IMD555/BTKB/Photo/WP_20181024_00_50_31_Pro_LI (2).jpg

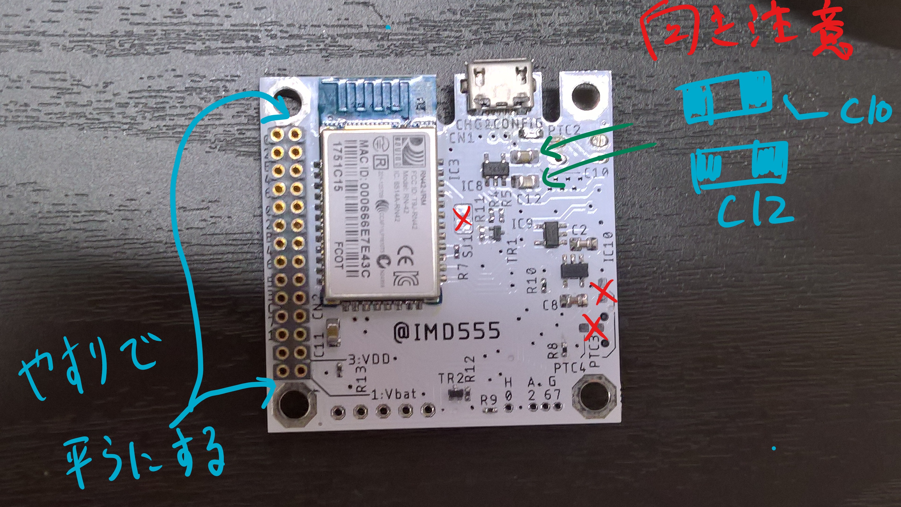
Photo/WP_20181024_00_50_31_Pro_LI (2).jpg
