IMD555/BTKB/Photo/WP_20181027_11_53_10_Pro.jpg

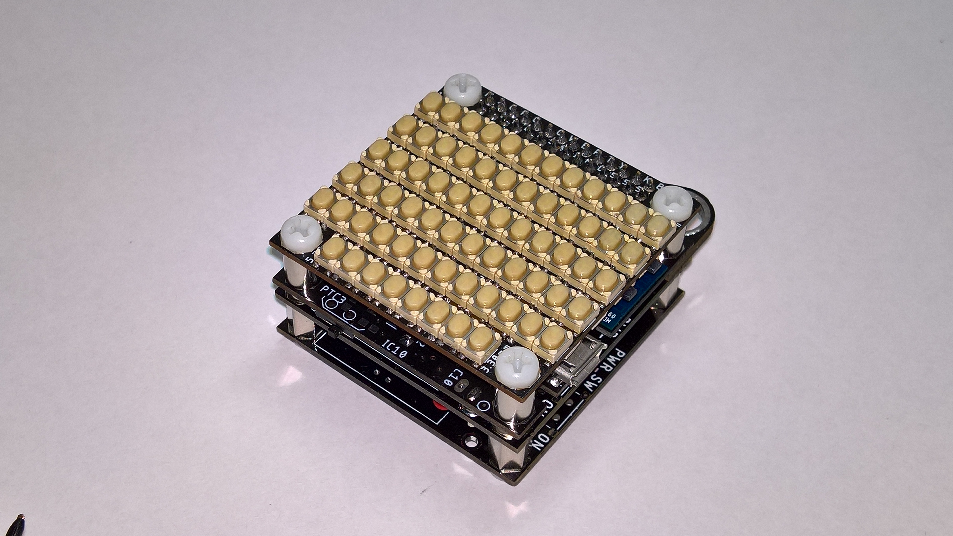
Photo/WP_20181027_11_53_10_Pro.jpg
