IMD555/BTKB/Datasheet/THAM05-N.jpg

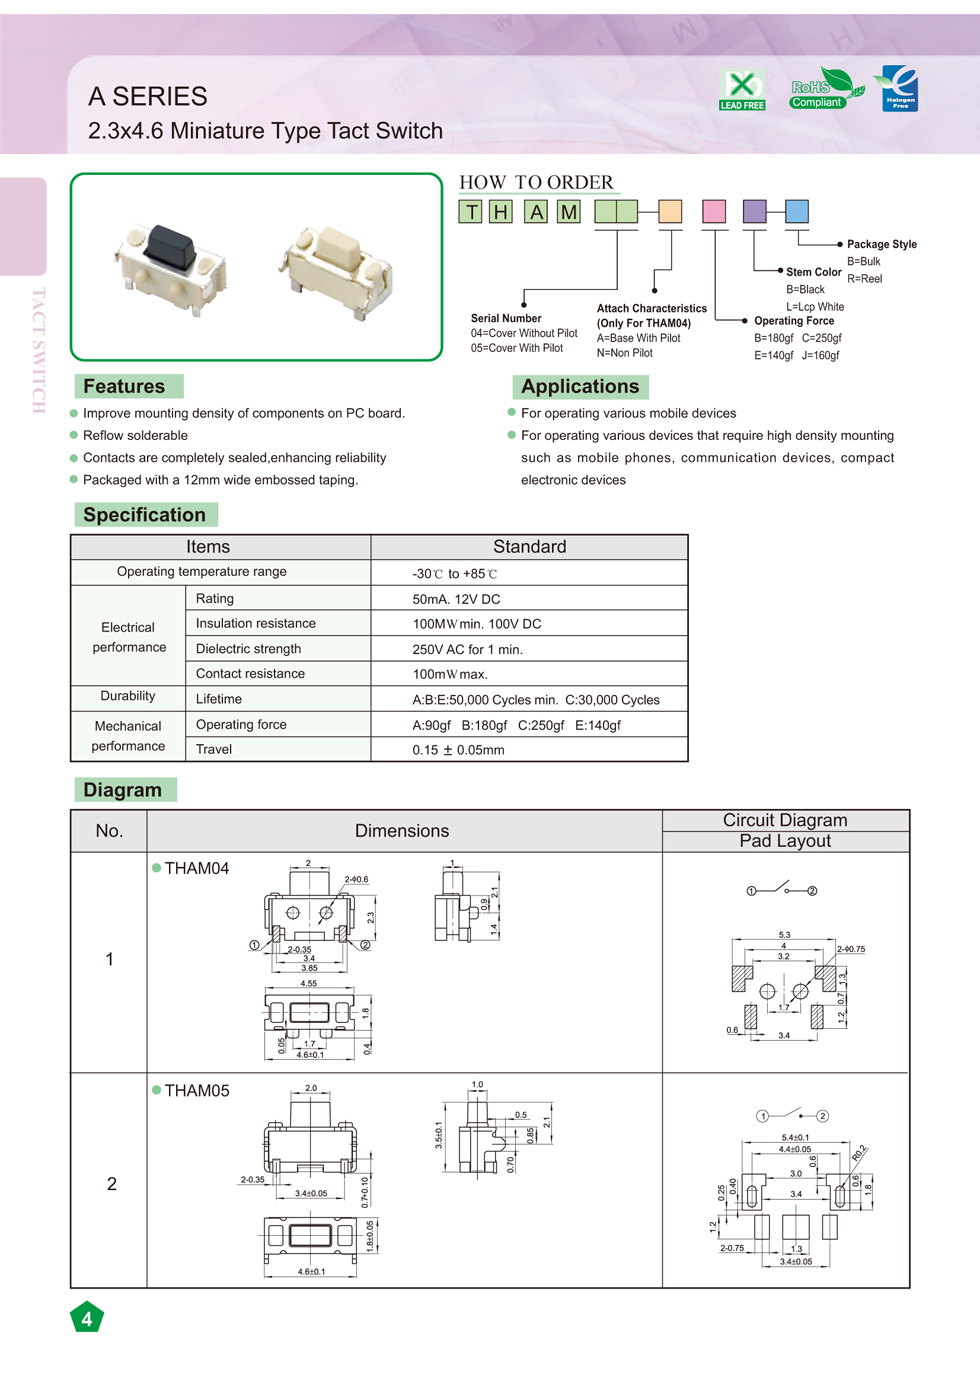
Datasheet/THAM05-N.jpg
