IMD555/BTKB/ORIGINAL_キーマップ.png

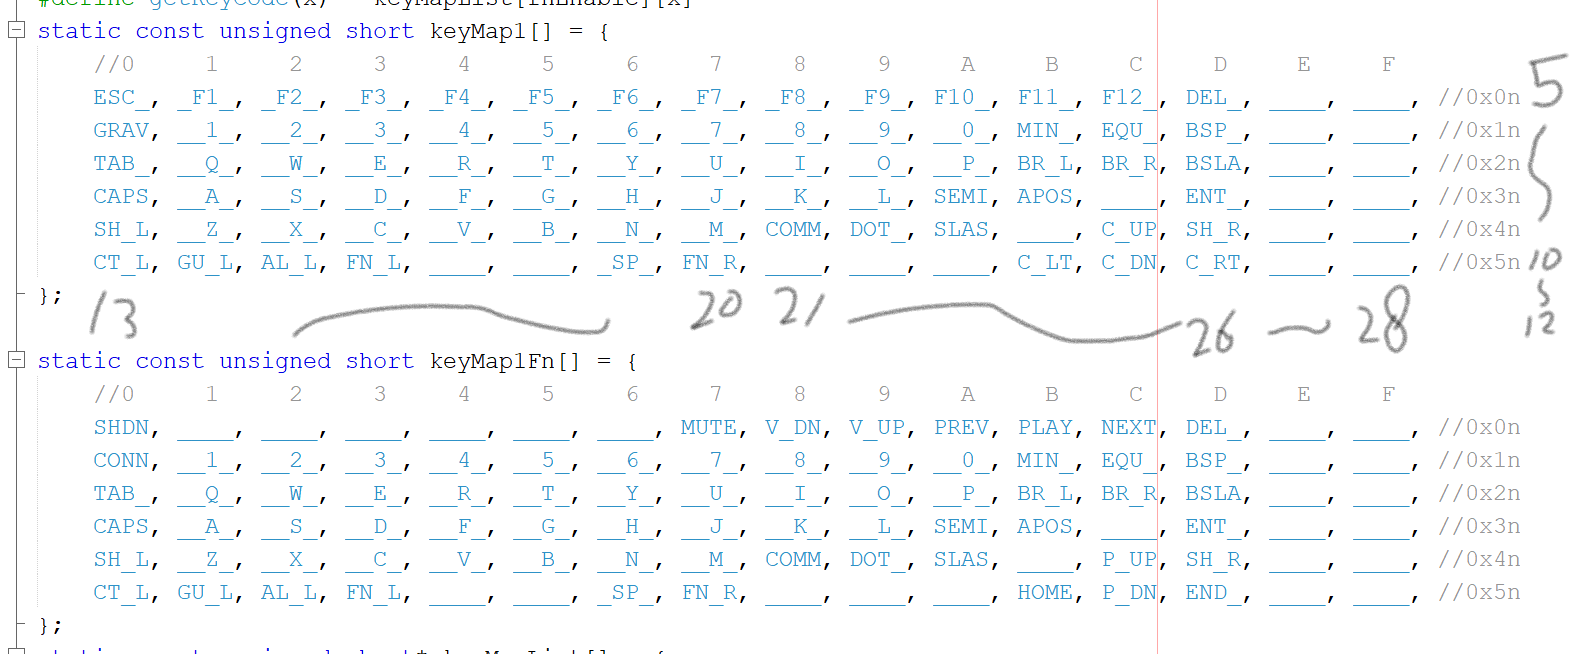
ORIGINAL_キーマップ.png
