IMD555/BTKB/Photo/backlight.png

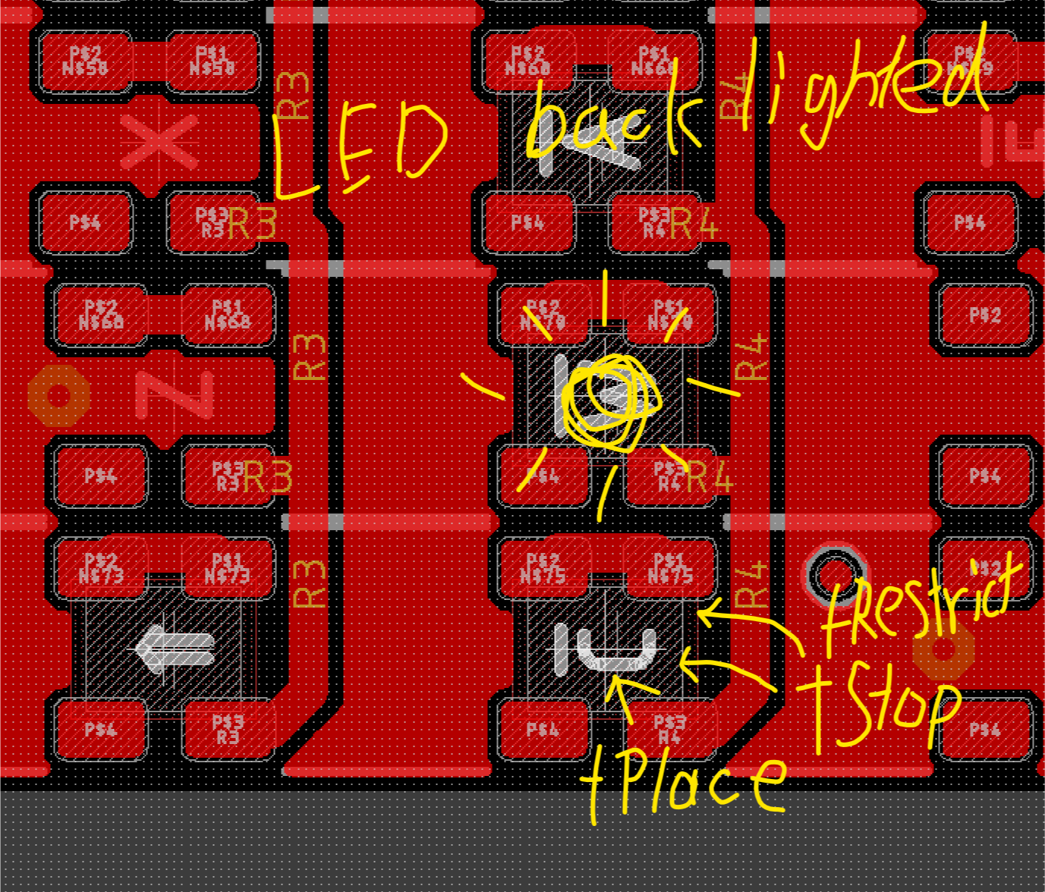
Photo/backlight.png
