IMD555/BTKB/Photo/booth.png

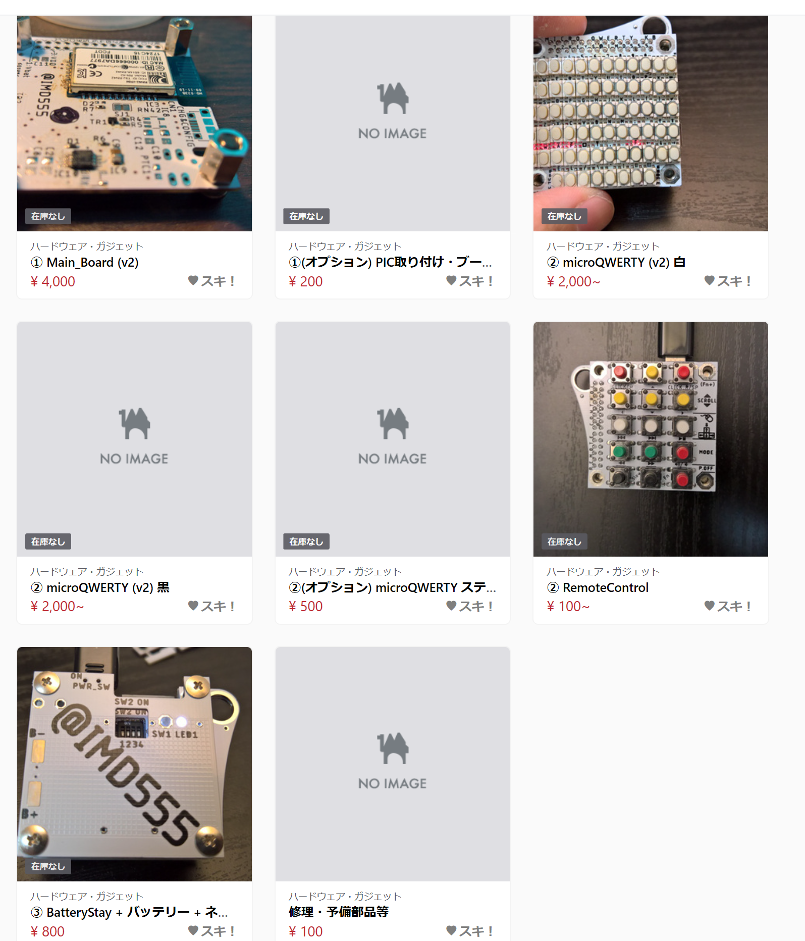
Photo/booth.png
