IMD555/BTKB/Photo/InkedJIS_LI.jpg

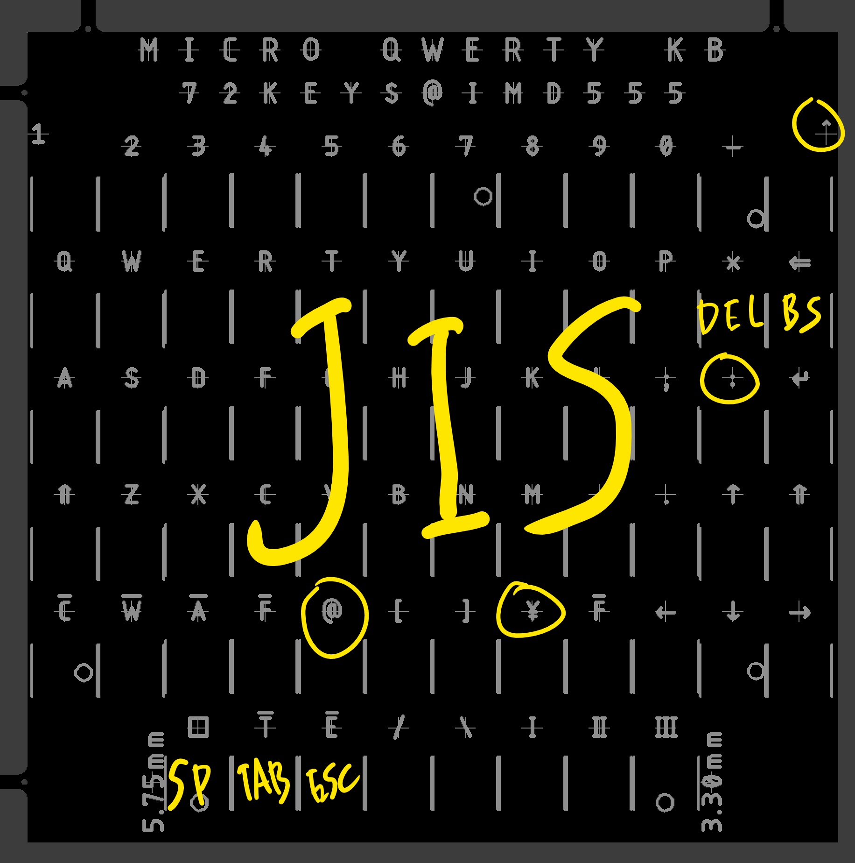
Photo/InkedJIS_LI.jpg
