IMD555/BTKB/Photo/Inkedset_LI.jpg

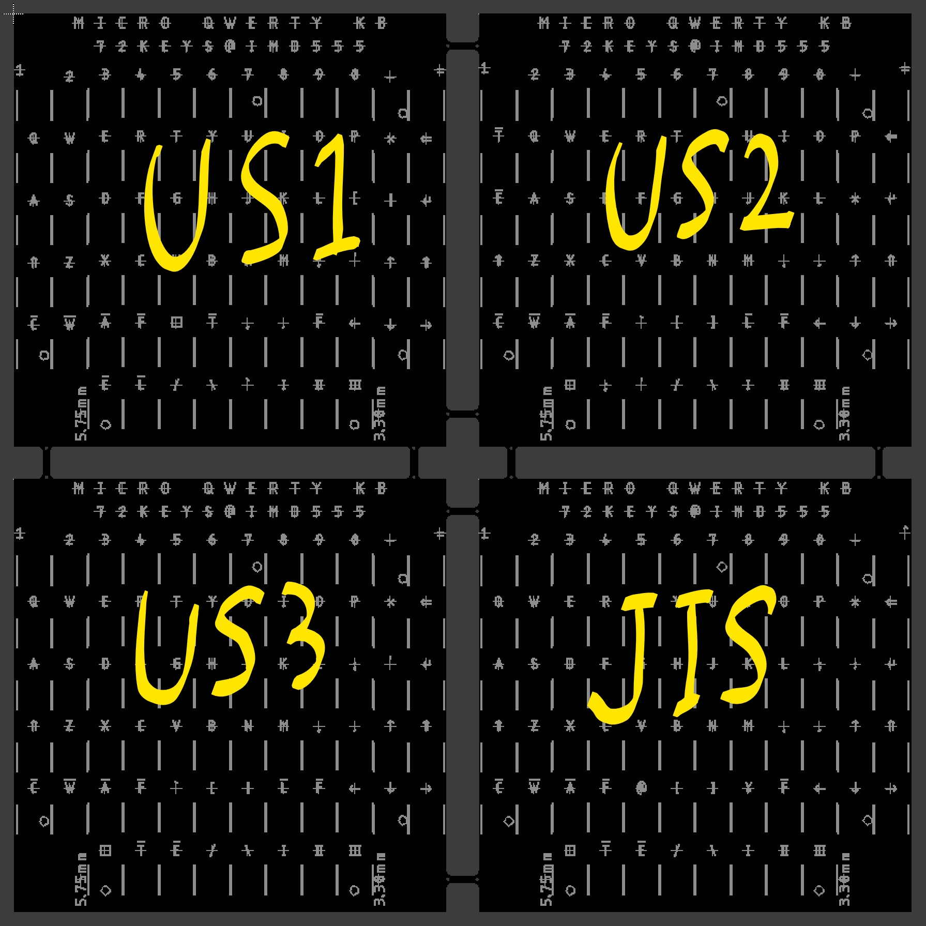
Photo/Inkedset_LI.jpg
