IMD555/BTKB/Photo/InkedUS1_LI.jpg

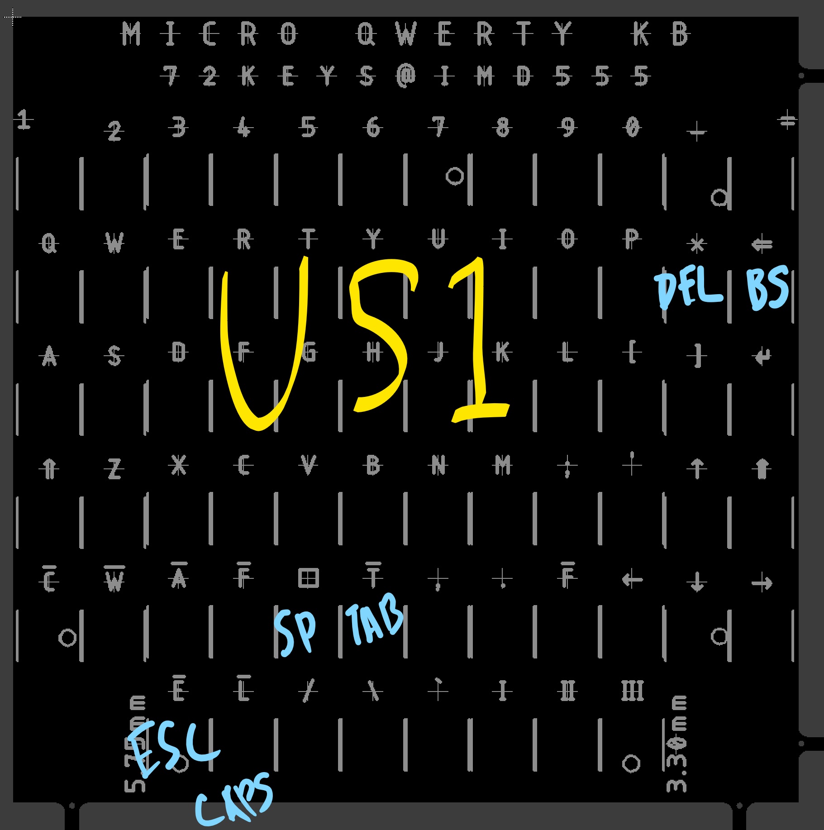
Photo/InkedUS1_LI.jpg
