IMD555/BTKB/Photo/InkedUS2_LI.jpg

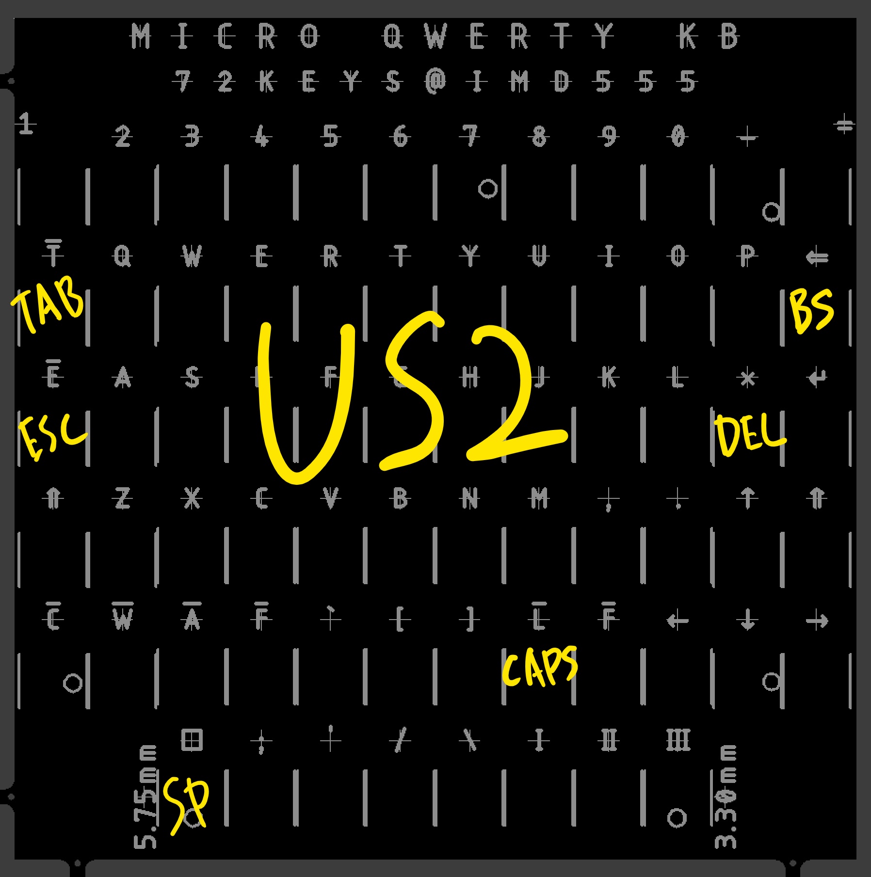
Photo/InkedUS2_LI.jpg
