IMD555/BTKB/Photo/InkedUS3_LI.jpg

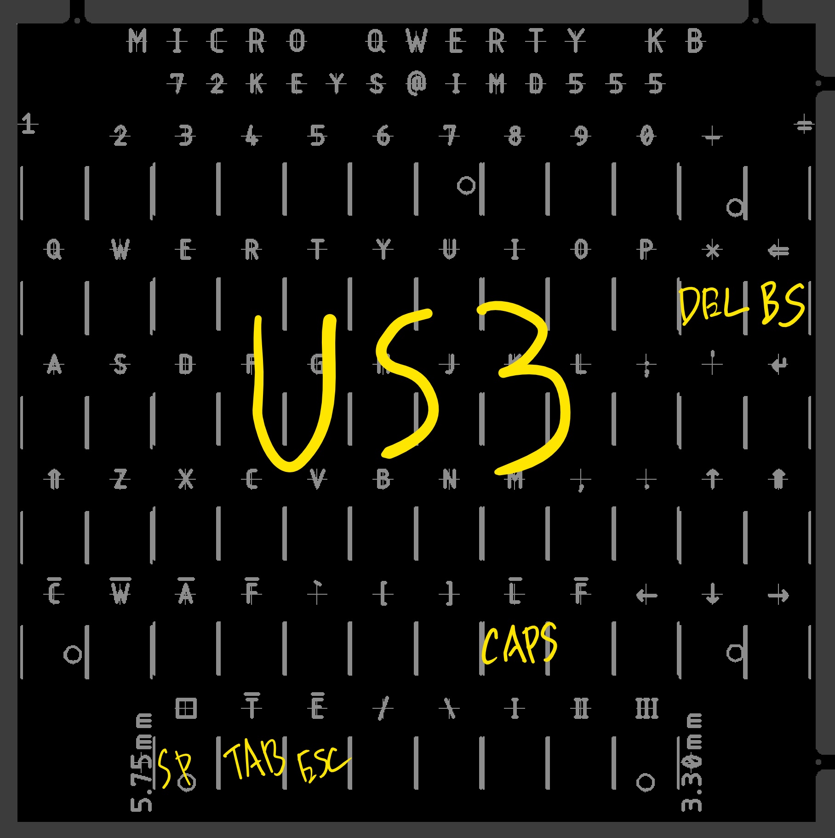
Photo/InkedUS3_LI.jpg
