IMD555/BTKB/Photo/JIS.png

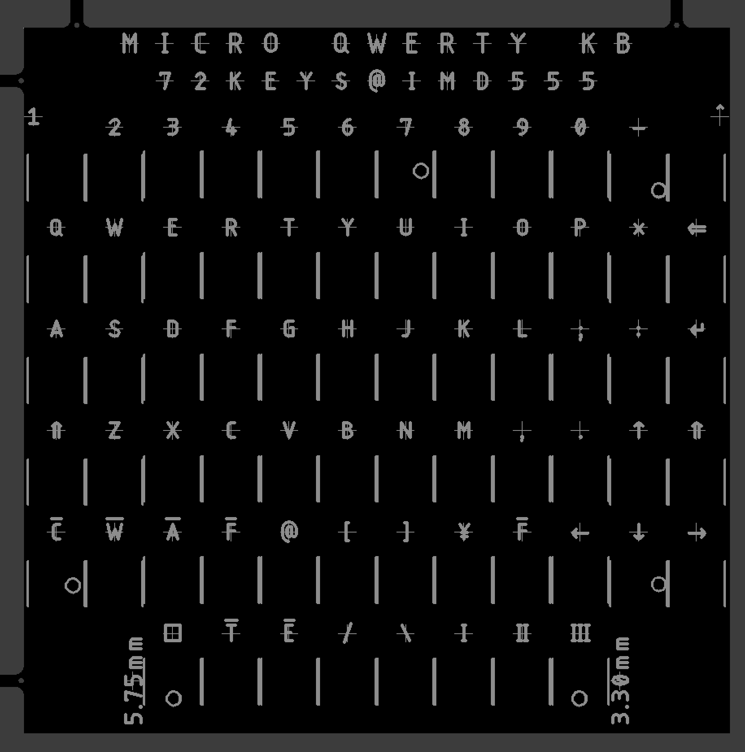
Photo/JIS.png
