IMD555/BTKB/Photo/set.png

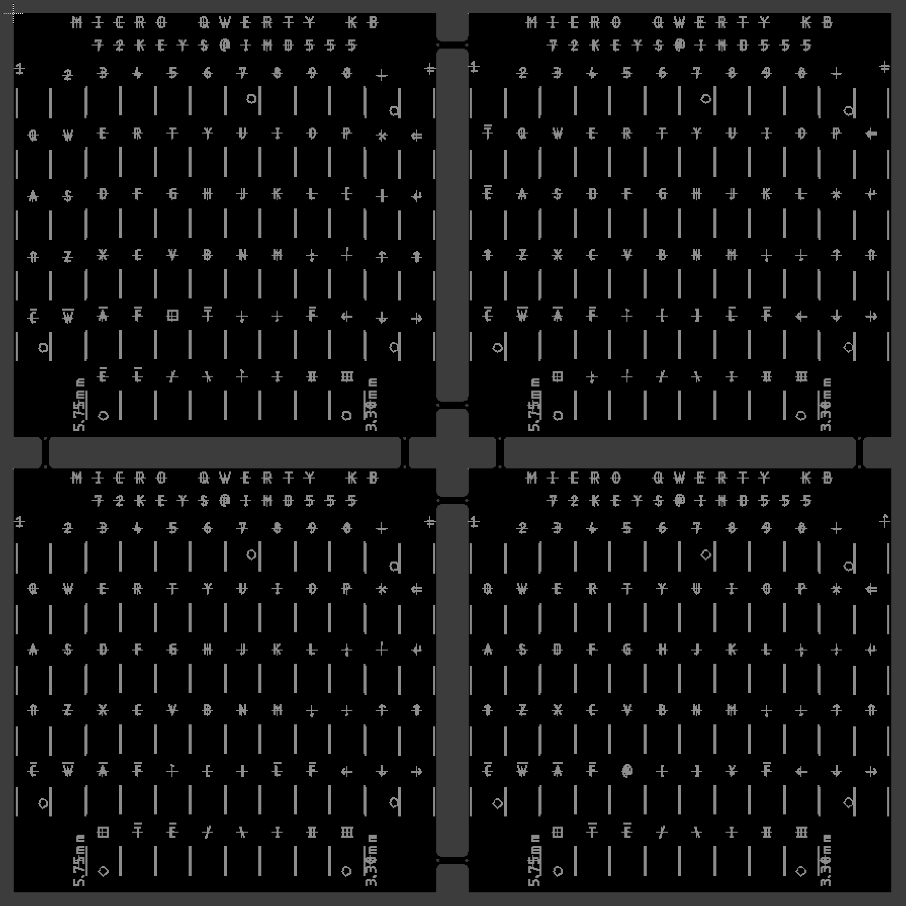
Photo/set.png
