IMD555/BTKB/Photo/US1.png

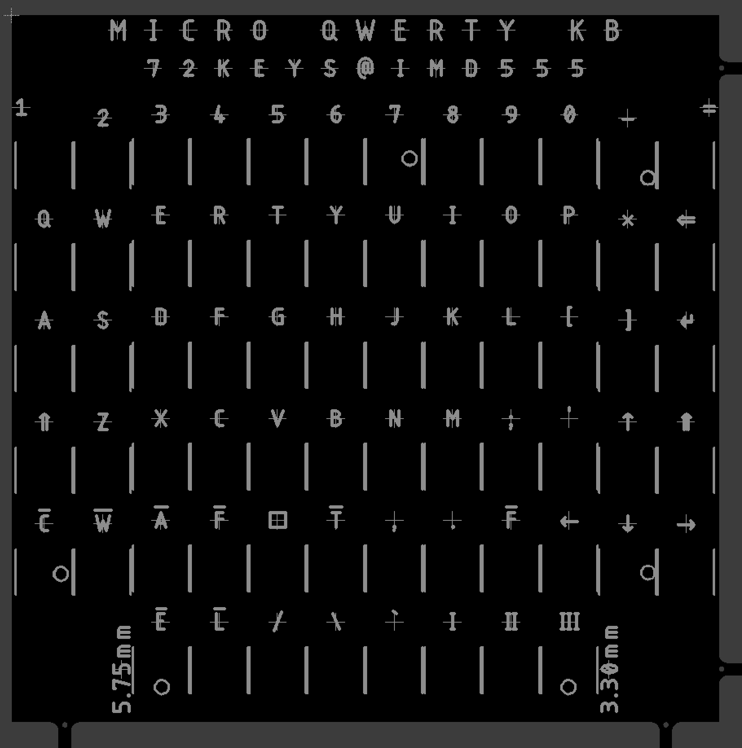
Photo/US1.png
