IMD555/BTKB/Photo/US2.png

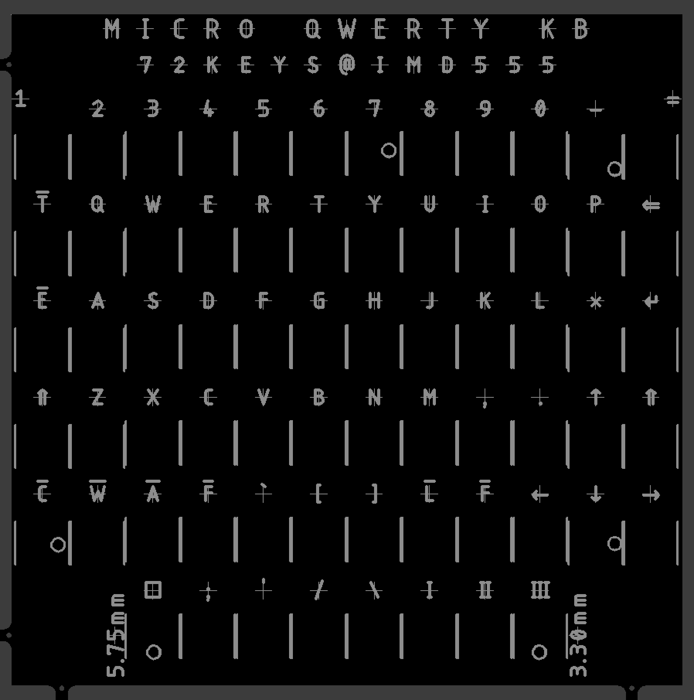
Photo/US2.png
