IMD555/BTKB/Photo/US3.png

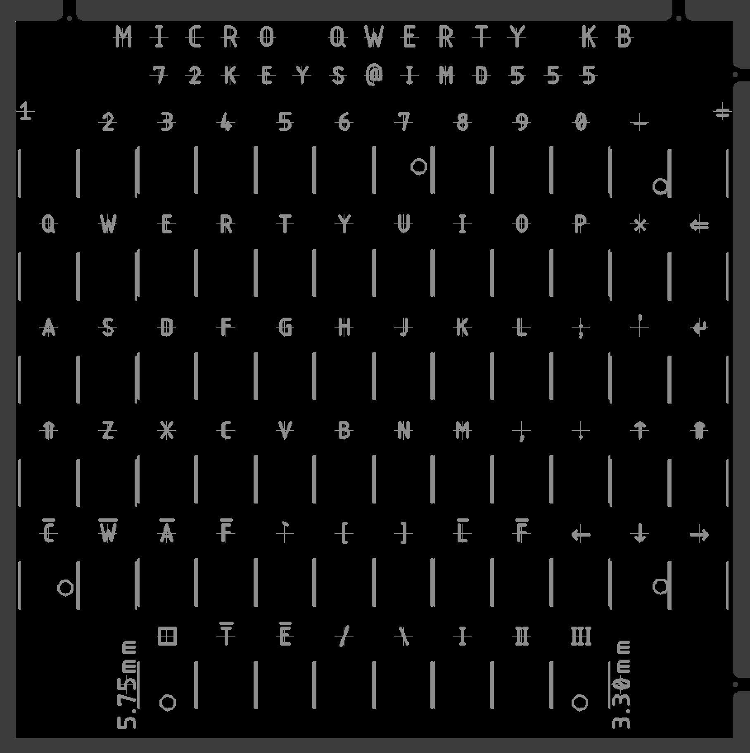
Photo/US3.png
