IMD555/BTKB/Photo/WP_20180513_21_15_03_Pro.jpg

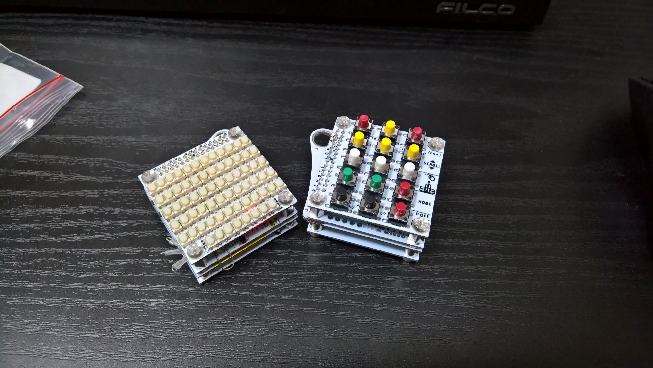
Photo/WP_20180513_21_15_03_Pro.jpg
