IMD555/BTKB/Photo/WP_20180825_12_07_29_Pro_LI.jpg

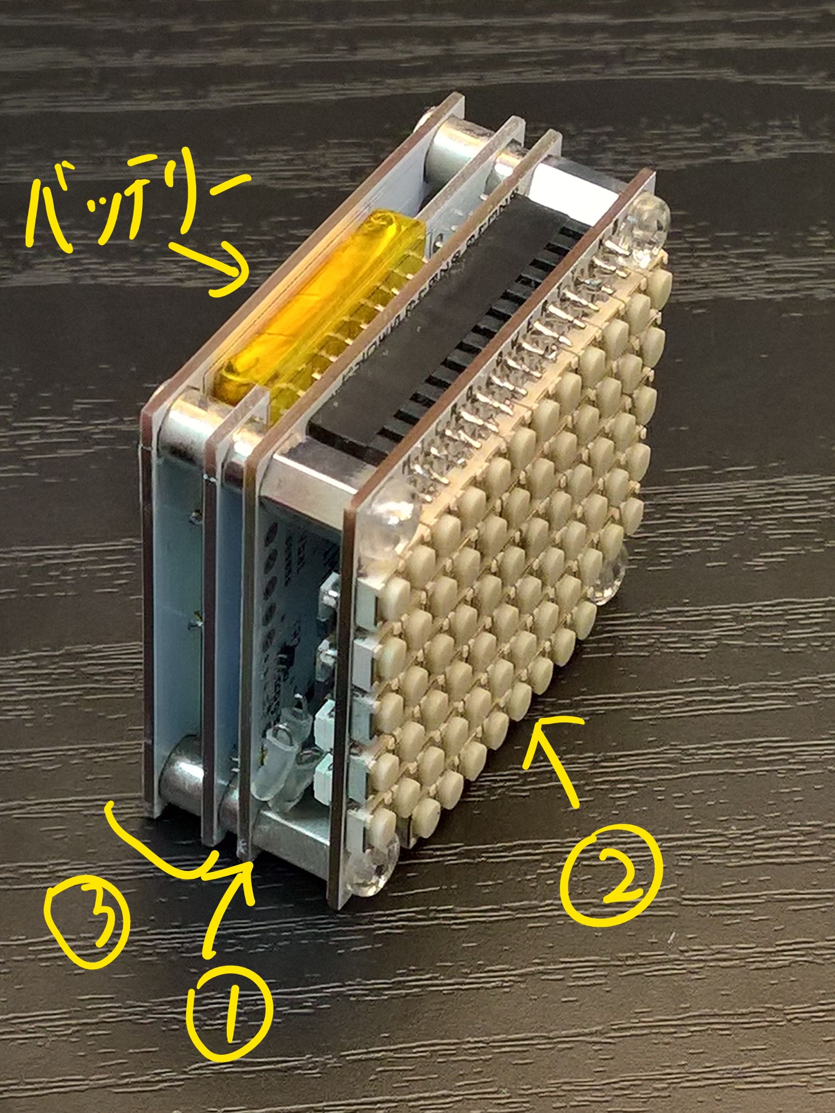
Photo/WP_20180825_12_07_29_Pro_LI.jpg
