IMD555/BTKB/Photo/WP_20181024_00_50_26_Pro_LI.jpg

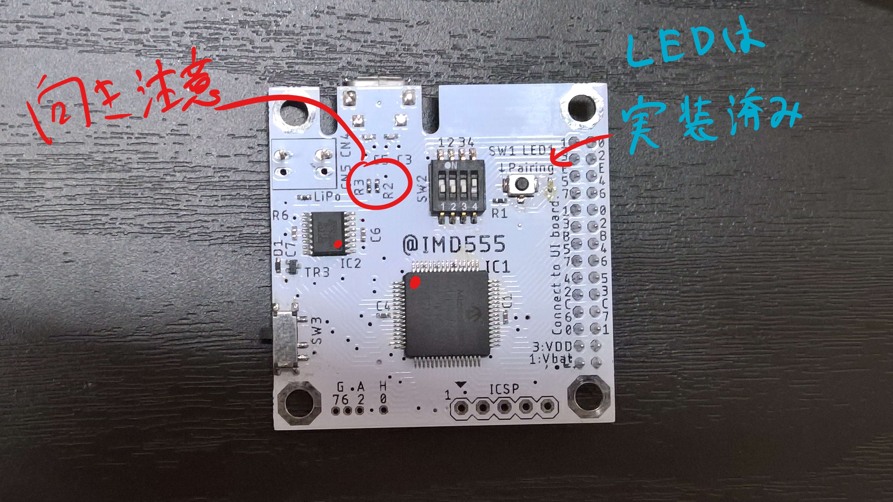
Photo/WP_20181024_00_50_26_Pro_LI.jpg
