IMD555/BTKB/Photo/WP_20181027_11_49_59_Pro.jpg

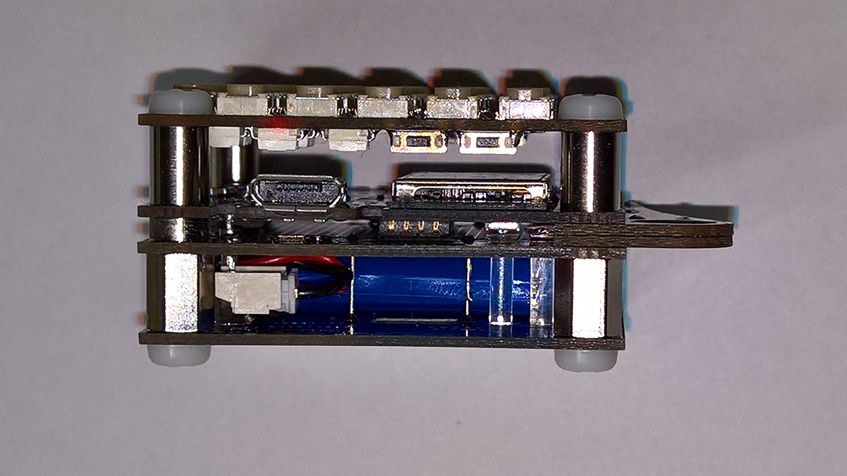
Photo/WP_20181027_11_49_59_Pro.jpg
