IMD555/BTKB/Photo/WP_20181027_11_50_17_Pro.jpg

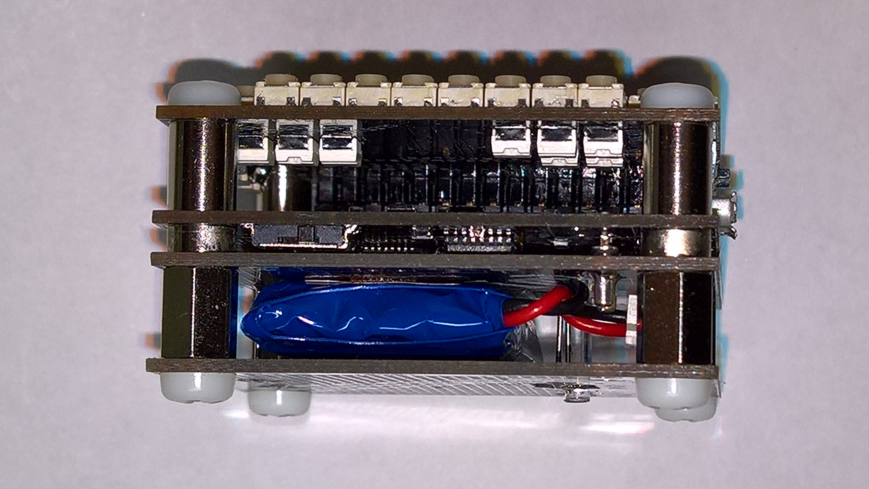
Photo/WP_20181027_11_50_17_Pro.jpg
