IMD555/BTKB/Photo/WP_20181027_11_50_39_Pro.jpg

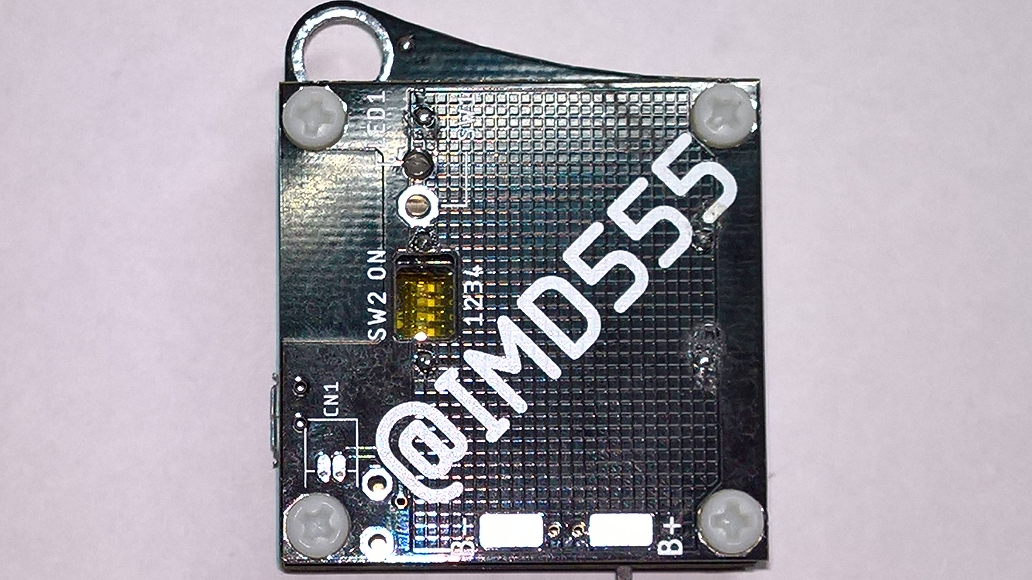
Photo/WP_20181027_11_50_39_Pro.jpg
