IMD555/BTKB/Photo/WP_20181027_11_52_42_Pro.jpg

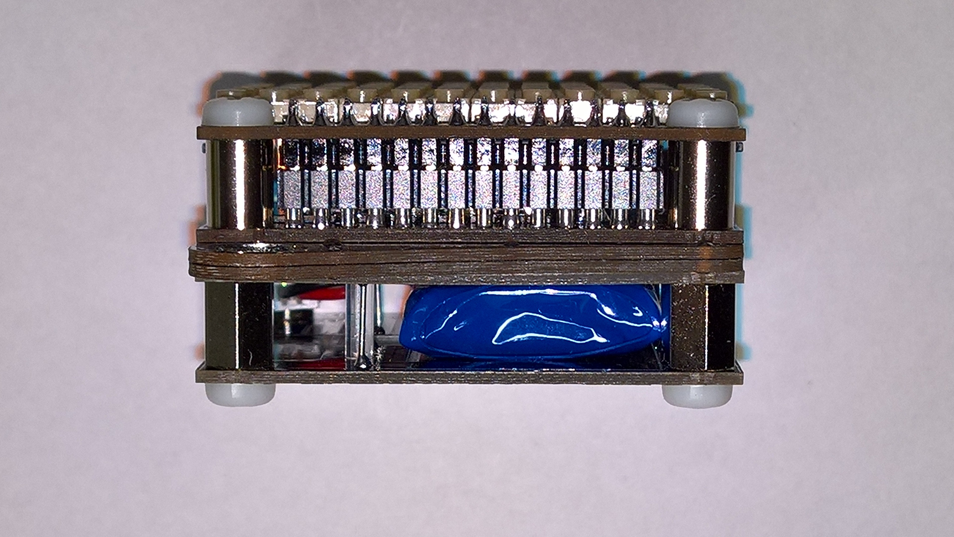
Photo/WP_20181027_11_52_42_Pro.jpg
