IMD555/BTKB/Photo/WP_20181027_11_58_30_Pro.jpg

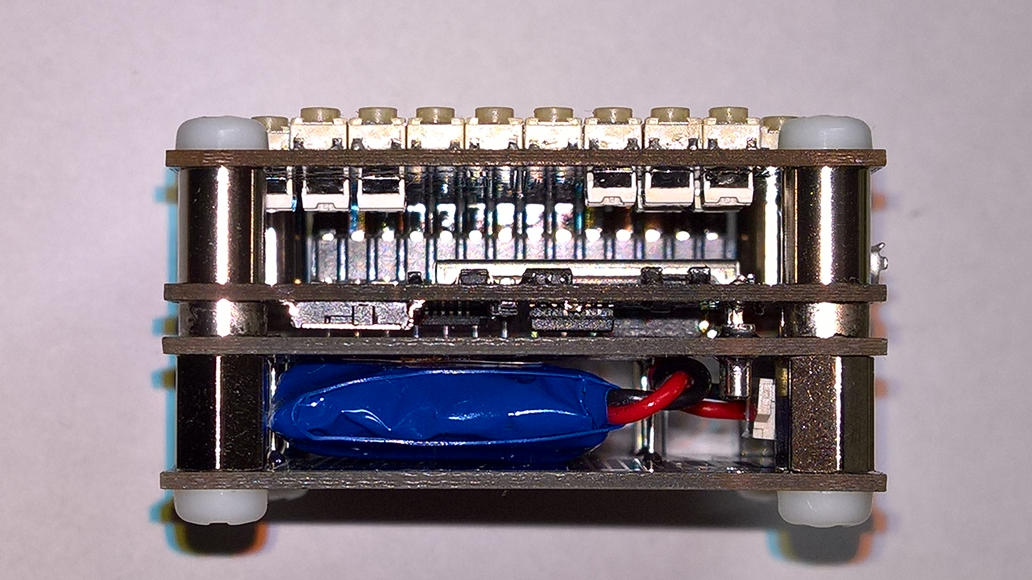
Photo/WP_20181027_11_58_30_Pro.jpg
