IMD555/BTKB/部品表.xlsx

Sheet: 部品表
 |  |  |  |  | 振込先:金融機関コード 0501 店番 485 普通預金 3086650 |  |  | yohewi | toby_net | Man_Nyomo | Mizincor | fafaway1234 | E_M_P_ | yohewi | toby_net | Man_Nyomo | Mizincor | fafaway1234 | E_M_P_
 |  |  |  |  | 名前 ｲﾏﾀﾞ ｶｽﾞﾎ |  |  |  |  |  |  |  |  | 合計金額
 |  |  |  |  | (北洋銀行 札幌市役所支店) |  |  |  |  |  |  |  |  | 5397 | 7379 | 5437 | 6294 | 4863 | 7379
実装順 | 部品番号 | 部品名 | 型番 | 形状 | 備考・注意事項 | 購入元 | 単価 | 数量 |  |  |  |  |  | 小計
 |  | 基板 | Main_Board | - | t1.0 パターン修正(別Sheet参照)・配線追加あり(別Sheet参照) |  | 0 | 1 | 1 | 1 | 1 | 1 | 1 | 0 | 0 | 0 | 0 | 0 | 0
0 | LED1 | LED(青) | SML-P13BC8TT86 | 1006 | 実装済み | Chip One Stop | 20 | 1 | 0 | 1 | 1 | 1 | 1 | 20 | 0 | 20 | 20 | 20 | 20
0 | *LED1 | LED(緑) | SML-P12MTT86R | 1006 | 実装済み | Chip One Stop | 20 | 0 | 1 | 0 | 0 | 0 | 0 | 0 | 20 | 0 | 0 | 0 | 0
1 | IC1 | マイコン | PIC18LF67K40 | TQFP64 | 一部ピンのみはんだ付け済み、ブートローダー書き込み済み 56-57ピン間は短絡していてOK はんだ付け参考 https://www.youtube.com/watch?v=-l5D2em4PBI | digikey | 301 | 1 | 1 | 1 | 1 | 1 | 1 | 301 | 301 | 301 | 301 | 301 | 301
1 | IC2 | USB-UART IC | FT230X | SSOP16 | ズレないように注意! 10-11ピン間は短絡していてOK | digikey | 238 | 1 | 1 | 1 | 1 | 1 | 1 | 238 | 238 | 238 | 238 | 238 | 238
2 | IC10 | 3.3V電源IC | MCP1253-33X50 | MSOP8 | ズレないように注意! | Chip One Stop | 175 | 1 | 1 | 1 | 1 | 1 | 1 | 175 | 175 | 175 | 175 | 175 | 175
2 | IC3 | Bluetoothモジュール | RN42 |  | 四隅の内側に入っているパッドははんだ付けしなくてよい フラックスクリーナー等でこするとインクが薄くなるので、技適マークを消さないように注意 | 秋月電子 | 1800 | 1 | 1 | 1 | 1 | 1 | 1 | 1800 | 1800 | 1800 | 1800 | 1800 | 1800
2 | IC8 | LiPo充電IC | MCP73832 | SOT23-5 | KK5I、IC9と間違えないように！ | digikey | 62 | 1 | 1 | 1 | 1 | 1 | 1 | 62 | 62 | 62 | 62 | 62 | 62
2 | IC9 | 低電圧検出IC | BD4931G | SOT23-5 | FM0Q19、IC8と間違えないように！ | Chip One Stop | 30 | 1 | 1 | 1 | 1 | 1 | 1 | 30 | 30 | 30 | 30 | 30 | 30
2 | CN1 | USBコネクタ | 10118194-0001LF |  | イモハンダにならないように注意(特にGNDの5ピン) 内側にハンダが入らないように、シールドは裏側からはんだ付け推奨 シールド中央のパッドははんだ付けしなくてよい | digikey | 54 | 1 | 1 | 1 | 1 | 1 | 1 | 54 | 54 | 54 | 54 | 54 | 54
3 | PTC1 | リセッタブルヒューズ | 250mA 100mA 0ZCM0010FF2G | 1608 |  | digikey | 19 | 1 | 1 | 1 | 1 | 1 | 1 | 19 | 19 | 19 | 19 | 19 | 19
3 | C9 | コンデンサ 1u |  | 2012 |  | RS? | 5 | 1 | 1 | 1 | 1 | 1 | 1 | 5 | 5 | 5 | 5 | 5 | 5
3 | C2, C8, C10, C11, C12 | コンデンサ 4.7u |  | 2012 | C11のみ縦向き(他は横) | digikey | 7 | 5 | 5 | 5 | 5 | 5 | 5 | 35 | 35 | 35 | 35 | 35 | 35
4 | C1, C4, C6, C7 | コンデンサ 0.1u |  | 1005 | 予備1 | digikey | 1 | 5 | 5 | 5 | 5 | 5 | 5 | 5 | 5 | 5 | 5 | 5 | 5
4 | C3, C5 | コンデンサ 47p |  | 1005 | 予備1 | digikey | 1 | 3 | 3 | 3 | 3 | 3 | 3 | 3 | 3 | 3 | 3 | 3 | 3
5 | R1 | 抵抗 330 |  | 1005 | 予備1、LEDが眩しいためR1は1kか3.3k推奨、抵抗は黒い面が表 | digikey | 1 | 2 | 2 | 2 | 2 | 2 | 2 | 2 | 2 | 2 | 2 | 2 | 2
5 | *R1 | 抵抗 1k |  | 1005 | 予備1 | digikey | 1 | 2 | 2 | 2 | 2 | 2 | 2 | 2 | 2 | 2 | 2 | 2 | 2
5 | R2, R3 | 抵抗 27 |  | 1005 | 予備1 | digikey | 1 | 3 | 3 | 3 | 3 | 3 | 3 | 3 | 3 | 3 | 3 | 3 | 3
6 | R4, R7, R9, R10 | 抵抗 10k |  | 1005 | 予備1、R10はD1に実装 | digikey | 1 | 5 | 5 | 5 | 5 | 5 | 5 | 5 | 5 | 5 | 5 | 5 | 5
6 | R5 | 抵抗 3.3k |  | 1005 | 予備1 | digikey | 1 | 2 | 2 | 2 | 2 | 2 | 2 | 2 | 2 | 2 | 2 | 2 | 2
6 | R8 | 抵抗 33k |  | 1005 | 予備1 | digikey | 1 | 2 | 2 | 2 | 2 | 2 | 2 | 2 | 2 | 2 | 2 | 2 | 2
6 | D2 | ダイオード | RB520CS | VMN2 | SJ1側がカソードインデックス | Chip One Stop | 20 | 1 | 1 | 1 | 1 | 1 | 1 | 20 | 20 | 20 | 20 | 20 | 20
6 | TR1, TR2 | MOSFET | DMG1012T-7 | SOT523 |  | Chip One Stop | 6 | 2 | 2 | 2 | 2 | 2 | 2 | 12 | 12 | 12 | 12 | 12 | 12
6 | 追加配線 | 単心ワイヤー(心線0.6mm以下) |  |  | 難易度が上がるため、配線追加はピンソケット実装前に行うこと(前述、別Sheet参照)
7 | CN2 | ピンソケット (ピンヘッダーから変更) | 半分のNPPN302AFCN-RC |  | スペーサーに干渉するため、両端をピンヘッダーと同じ長さまでやすりで整える ハンダが樹脂部分まで上がるとピンヘッダーが刺さらなくなるので、ハンダをかなり少なめにする 刺さらなくなってしまった場合、一度取り外し、同封の余り部分のピンを差し替える | digikey | 200 | 1 | 1 | 1 | 1 | 1 | 1 | 200 | 200 | 200 | 200 | 200 | 200
8 | CN4, CN5 | PHコネクタ | S2B-PH-K-S |  | Battery_Stay未使用の場合、どちらかに実装 少し削れば表にも実装可能 | 秋月電子 | 30 | 1 | 1 | 1 | 1 | 0 | 1 | 30 | 30 | 30 | 30 | 0 | 30
8 | *CN4, CN5 | ピンヘッダーのピン | PH2-2X40SBGの余りピン |  | Battery_Stay使用の場合、裏側に5mm程度出るように実装 | 秋月電子 | 0 | 2 | 2 | 2 | 2 | 2 | 2 | 0 | 0 | 0 | 0 | 0 | 0
9 | SW1 | タクトスイッチ | B3U-1100P-B |  | フラックスが入って動作しなくなるため洗浄不可、洗浄後に取り付け推奨 | digikey | 125 | 1 | 1 | 1 | 1 | 1 | 1 | 125 | 125 | 125 | 125 | 125 | 125
9 | SW2 | DIPスイッチ | EHS104LD | SOP8 | 同、洗浄後に取り付け推奨 | 秋月電子 | 100 | 1 | 1 | 1 | 1 | 1 | 1 | 100 | 100 | 100 | 100 | 100 | 100
- | ICSP | ICSP書き込みパッド |  |  | PICkit3等を使うとき接続 | - |  |  |  |  |  |  |  | 0 | 0 | 0 | 0 | 0 | 0
- | SJ1 | ショートパッド |  |  | ショートしない | - |  |  |  |  |  |  |  | 0 | 0 | 0 | 0 | 0 | 0
- | R6 | 抵抗 |  | 1005 | 実装しない | - |  |  |  |  |  |  |  | 0 | 0 | 0 | 0 | 0 | 0
 |  |  |  |  |  |  |  |  |  |  |  |  |  | 0 | 0 | 0 | 0 | 0 | 0
 |  | 基板 | Micro_QWERTY |  | t1.0 | Fusion PCB | 0 | 0 | 1 | 0 | 1 | 1 | 1 | 0 | 0 | 0 | 0 | 0 | 0
1 | SW101-160,SW163-170 | タクトスイッチ | SKRPACE010 |  | 予備2、先にリフローで実装するのが楽 | 秋月電子 | 20 | 0 | 70 | 0 | 70 | 0 | 70 | 0 | 1400 | 0 | 1400 | 0 | 1400
2 | CN101 | ピンヘッダー | 半分のPH2-2X40SBG |  |  | 秋月電子 | 25 | 0 | 1 | 0 | 1 | 1 | 1 | 0 | 25 | 0 | 25 | 25 | 25
2 | SW161,SW162,SW171,SW172 | タクトスイッチ(サイド) | THAM05-N |  |  | アイテンドー | 35 | 0 | 4 | 0 | 4 | 4 | 4 | 0 | 140 | 0 | 140 | 140 | 140
2 | LED101-112 | LED | LS T776-P2S1-1-Z |  | 向きバラバラなので注意 | digikey | 31 | 0 | 12 | 0 | 12 | 12 | 12 | 0 | 372 | 0 | 372 | 372 | 372
2 | R101-104 | 抵抗 | 100 | 1005 | 予備1 | digikey | 1 | 0 | 5 | 0 | 5 | 5 | 5 | 0 | 5 | 0 | 5 | 5 | 5
 |  |  |  |  |  |  |  |  |  |  |  |  |  | 0 | 0 | 0 | 0 | 0 | 0
 |  | 基板 | REMOTE_CONTROL |  | t1.0 | Fusion PCB | 0 | 1 | 1 | 1 | 0 | 1 | 1 | 0 | 0 | 0 | 0 | 0 | 0
 | SW101-112 | タクトスイッチ | ? |  | 浮かないように | 梅沢無線 | 5 | 0 | 12 | 12 | 0 | 0 | 12 | 0 | 60 | 60 | 0 | 0 | 60
 | CN101 | ピンヘッダー | 半分のPH2-2X40SBG |  |  | 秋月電子 | 25 | 0 | 1 | 1 | 0 | 1 | 1 | 0 | 25 | 25 | 0 | 25 | 25
 |  |  |  |  |  |  |  |  |  |  |  |  |  | 0 | 0 | 0 | 0 | 0 | 0
 |  | 基板 | Wiring_board |  | t1.0、配線引き出し用 | Fusion PCB | 0 | 4 | 0 | 0 | 0 | 0 | 0 | 0 | 0 | 0 | 0 | 0 | 0
 | *CN101 | ピンヘッダー | 半分のPH2-2X40SBG |  |  | 秋月電子 | 25 | 1 | 0 | 0 | 0 | 0 | 0 | 25 | 0 | 0 | 0 | 0 | 0
 | CN101 | ピンヘッダーR/A | NRPN142PARN-RC |  |  | digikey | 316 | 1 | 0 | 0 | 0 | 0 | 0 | 316 | 0 | 0 | 0 | 0 | 0
 |  |  |  |  |  |  |  |  |  |  |  |  |  | 0 | 0 | 0 | 0 | 0 | 0
 |  | 基板 | Battery_Stay |  | t1.0 | Fusion PCB | 0 | 0 | 2 | 2 | 2 | 2 | 2 | 0 | 0 | 0 | 0 | 0 | 0
 | PWR_SW | スライドスイッチ | MA12R |  | 電源スイッチ | digikey | 106 | 0 | 1 | 1 | 1 | 1 | 1 | 0 | 106 | 106 | 106 | 106 | 106
 |  | ICソケットのピン | ? |  | *CN4,CN5に実装する「ピンヘッダーのピン」と接続 | ？ | 0 | 2 | 2 | 2 | 2 | 2 | 2 | 0 | 0 | 0 | 0 | 0 | 0
 |  | タミヤ 透明ソフトプラ棒 | ITEM70158-400 |  | SW1の押し棒、LED1の導光 | 東急ハンズ | 20 | 1 | 1 | 1 | 1 | 1 | 1 | 20 | 20 | 20 | 20 | 20 | 20
 |  |  |  |  |  |  |  |  |  |  |  |  |  | 0 | 0 | 0 | 0 | 0 | 0
 |  | スペーサ M3x2 通し穴 | CB-302-5E |  | Main_BoardとBattery_Stay(上)間 | ヒロスギネット | 15 | 4 | 6 | 6 | 6 | 6 | 6 | 60 | 90 | 90 | 90 | 90 | 90
 |  | スペーサ M3x4 通し穴 | CB-304-5E |  | Battery_Stay(上)とBattery_Stay(下)間 | ヒロスギネット | 15 | 0 | 4 | 4 | 4 | 4 | 4 | 0 | 60 | 60 | 60 | 60 | 60
 |  | スペーサ M3x6.5 メス-メス | ASB-306.5-5E |  | Main_BoardとMicro_QWERTY/REMOTE_CONTROL間 | ヒロスギネット | 25 | 0 | 4 | 4 | 4 | 4 | 4 | 0 | 100 | 100 | 100 | 100 | 100
 |  | ネジ ポリカM3x5 | ？ |  | 裏からのネジとぶつかる場合、削ってM3x4にする | 梅沢無線 | 16 | 4 | 4 | 4 | 4 | 4 | 4 | 64 | 64 | 64 | 64 | 64 | 64
 |  | PHコネクタコンタクト | SPH-002T-P0.5L |  | 予備3 | 秋月電子 | 4 | 5 | 5 | 5 | 5 | 0 | 5 | 20 | 20 | 20 | 20 | 0 | 20
 |  | PHコネクタハウジング | PHR-2 |  | 逆電圧無保護なので極性に注意 | 秋月電子 | 6 | 1 | 1 | 1 | 1 | 0 | 1 | 6 | 6 | 6 | 6 | 0 | 6
 |  |  |  |  |  |  |  |  |  |  |  |  |  | 0 | 0 | 0 | 0 | 0 | 0
 |  | キーホルダー化基板 | - |  | t1.0、2枚重ねてMain_BoardとBattery_Stay(上)間に(スペーサーの代わりに)取り付ける | Fusion PCB | 0 | 2 | 2 | 2 | 2 | 2 | 2 | 0 | 0 | 0 | 0 | 0 | 0
 |  | 熱収縮チューブ |  |  | LiPo周辺の保護用 | ？ | 0 | 1 | 1 | 1 | 1 | 1 | 1 | 0 | 0 | 0 | 0 | 0 | 0
 |  | LiPoバッテリー(1セル) |  |  | ご用意ください。20×37×6mm以内はBattery_Stayに適合。 |  | 0 | 0 | 0 | 0 | 0 | 0 | 0 | 0 | 0 | 0 | 0 | 0 | 0
 |  | ネジ M3x12～15 |  |  | 電池の厚みに合わせてご用意ください。 |  | 0 | 0 | 0 | 0 | 0 | 0 | 0 | 0 | 0 | 0 | 0 | 0 | 0
 |  |  |  |  |  |  |  |  |  |  |  |  |  | 0 | 0 | 0 | 0 | 0 | 0
 |  | 送料・手数料 |  |  |  |  | 1000 | 1 | 1 | 1 | 0 | 0 | 1 | 1000 | 1000 | 1000 | 0 | 0 | 1000
 |  | 部品購入送料 秋月 |  |  |  |  | 500 | 0.125 | 0.125 | 0.125 | 0.125 | 0.125 | 0.125 | 63 | 63 | 63 | 63 | 63 | 63
 |  | 部品購入送料 C1S |  |  |  |  | 0 | 0.125 | 0.125 | 0.125 | 0.125 | 0.125 | 0.125 | 0 | 0 | 0 | 0 | 0 | 0
 |  | 部品購入送料 Digikey |  |  |  |  | 0 | 0.125 | 0.125 | 0.125 | 0.125 | 0.125 | 0.125 | 0 | 0 | 0 | 0 | 0 | 0
 |  | 部品購入送料 アイテンドー |  |  |  |  | 490 | 0.125 | 0.125 | 0.125 | 0.125 | 0.125 | 0.125 | 61 | 61 | 61 | 61 | 61 | 61
 |  | 部品購入送料 ヒロスギ |  |  |  |  | 300 | 0.125 | 0.125 | 0.125 | 0.125 | 0.125 | 0.125 | 38 | 38 | 38 | 38 | 38 | 38
 |  | 部品購入送料 Fusion PCB1 |  |  |  |  | 1669.2 | 0.125 | 0.125 | 0.125 | 0.125 | 0.125 | 0.125 | 209 | 209 | 209 | 209 | 209 | 209
 |  | 部品購入送料 Fusion PCB2 |  |  |  |  | 2118.6 | 0.125 | 0.125 | 0.125 | 0.125 | 0.125 | 0.125 | 265 | 265 | 265 | 265 | 265 | 265
 |  |  |  |  |  |  |  |  |  |  |  |  |  | 0 | 0 | 0 | 0 | 0 | 0

Sheet: パターン修正
21ピンに接続されているパターンを19ピンに繋ぎ変える

Sheet: 配線追加
RN42の3ピンとRA1を接続

Sheet: 動作確認等
電源周辺の確認
①電源を接続する前に、C2,C8,C10,C12の端子間が短絡していないこと
②USBを接続し、各コンデンサの電圧が下記電圧範囲内であること
・C2:4.0~4.2V(電池非接続時)
・C6:3.2~3.4V
・C8:3.2~3.4V
・C10:4.7~5.2V
・C12:4.1~4.2V(電池非接続時)
IC2(FT230X)の初期設定
①FTDIからFT_Progをダウンロード・インストールし、起動
②Scan and Parseでデバイスを認識させる(ポートをオープンしていない状態で)
③デバイスを右クリックし、Apply TemplateでBTKBフォルダのFT230X_Config_V1.01.xmlを指定
④Program DevicesでProgramを押してFinished Programが出れば成功
⑤FT_Progを終了する
PICが動作しているかの確認(ブートローダー書き込み済みの場合)
①ターミナルソフトで接続する(ボーレート:115200bps、フロー制御:ハードウェア(RTS/CTS)、データ:8ビット、ストップビット:1ビット、パリティ:なし)
②SW1をしばらく押すとLED1が点灯し、「Hello!(改行)send .hex file」が表示される
③文字を打つたびにLEDの状態が変わる
④qを打つとリセットが掛かり、SW1を押していると再びブートローダーが起動する
ブートローダー(ソフト書き換え)の仕様
・ターミナルソフト設定(ボーレート:115200bps、フロー制御:ハードウェア(RTS/CTS)、データ:8ビット、ストップビット:1ビット、パリティ:なし)
・起動時にSW1とSW2_4が同じ状態の場合(条件判定)、ブートローダーを起動する
・条件を満たさない場合、書き込まれたソフトを起動するが、書き込まれていない場合、条件判定を繰り返す
・ブートローダーが起動すると、LED1が点灯し、ターミナルソフトに「Hello!(改行)send .hex file」が表示される
・データを受信すると、1バイトごとにLED1の状態が切り替わる
・.hexファイルを送り、正常終了すると「SUCCESSFUL」が表示される
・.hexファイル受信時にエラーが起こるとエラーメッセージを表示する
・正常終了時、エラー時に「q」を送ると再起動し、条件判定する
裏のLEDの動作
遅い点滅 | 切断状態(ペアリング可能)
速い点滅 | コマンドモード
消灯 | 電源切れてる・接続状態
RN42の設定
・詳しい設定についてはBTKB\Datasheet\RN42\bluetooth_cr_UG-v1.0r.pdfを参照
・とりあえずコマンドモードで下の各行を送り、AOKが出るか確認する
PICにKBのソフトが書き込まれている状態で、$キーを押すとコマンドモードに入る(1秒かかる)
SN,microQWERTY | ←接続時に表示される名前
SM,4 | ←接続方法指定
S~,6 | ←HIDモード
SH,0037 | ←HIDの設定(マウスKB複合デバイス)
SO,- | ←接続・切断発生時の通知を有効化
SW,8050 | ←省電力設定(マウス機能も使う場合、設定しないほうがいい)
SY,FFF4 | ←無線出力を弱くする
SI SJ
ソフトデバッグのための文字(接続時の表示名に使用不可)
・「!」RN42をリセットする
・「@」RN42をリセット解除する
・「#」PICをリセットする(主にブートローダーに入るときに使用)
・「$」切断し、RN42の設定モードに入る コマンドモードに関してはRN42のデータシート参照
・「%」接続/切断

Sheet: ピン配置
Pin | 接続先 | microQWERTY | Remote Control | 機能1 |  | 機能2 |  |  | 使用可能機能
1 | Vbat | - | - | 電源
2 | GND | GND | GND | 電源
3 | VDD | - | - | 電源
4 | GND | GND | GND | 電源
5 | RC0 | キーY0 | キーY0 | キーY0 | 最上段(推奨) |  |  |  | I2C/SPI/UART/INT/PWM
6 | RC1 | キーY1 | キーY1 | キーY1 | コモン側 |  |  |  | I2C/SPI/UART/INT/PWM
7 | RC6 | キーY2 | キーY2 | キーY2 | 選択時L |  |  |  | I2C/SPI/UART/INT/PWM
8 | RC7 | キーY3 |  | キーY3 | D無しも可 |  |  |  | I2C/SPI/UART/INT/PWM
9 | RC2 | キーY4 |  | キーY4 |  |  |  |  | I2C/SPI/UART/INT/PWM
10 | RC3 | キーY5 |  | キーY5 |  |  |  |  | I2C/SPI/UART/INT/PWM
11 | RC4 |  |  | キーY6 |  |  |  |  | I2C/SPI/UART/INT/PWM
12 | RC5 |  |  | キーY7 |  |  |  |  | I2C/SPI/UART/INT/PWM
13 | RB7 | キーX0 | キーX1 | キーX0 | 最左列(推奨) |  |  |  | I2C/SPI/UART/INT/ADC
14 | RB6 | キーX1 | キーX0 | キーX1 |  |  |  |  | I2C/SPI/UART/INT/ADC
15 | RB5 | キーX2 | キーX2 | キーX2 |  |  |  |  | I2C/SPI/UART/INT/ADC
16 | RB4 | キーX3 | キーX4 | キーX3 |  |  |  |  | I2C/SPI/UART/INT/ADC
17 | RB3 | キーX4 | キーX3 | キーX4 |  |  |  |  | I2C/SPI/UART/INT/ADC
18 | RB2 | キーX5 |  | キーX5 |  |  |  |  | I2C/SPI/UART/INT/ADC
19 | RB1 | キーX6 |  | キーX6 |  |  |  |  | I2C/SPI/UART/INT/ADC
20 | RB0 | キーX7 |  | キーX7 |  |  |  |  | I2C/SPI/UART/INT/ADC
21 | RE7(RD1) | キーX8 |  | キーX8 |  | LED7 |  | https://en.wikipedia.org/wiki/Charlieplexing | I2C/SPI/UART/INT/ADC/PWM | GPIOエキスパンダ
22 | RE6(RD0) | キーX9 |  | キーX9 |  | LED6 |  |  | I2C/SPI/UART/INT/ADC/PWM | 可変抵抗
23 | RE5 | キーX10 |  | キーX10 |  | LED5 |  |  | UART/INT/ADC/PWM | 調光したいLED
24 | RE4 | キーX11 |  | キーX11 |  | LED4 |  |  | UART/INT/ADC/PWM | 加速度センサー
25 | RE3 | LED3 |  | キーX12 |  | LED3 |  |  | UART/INT/ADC/PWM | 照度センサー
26 | RE2 | LED2 |  | キーX13 |  | LED2 |  |  | UART/INT/ADC/PWM | などなど接続可
27 | RE1 | LED1 |  | キーX14 |  | LED1 |  |  | UART/INT/ADC/PWM
28 | RE0 | LED0 |  | キーX15 |  | LED0 | ↑0から使用 |  | UART/INT/ADC/PWM
