IMD555/BTKB/部品表v2.xlsx

Sheet: 部品表
1
2
3
4
5 | 実装順 | 部品番号 | 部品名 | 型番 | 形状 | 備考・注意事項 | 数量 | PJさんに渡した数
6 |  |  | 基板 | Main_Board | - | t1.0 | 1
7 | 0 | LED1 | LED(青) LED(赤) LED(白) LED(黄緑) LED(黄) LED(青緑) | SML-P13BC8TT86 SML-P12UTT86 SCMP13WBC8W SML-P12MTT86R SML-P12YTT86 SML-P13EC8TT86 | 1006 | 実装済み | 1
8 | 1 | IC1 | マイコン | PIC18LF67K40 | TQFP64 | ブートローダー書き込みオプションありの場合、実装済み はんだ付け参考 https://www.youtube.com/watch?v=-l5D2em4PBI | 1 | 2
9 | 1 | IC2 | USB-UART IC | FT230XS-R | SSOP16 | ズレないように注意! | 1 | 2
10 | 2 | IC10 | 3.1V電源IC | ‎NCP551SN31T1G‎ | SOT23-5 | LJM、他のICと間違えないように！ | 1 | 2
11 | 2 | IC3 | Bluetoothモジュール | RN42 |  | 四隅の内側に入っているパッドははんだ付けしなくてよい フラックスクリーナー等でこするとインクが薄くなるので、技適マークを消さないように注意 | 1 | 0
12 | 2 | IC8 | LiPo充電IC | MCP73832T-2ACI/OT | SOT23-5 | KK5I、他のICと間違えないように！ | 1 | 2
13 | 2 | IC9 | 低電圧検出IC | BD4931G | SOT23-5 | FM0Q19、他のICと間違えないように！ | 1 | 2
14 | 2 | CN1 | USBコネクタ | 10118194-0001LF |  | イモハンダにならないように注意(特にGNDの5ピン) 内側にハンダが入らないように、シールドは裏側からはんだ付け推奨 シールド中央のパッドははんだ付けしなくてよい | 1 | 2
15 | 3 | PTC2 | リセッタブルヒューズ | MF-FSMF050X-2 | 1608 | 1A 0.5A | 1 | 2
16 | 3 | PTC3,4 | リセッタブルヒューズ | MF-FSMF050X-2 | 1608 | スイッチ基板は電源不要なため省略 | 0
17 | 3 | C10, C11, C12 | コンデンサ 4.7u |  | 2012 | C11のみ縦向き(他は横) | 3
18 | 3 | C2, C8 | コンデンサ 1u | C1608X5R1C105K080AA | 1608 |  | 3
19 | 4 | C1, C4, C6, C7 | コンデンサ 0.1u |  | 1005 | 予備1 | 5
20 | 4 | C3, C5 | コンデンサ 47p |  | 1005 | 予備1 | 3
29 | 5 | TR1, TR2 | MOSFET | DMG1012T-7 | SOT523 | NMOS | 2 | 4
30 | 5 | TR3 | MOSFET | DMG1013T-7 | SOT523 | PMOS | 1 | 2
21 | 5 | R1 | 抵抗 330 | RC0402FR-07330RL | 1005 | 予備1、LEDが眩しいためR1は1kか3.3k推奨、抵抗は黒い面が表 | 2
22 | 5 | *R1 | 抵抗 1k | RC0402FR-071KL | 1005 | 予備1 | 2
23 | 5 | R2, R3 | 抵抗 27 |  | 1005 | 予備1 | 3 | 6
24 | 6 | R4, R7, R9, R10 | 抵抗 10k | RC0402FR-0710KL | 1005 | 予備2 | 6
25 | 6 | R5 | 抵抗 3.3k | RC0402FR-073K3L | 1005 | 予備1 | 2
26 | 6 | R6,R8 | 抵抗 33k | RC0402FR-0733KL | 1005 | 予備1 R6は裏 テープに3.3kと書いた上に横線で2つ、横線だけなのが1つ | 3
27 | 6 | R11,R12,R13 | 抵抗 100k |  | 1005 | 予備1 | 4
28 | 7 | D1 | ダイオード | RB520CS | VMN2 | スライドスイッチ側がカソードインデックス | 2 | 6
31 | 7 | CN2 | ピンソケット | 28ピンにした833-87-100-10-001101 |  | スペーサーに干渉するため、両端をピンヘッダーと同じ長さまでやすりで整える 浮かないように取り付ける 角はんだにならないように注意 必要ならはんだ面のピンを削って0.5mm程度短くする | 1 | 2
32 | 8 | CN4, CN5 | ピンヘッダーのピン | PH2-2X40SBGの余りピン |  | Battery_Stay使用の場合、裏側に5mm程度出るように実装 | 2 | 4
33 | 8 | *CN4, CN5 | PHコネクタ | S2B-PH-K-S |  | Battery_Stay未使用の場合、どちらかに実装 少し削れば表にも実装可能 | 0 | 0
34 | 9 | SW1 | タクトスイッチ | B3U-1100P-B |  | フラックスが入って動作しなくなるため洗浄不可、洗浄後に取り付け推奨 | 1 | 2
35 | 9 | SW2 | DIPスイッチ | EHS104LD | SOP8 | 同、洗浄後に取り付け推奨 | 1 | 0
36 | 9 | SW3 | スライドスイッチ | MSK12C01 |  | 電源スイッチ | 1 | 2
37 | - | ICSP | ICSP書き込みパッド |  |  | PICkit3等を使うとき接続
38 | - | SJ1 | ショートパッド |  |  | ショートしない
40
41 |  |  | 基板 | Micro_QWERTY |  | t1.0 | 0
42 | 1 | SW101-160,SW163-170 | タクトスイッチ | SKRPACE010 |  | 予備2、先にリフローで実装するのが楽 | 70 | 70
43 | 2 | CN101 | ピンヘッダー | 28ピンにしたPH2-2X40SBG |  |  | 1 | 1
44 | 2 | SW161,SW162,SW171,SW172 | タクトスイッチ(サイド) | THAM05 |  |  | 4 | 4
45 | 2 | LED101-112 | LED | LS T776-P2S1-1-Z |  | 向きバラバラなので注意 | 12 | 12
46 | 2 | R101-104 | 抵抗 100 |  | 1005 | 予備1 | 5 | 0
47
48 |  |  | 基板 | REMOTE_CONTROL |  | t1.0 | 1
49 |  | SW101-112 | タクトスイッチ | ? |  | 浮かないように | 15 | 0
50 |  | CN101 | ピンヘッダー | 28ピンにしたPH2-2X40SBG |  |  | 1 | 1
51 | 2 | LED101-104 | LED | LS T776-P2S1-1-Z |  | 向きバラバラなので注意 | 4 | 4
52 | 2 | R101-104 | 抵抗 100 | 100 | 1005 | 予備1 | 5 | 0
53
54 |  |  | 基板 | Battery_Stay |  | t1.0 | 2
55 |  | PWR_SW | スライドスイッチ | MSK12C01 |  | 実装せず、短絡する(電源スイッチはメイン基板に移設) | 0 | 2
56 |  |  | 丸ピンＩＣソケット １ピン ＳＭＤ | RI-01S-SG/4.2SMT |  | *CN4,CN5に実装する「ピンヘッダーのピン」と接続 | 2 | 0
57 |  |  | タミヤ 透明ソフトプラ棒 | ITEM70158-400 |  | SW1の押し棒、LED1の導光に使う | 1 | 1
58 |  | CN201(シルクはCN1) | コネクタ | ‎0530480210‎ |  | バッテリー接続用 | 1 | 2
59 |  |  | スペーサ M3x2 通し穴 | CB-302-5E |  | Main_BoardとBattery_Stay(上)間 | 4 | 8
60 |  |  | スペーサ M3x6.5 通し穴 | CB-306.5-5E |  | Main_BoardとMicro_QWERTY/REMOTE_CONTROL間 | 4 | 8
61 |  |  | スペーサ M3x6.5 メス-メス | ASB-306.5-5E |  | Battery_Stay(上)とBattery_Stay(下)間 | 4 | 8
62 |  |  | ネジ レニーM3x4 | RY-0304 |  |  | 4 | 8
63 |  |  | ネジ レニーM3x15 | RY-0315 |  | 裏からのネジとぶつかる場合、削ってM3x14.5にする microQWERTY固定に金属ねじを使用しないこと | 4 | 8
64 |  |  | PHコネクタコンタクト | SPH-002T-P0.5L |  | 予備3 | 0 | 0
65 |  |  | PHコネクタハウジング | PHR-2 |  | 逆電圧無保護なので極性に注意 | 0 | 0
66
67 |  |  | キーホルダー化基板 | - |  | t1.0、2枚重ねてMain_BoardとBattery_Stay(上)間に(スペーサーの代わりに)取り付ける | 2
68 |  |  | 両面テープ |  |  | LiPo固定用 | 1 | 2
69 |  |  | LiPoバッテリー(1セル) |  |  |  | 1 | 2
 |  |  | 送料・手数料 |  |  |  | 1
 |  |  | 部品購入送料 秋月 |  |  |  | 0.125
 |  |  | 部品購入送料 C1S |  |  |  | 0.125
 |  |  | 部品購入送料 Digikey |  |  |  | 0.125
 |  |  | 部品購入送料 アイテンドー |  |  |  | 0.125
 |  |  | 部品購入送料 ヒロスギ |  |  |  | 0.125
 |  |  | 部品購入送料 Fusion PCB1 |  |  |  | 0.125
 |  |  | 部品購入送料 Fusion PCB2 |  |  |  | 0.125

Sheet: キー配列
v1 | 0 | 1 | 2 | 3 | 4 | 5 | 6 | 7 | 8 | 9 | 0 | 1
0 | 1 | 2 | 3 | 4 | 5 | 6 | 7 | 8 | 9 | 0 | - | =
1 | Q | W | E | R | T | Y | U | I | O | P | × | ⇐
2 | A | S | D | F | G | H | J | K | L | [ | ] | ↲
3 | ⇑ | Z | X | C | V | B | N | M | ; | ' | ↑ | ⇑
4 | ￣C | ￣W | ￣A | ￣F | □ | ￣T | , | . | ￣F | ← | ↓ | →
5 |  |  | ￣E | ￣L | / | \ | ` | Ⅰ | Ⅱ | Ⅲ
v2 US1 | 0 | 1 | 2 | 3 | 4 | 5 | 6 | 7 | 8 | 9 | 0 | 1
0 | 1 | 2 | 3 | 4 | 5 | 6 | 7 | 8 | 9 | 0 | - | =
1 | Q | W | E | R | T | Y | U | I | O | P | × | ⇐
2 | A | S | D | F | G | H | J | K | L | ; | ' | ↲
3 | ⇑ | Z | X | C | V | B | N | M | , | . | ↑ | ⇑
4 | ￣C | ￣W | ￣A | ￣F | ` | [ | ] | ￣L | ￣F | ← | ↓ | →
5 |  |  | □ | ￣T | ￣E | / | \ | Ⅰ | Ⅱ | Ⅲ
v2 US2 | 0 | 1 | 2 | 3 | 4 | 5 | 6 | 7 | 8 | 9 | 0 | 1
0 | 1 | 2 | 3 | 4 | 5 | 6 | 7 | 8 | 9 | 0 | - | =
1 | ￣T | Q | W | E | R | T | Y | U | I | O | P | ⇐
2 | ￣E | A | S | D | F | G | H | J | K | L | × | ↲
3 | ⇑ | Z | X | C | V | B | N | M | , | . | ↑ | ⇑
4 | ￣C | ￣W | ￣A | ￣F | ` | [ | ] | ￣L | ￣F | ← | ↓ | →
5 |  |  | □ | ; | ' | / | \ | Ⅰ | Ⅱ | Ⅲ
v2 JIS | 0 | 1 | 2 | 3 | 4 | 5 | 6 | 7 | 8 | 9 | 0 | 1
基板シルク
0 | 1 | 2 | 3 | 4 | 5 | 6 | 7 | 8 | 9 | 0 | - | ^
1 | Q | W | E | R | T | Y | U | I | O | P | × | ⇐
2 | A | S | D | F | G | H | J | K | L | ; | : | ↲
3 | ⇑ | Z | X | C | V | B | N | M | , | . | ↑ | ⇑
4 | ￣C | ￣W | ￣A | ￣F | @ | [ | ] | ￥ | ￣F | ← | ↓ | →
5 | 赤フィルはLEDあり |  | □ | ￣T | ￣E | / | \ | Ⅰ | Ⅱ | Ⅲ | 👈モード切替・表示
v2 JIS | 0 | 1 | 2 | 3 | 4 | 5 | 6 | 7 | 8 | 9 | 0 | 1
機能
0 | 1 | 2 | 3 | 4 | 5 | 6 | 7 | 8 | 9 | 0 | - | ^
1 | Q | W | E | R | T | Y | U | I | O | P | del | bs
2 | A | S | D | F | G | H | J | K | L | ; | : | enter
3 | shift | Z | X | C | V | B | N | M | , | . | ↑ | shift
4 | ctrl | win | alt | fn | @ | [ | ] | ￥ | fn | ← | ↓ | →
5 |  |  | space | tab | esc | / | \ | 全/半 | 無変換 | 変換
v2 JIS | 0 | 1 | 2 | 3 | 4 | 5 | 6 | 7 | 8 | 9 | 0 | 1
Fn機能
0 | F1 | F2 | F3 | F4 | F5 | F6 | F7 | F8 | F9 | F10 | F11 | F12
1
2
3 |  |  |  |  |  |  |  |  |  |  | P_UP
4 |  |  |  |  |  |  |  |  |  | HOME | P_DN | END
5 |  |  | capslock |  |  |  |  | モード1 | モード2 | モード3

Sheet: 動作確認等
電源周辺の確認
①電源を接続する前に、C2,C8,C10,C12の端子間が短絡していないこと
②USBを接続し、各コンデンサの電圧が下記電圧範囲内であること
・C2:4.0~4.2V(電池非接続時)
・C6:3.2~3.4V
・C8:3.0~3.2V
・C10:4.7~5.2V
・C12:4.1~4.2V(電池非接続時)
IC2(FT230X)の初期設定
①FTDIからFT_Progをダウンロード・インストールし、起動
②Scan and Parseでデバイスを認識させる(ポートをオープンしていない状態で)
③デバイスを右クリックし、Apply TemplateでBTKBフォルダのFT230X_Config_V1.01.xmlを指定
④Program DevicesでProgramを押してFinished Programが出れば成功
⑤FT_Progを終了する
ブートローダー書き込みオプション利用してない方は、下記ファイルを書き込んでください
‪BTKB\Software\BTKB_Bootloader.X.production.hex
PICが動作しているかの確認(ブートローダー書き込み済みの場合)
①ターミナルソフトで接続する(ボーレート:115200bps、フロー制御:ハードウェア(RTS/CTS)、データ:8ビット、ストップビット:1ビット、パリティ:なし)
②SW1をしばらく押すとLED1が点灯し、「Hello!(改行)send .hex file」が表示される
③文字を打つたびにLEDの状態が変わる
④qを打つとリセットが掛かり、SW1とSW2_4が同じ状態の場合、再びブートローダーが起動する
ブートローダー(ソフト書き換え)の仕様
・ターミナルソフト設定(ボーレート:115200bps、フロー制御:ハードウェア(RTS/CTS)、データ:8ビット、ストップビット:1ビット、パリティ:なし)
・起動時にSW1とSW2_4が同じ状態の場合(条件判定)、ブートローダーを起動する
・条件を満たさない場合、書き込まれたソフトを起動するが、書き込まれていない場合、条件判定を繰り返す
・ブートローダーが起動すると、LED1が点灯し、ターミナルソフトに「Hello!(改行)send .hex file」が表示される
・データを受信すると、1バイトごとにLED1の状態が切り替わる
・.hexファイルを送り、正常終了すると「SUCCESSFUL」が表示される
・.hexファイル受信時にエラーが起こるとエラーメッセージを表示する
・正常終了時、エラー時に「q」を送ると再起動し、条件判定する
裏のLEDの動作
遅い点滅 | 切断状態(ペアリング可能)
速い点滅 | コマンドモード
消灯 | 電源切れてる・接続状態
RN42の設定
・詳しい設定についてはBTKB\Datasheet\RN42\bluetooth_cr_UG-v1.0r.pdfを参照
・とりあえずコマンドモードで下の各行を送り、AOKが出るか確認する
PICにKBのソフトが書き込まれている状態で、$キーを押すとコマンドモードに入る(1秒かかる)
SN,microQWERTY | ←接続時に表示される名前
SM,4 | ←接続方法指定
S~,6 | ←HIDモード
SH,0037 | ←HIDの設定(マウスKB複合デバイス)
SO,- | ←接続・切断発生時の通知を有効化
SW,8050 | ←省電力設定(マウス機能も使う場合、設定しないほうがいい)
SY,FFF4 | ←無線出力を弱くする
SI,0200 | ←接続待機 時のウィンドウ設定(接続しやすさと消費電流に影響)
SJ,0200 | ←接続待機 時のウィンドウ設定(接続しやすさと消費電流に影響)
ソフトデバッグのための文字(接続時の表示名に使用不可)
・「!」RN42をリセットする
・「@」RN42をリセット解除する
・「#」PICをリセットする(主にブートローダーに入るときに使用)
・「$」切断し、RN42のコマンドモードに入る （コマンドモードに関してはRN42のデータシート参照）
・「%」接続/切断
BTKB.Xをビルドしてhexをブートローダーで書き込む
Known Issue
・USBでホストに接続中、ターミナルソフト等で通信できる状態にしないとフリーズする（充電器と接続は問題なし）
