IMD555/BTKB/PCB/v2/SwitchHolder.dxf

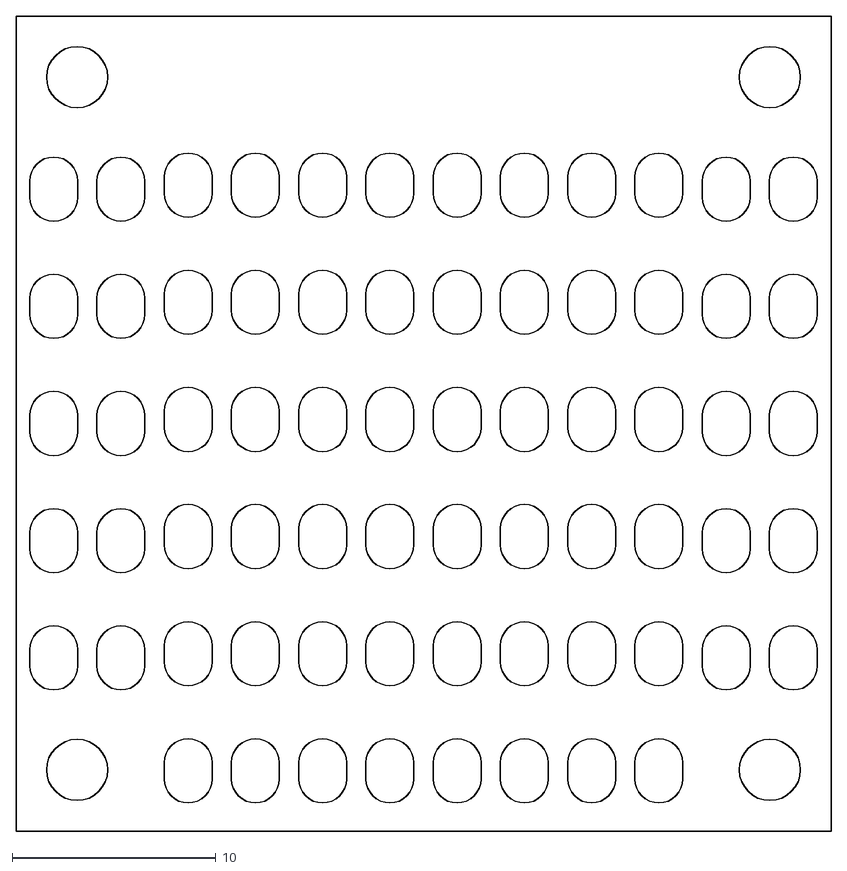
[picture p25: CAD file, 2021-03-14]
PCB/v2/SwitchHolder.dxf
40.0 x 40.0
