IMD555/BTKB/PCB/v2/Main_board/Main_Board.pdf

# VDD GND

# GND CHS⁻⁰⁴B

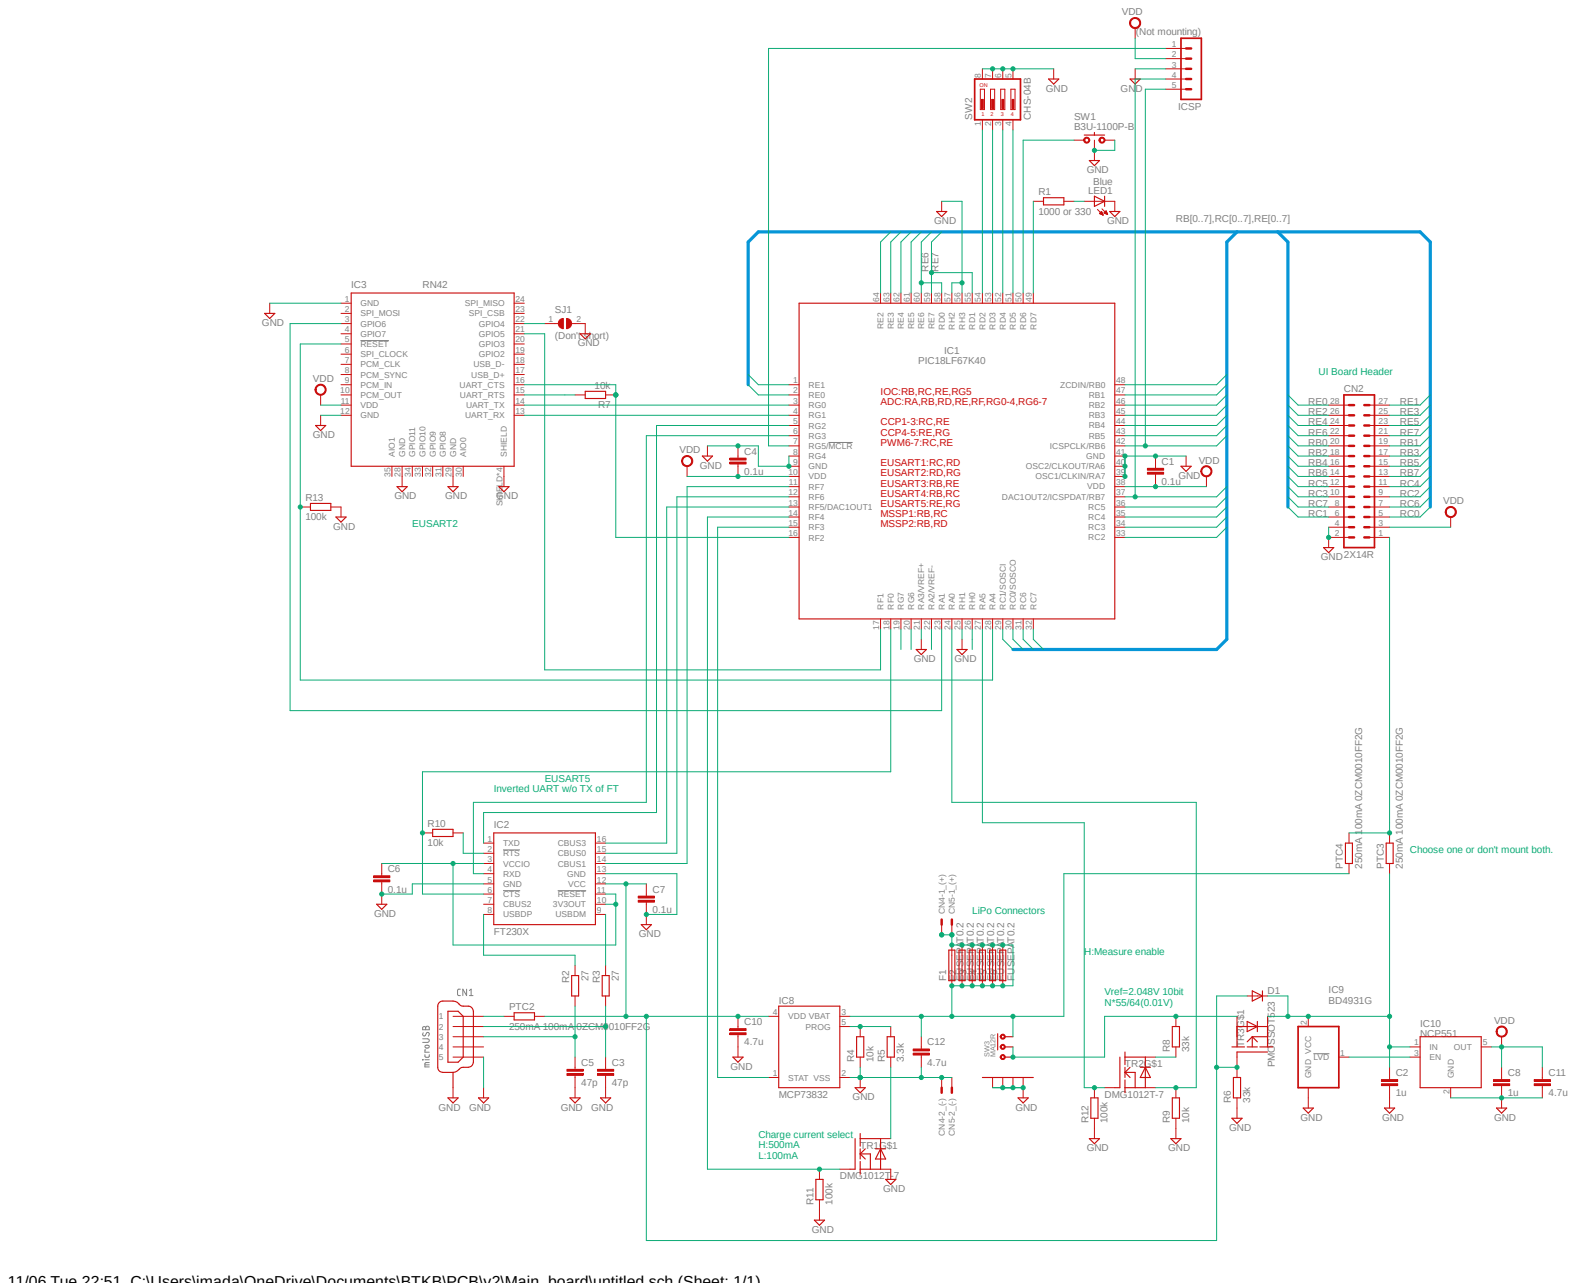
[picture p26: page 1]

IOC:RB,RC,RE,RG5
ADC:RA,RB,RD,RE,RF,RG0-4,RG6-7
CCP1-3:RC,RE
CCP4-5:RE,RG
PWM6-7:RC,RE
EUSART1:RC,RD
EUSART2:RD,RG
EUSART3:RB,RE
EUSART4:RB,RC
EUSART5:RE,RG
MSSP1:RB,RC
MSSP2:RB,RD

Inverted UART w/o TX of FT

Choose one or don't mount both.

H:Measure enable Vref=2.048V 10bit N*55/64(0.01V)

GND

11/06 Tue 22:51 C:\Users\imada\OneDrive\Documents\BTKB\PCB\v2\Main_board\untitled.sch (Sheet: 1/1)
