IMD555/BTKB/PCB/v1/Micro_QWERTY/untitled.brd

## EAGLE design PCB/v1/Micro_QWERTY/untitled.brd (2021-03-14, an earlier design)

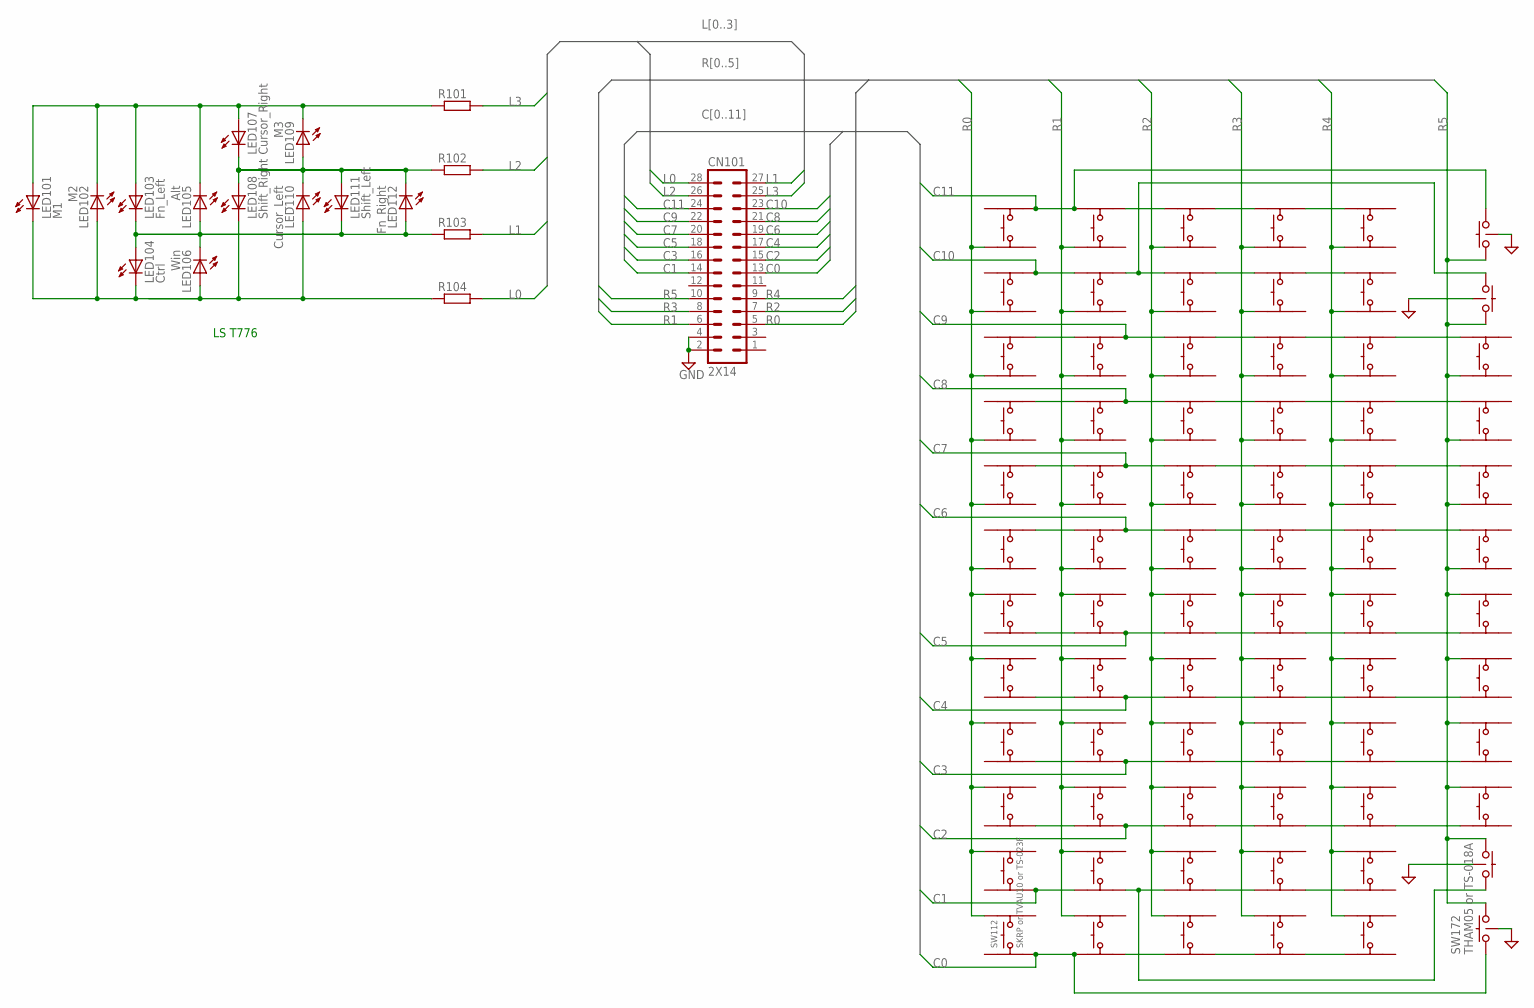
[picture p30: schematic untitled.sch]

Parts:
CN101: 2X14; 2MM_14X2
LED101: M1; P-LCC-2-TOPLED-RG
LED102: M2; P-LCC-2-TOPLED-RG
LED103: Fn_Left; P-LCC-2-TOPLED-RG
LED104: Ctrl; P-LCC-2-TOPLED-RG
LED105: Alt; P-LCC-2-TOPLED-RG
LED106: Win; P-LCC-2-TOPLED-RG
LED107: Cursor_Right; P-LCC-2-TOPLED-RG
LED108: Shift_Right; P-LCC-2-TOPLED-RG
LED109: M3; P-LCC-2-TOPLED-RG
LED110: Cursor_Left; P-LCC-2-TOPLED-RG
LED111: Shift_Left; P-LCC-2-TOPLED-RG
LED112: Fn_Right; P-LCC-2-TOPLED-RG
R101, R102, R103, R104: R-EU_R0402-SS; R0402-SS
SW101, SW102, SW103, SW104, SW105, SW106, SW107, SW108, SW109, SW110, SW111, SW113, SW114, SW115, SW116, SW117, SW118, SW119, SW120, SW121, SW122, SW123, SW124, SW125, SW126, SW127, SW128, SW129, SW130, SW131, SW132, SW133, SW134, SW135, SW136, SW137, SW138, SW139, SW140, SW141, SW142, SW143, SW144, SW145, SW146, SW147, SW148, SW149, SW150, SW151, SW152, SW153, SW154, SW155, SW156, SW157, SW158, SW159, SW160, SW163, SW164, SW165, SW166, SW167, SW168, SW169, SW170: SW_4PTVAU10-025; TVAU10-025
SW112: SKRP or TVAU10 or TS-023F; TVAU10-025
SW161, SW162, SW171: SW_WITH_EARTHX; THAM05
SW172: THAM05 or TS-018A; THAM05

Connections:
C0: CN101.13, SW112.P$2 (=A), SW124.P$1 (A), SW172.P$1
C1: CN101.14, SW111.P$2 (=A), SW123.P$1 (A)
C2: CN101.15, SW122.P$2 (=A), SW134.P$1 (A)
C3: CN101.16, SW121.P$2 (=A), SW133.P$1 (A)
C4: CN101.17, SW120.P$2 (=A), SW132.P$1 (A)
C5: CN101.18, SW119.P$2 (=A), SW131.P$1 (A)
C6: CN101.19, SW118.P$4 (=B), SW130.P$3 (B)
C7: CN101.20, SW117.P$4 (=B), SW129.P$3 (B)
C8: CN101.21, SW116.P$4 (=B), SW128.P$3 (B)
C9: CN101.22, SW115.P$4 (=B), SW127.P$3 (B)
C10: CN101.23, SW102.P$4 (=B), SW114.P$3 (B)
C11: CN101.24, SW101.P$4 (=B), SW113.P$3 (B), SW161.P$2
GND: CN101.2, CN101.4, SW161.S1, SW161.S2, SW161.S3, SW161.S4, SW161.S5, SW162.S1, SW162.S2, SW162.S3, SW162.S4, SW162.S5, SW171.S1, SW171.S2, SW171.S3, SW171.S4, SW171.S5, SW172.S1, SW172.S2, SW172.S3, SW172.S4, SW172.S5
L0: CN101.28, R104.2
L1: CN101.27, R103.2
L2: CN101.26, R102.2
L3: CN101.25, R101.2
unnamed: LED107.C, LED108.A, LED109.A, LED110.C, LED111.A, LED112.C, R102.1
unnamed: LED101.A, LED102.C, LED103.A, LED105.C, LED107.A, LED109.C, R101.1
unnamed: LED103.C, LED104.A, LED105.A, LED106.C, LED111.C, LED112.A, R103.1
unnamed: LED101.C, LED102.A, LED104.C, LED106.A, LED108.C, LED110.A, R104.1
unnamed: SW123.P$2 (=A), SW135.P$1 (A), SW171.P$2
unnamed: SW113.P$4 (=B), SW125.P$3 (B)
unnamed: SW114.P$4 (=B), SW126.P$3 (B), SW162.P$1
unnamed: SW106.P$4 (=B), SW118.P$3 (B)
unnamed: SW130.P$4 (=B), SW142.P$3 (B)
unnamed: SW154.P$4 (=B), SW166.P$3 (B)
unnamed: SW142.P$4 (=B), SW154.P$3 (B)
unnamed: SW105.P$4 (=B), SW117.P$3 (B)
unnamed: SW129.P$4 (=B), SW141.P$3 (B)
unnamed: SW153.P$4 (=B), SW165.P$3 (B)
unnamed: SW141.P$4 (=B), SW153.P$3 (B)
unnamed: SW104.P$4 (=B), SW116.P$3 (B)
unnamed: SW128.P$4 (=B), SW140.P$3 (B)
unnamed: SW152.P$4 (=B), SW164.P$3 (B)
unnamed: SW140.P$4 (=B), SW152.P$3 (B)
unnamed: SW103.P$4 (=B), SW115.P$3 (B)
unnamed: SW127.P$4 (=B), SW139.P$3 (B)
unnamed: SW151.P$4 (=B), SW163.P$3 (B)
unnamed: SW139.P$4 (=B), SW151.P$3 (B)
unnamed: SW126.P$4 (=B), SW138.P$3 (B)
unnamed: SW138.P$4 (=B), SW150.P$3 (B)
unnamed: SW125.P$4 (=B), SW137.P$3 (B)
unnamed: SW137.P$4 (=B), SW149.P$3 (B)
unnamed: SW107.P$2 (=A), SW119.P$1 (A)
unnamed: SW131.P$2 (=A), SW143.P$1 (A)
unnamed: SW155.P$2 (=A), SW167.P$1 (A)
unnamed: SW143.P$2 (=A), SW155.P$1 (A)
unnamed: SW108.P$2 (=A), SW120.P$1 (A)
unnamed: SW132.P$2 (=A), SW144.P$1 (A)
unnamed: SW156.P$2 (=A), SW168.P$1 (A)
unnamed: SW144.P$2 (=A), SW156.P$1 (A)
unnamed: SW109.P$2 (=A), SW121.P$1 (A)
unnamed: SW133.P$2 (=A), SW145.P$1 (A)
unnamed: SW157.P$2 (=A), SW169.P$1 (A)
unnamed: SW145.P$2 (=A), SW157.P$1 (A)
unnamed: SW110.P$2 (=A), SW122.P$1 (A)
unnamed: SW134.P$2 (=A), SW146.P$1 (A)
unnamed: SW158.P$2 (=A), SW170.P$1 (A)
unnamed: SW146.P$2 (=A), SW158.P$1 (A)
unnamed: SW135.P$2 (=A), SW147.P$1 (A)
unnamed: SW147.P$2 (=A), SW159.P$1 (A)
unnamed: SW124.P$2 (=A), SW136.P$1 (A)
unnamed: SW136.P$2 (=A), SW148.P$1 (A)
unnamed: SW148.P$2 (=A), SW160.P$1 (A)
R0: CN101.5, SW101.P$1 (A), SW102.P$1 (A), SW103.P$1 (A), SW104.P$1 (A), SW105.P$1 (A), SW106.P$1 (A), SW107.P$3 (B), SW108.P$3 (B), SW109.P$3 (B), SW110.P$3 (B), SW111.P$3 (B), SW112.P$3 (B)
R1: CN101.6, SW113.P$1 (A), SW114.P$1 (A), SW115.P$1 (A), SW116.P$1 (A), SW117.P$1 (A), SW118.P$1 (A), SW119.P$3 (B), SW120.P$3 (B), SW121.P$3 (B), SW122.P$3 (B), SW123.P$3 (B), SW124.P$3 (B)
R2: CN101.7, SW125.P$1 (A), SW126.P$1 (A), SW127.P$1 (A), SW128.P$1 (A), SW129.P$1 (A), SW130.P$1 (A), SW131.P$3 (B), SW132.P$3 (B), SW133.P$3 (B), SW134.P$3 (B), SW135.P$3 (B), SW136.P$3 (B)
R3: CN101.8, SW137.P$1 (A), SW138.P$1 (A), SW139.P$1 (A), SW140.P$1 (A), SW141.P$1 (A), SW142.P$1 (A), SW143.P$3 (B), SW144.P$3 (B), SW145.P$3 (B), SW146.P$3 (B), SW147.P$3 (B), SW148.P$3 (B)
R4: CN101.9, SW149.P$1 (A), SW150.P$1 (A), SW151.P$1 (A), SW152.P$1 (A), SW153.P$1 (A), SW154.P$1 (A), SW155.P$3 (B), SW156.P$3 (B), SW157.P$3 (B), SW158.P$3 (B), SW159.P$3 (B), SW160.P$3 (B)
R5: CN101.10, SW161.P$1, SW162.P$2, SW163.P$1 (A), SW164.P$1 (A), SW165.P$1 (A), SW166.P$1 (A), SW167.P$3 (B), SW168.P$3 (B), SW169.P$3 (B), SW170.P$3 (B), SW171.P$1, SW172.P$2

Notes on the sheet:
LS T776

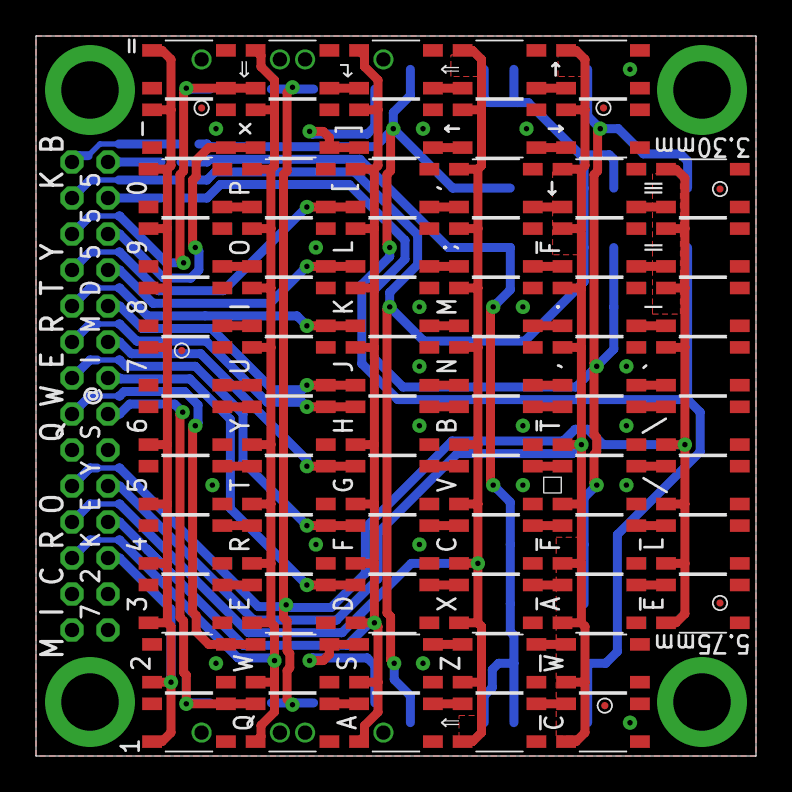
[picture p31: board PCB/v1/Micro_QWERTY/untitled.brd from above]

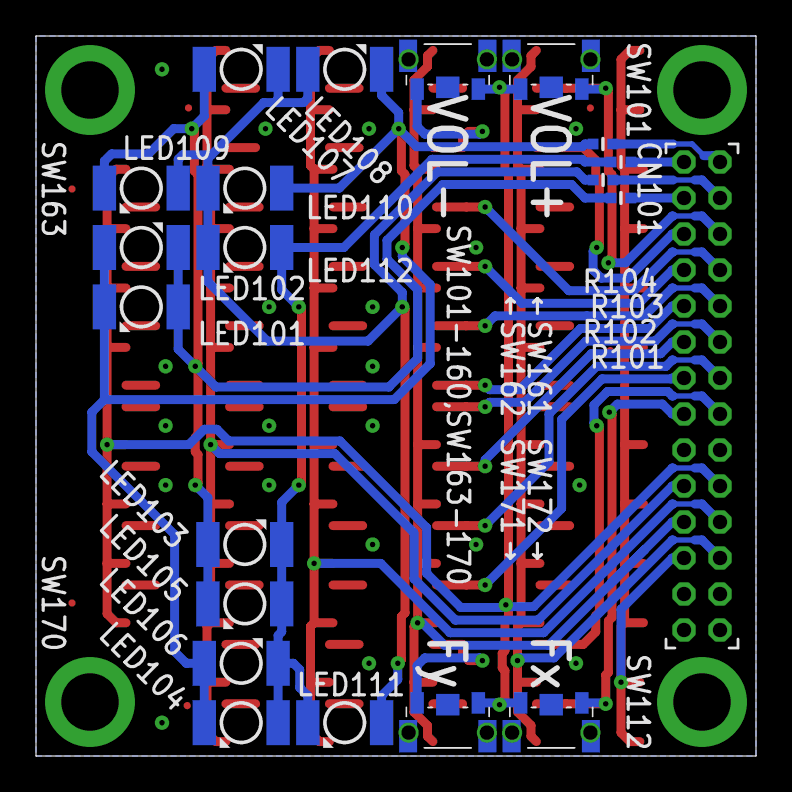
[picture p32: board PCB/v1/Micro_QWERTY/untitled.brd from below]

Board: 2 copper layers, 40.0 x 40.0 mm, 97 parts (22 on the bottom side), 71 nets.

Other parts of the board:
U$1, U$4, U$5, U$6, U$7, U$8: PCB_CHECK
U$2, U$3: RULER-S
