IMD555/BTKB/PCB/v2/Main_board/untitled.brd

## EAGLE design PCB/v2/Main_board/untitled.brd (2021-03-14)

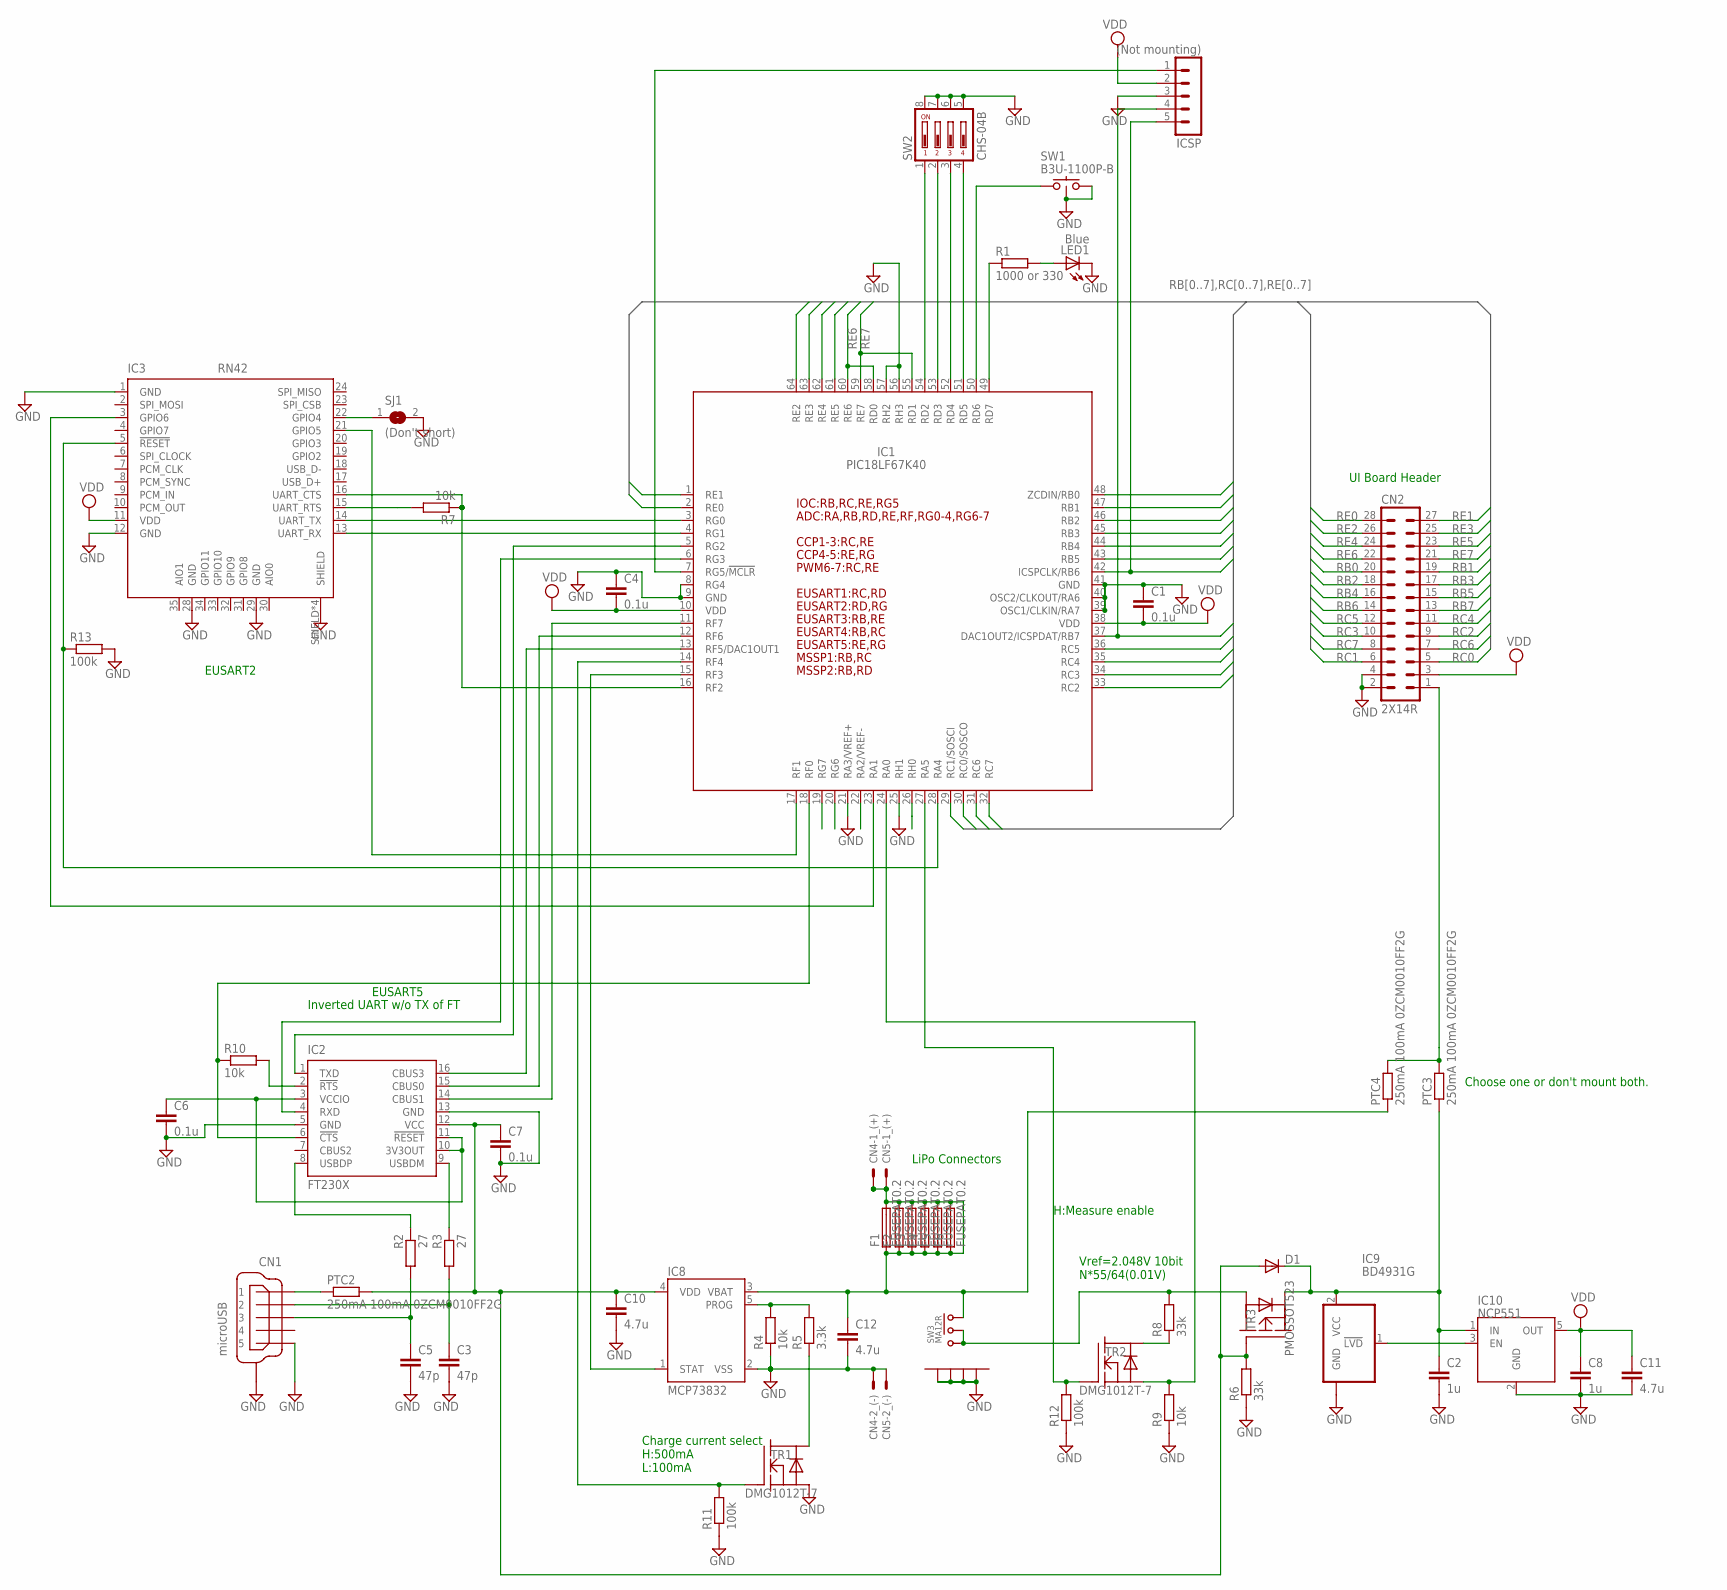
[picture p33: schematic untitled.sch]

Parts:
C1, C4, C6, C7: 0.1u; C0402-SS
C2, C8: 1u; C0805
C3, C5: 47p; C0402-SS
C10, C11, C12: 4.7u; C0805
CN1: microUSB; 10118194-0001LF
CN2: 2X14R; 2MM_14X2_R
CN4, CN5: 2P_(POWER)PH_S; PH-2_S
D1: DIODE-VMN2; VMN2
F1, F2, F3, F4, F5, F6: FUSEPAT0.2; FUSE_PAT1
IC1: PIC18LF67K40; TQFP64-10X10
IC2: FT230X; SSOP16
IC3: RN42; RN-42
IC8: MCP73832; SOT23-5L
IC9: BD4931G; SOT23-5L
IC10: NCP551; SOT23-5L
ICSP: (Not mounting); MA05-1
LED1: Blue; CHIP-LED1005
PTC2, PTC3, PTC4: 250mA 100mA 0ZCM0010FF2G; R0603
R1: 1000 or 330; R0402-SS
R2, R3: 27; R0402-SS
R4, R7, R9, R10: 10k; R0402-SS
R5: 3.3k; R0402-SS
R6, R8: 33k; R0402-SS
R11, R12, R13: 100k; R0402-SS
SJ1: (Don't short); SJ
SW1: B3U-1100P-B
SW2: CHS-04B
SW3: MA12R
TR1, TR2: DMG1012T-7; SOT523
TR3: PMOSSOT523; SOT523

Connections:
GND: C1.1, C2.2, C3.2, C4.1, C5.2, C6.2, C7.2, C8.2, C10.2, C11.2, C12.2, CN1.P$5 (5), CN1.P$6 (S), CN1.P$7 (S), CN1.S1 (S), CN1.S2 (S), CN1.S3 (S), CN1.S4 (S), CN1.S5 (S), CN1.S6 (S), CN1.S7 (S), CN1.S8 (S), CN1.S9 (S), CN1.S10 (S), CN2.2, CN2.4, CN4.2, CN5.2, IC1.8 (RG4), IC1.9 (GND), IC1.21 (RA3/VREF+), IC1.25 (RH1), IC1.39 (OSC1/CLKIN/RA7), IC1.40 (OSC2/CLKOUT/RA6), IC1.41 (GND), IC1.56 (RH3), IC1.57 (RH2), IC2.5 (GND), IC2.13 (GND), IC3.1 (GND), IC3.12 (GND), IC3.28 (GND), IC3.29 (GND), IC3.SHIELD, IC3.SHIELD@1 (SHIELD), IC3.SHIELD@2 (SHIELD), IC3.SHIELD@3 (SHIELD), IC8.2 (VSS), IC9.3 (GND), IC10.2 (GND), ICSP.3, LED1.C, R4.1, R6.1, R9.1, R11.1, R12.1, R13.2, SJ1.2, SW1.P$2, SW1.P$3, SW2.5, SW2.6, SW2.7, SW2.8, SW3.P$4, SW3.P$5, SW3.P$6, SW3.P$7, TR1.2 (S)
unnamed: IC1.4 (RG1), IC3.13 (UART_RX)
unnamed: IC1.5 (RG2), IC2.1 (TXD)
unnamed: IC1.3 (RG0), IC3.14 (UART_TX)
unnamed: C5.1, CN1.P$3 (3), R2.2
unnamed: C3.1, CN1.P$2 (2), R3.2
unnamed: IC1.6 (RG3), IC2.4 (RXD)
unnamed: CN2.1, PTC3.2, PTC4.2
unnamed: C7.1, C10.1, D1.A, IC2.12 (VCC), IC8.4 (VDD), PTC2.2, R6.2, TR3.1 (G)
unnamed: IC1.15 (RF3), IC8.1 (STAT)
unnamed: C12.1, CN4.1, CN5.1, F1.P$1 (1), F1.P$2 (2), F2.P$1 (1), F2.P$2 (2), F3.P$1 (1), F3.P$2 (2), F4.P$1 (1), F4.P$2 (2), F5.P$1 (1), F5.P$2 (2), F6.P$1 (1), F6.P$2 (2), IC8.3 (VBAT), PTC4.1, SW3.P$1 (1)
unnamed: R8.2, SW3.P$2 (2), SW3.P$3 (3), TR3.3 (D)
unnamed: IC1.7 (RG5/!MCLR), ICSP.1
unnamed: CN1.P$1 (1), PTC2.1
unnamed: IC1.54 (RD2), SW2.1
unnamed: IC1.52 (RD4), SW2.3
unnamed: IC1.51 (RD5), SW2.4
unnamed: IC1.49 (RD7), R1.1
unnamed: IC1.28 (RA4), IC3.5 (!RESET), R13.1
unnamed: LED1.A, R1.2
unnamed: C6.1, IC2.3 (VCCIO), IC2.10 (3V3OUT), IC2.11 (!RESET)
unnamed: IC1.50 (RD6), SW1.P$1
unnamed: IC2.9 (USBDM), R3.1
unnamed: IC1.53 (RD3), SW2.2
unnamed: IC2.8 (USBDP), R2.1
unnamed: IC1.12 (RF6), IC2.15 (CBUS0)
unnamed: IC1.13 (RF5/DAC1OUT1), IC2.16 (CBUS3)
unnamed: IC8.5 (PROG), R4.2, R5.2
unnamed: IC1.27 (RA5), R12.2, TR2.1 (G)
unnamed: IC1.16 (RF2), IC3.16 (UART_CTS), R7.1
unnamed: IC1.14 (RF4), R11.2, TR1.1 (G)
unnamed: IC3.15 (UART_RTS), R7.2
unnamed: IC1.11 (RF7), IC2.14 (CBUS1)
unnamed: IC2.2 (!RTS), R10.2
unnamed: IC1.18 (RF0), IC2.6 (!CTS), R10.1
unnamed: IC1.17 (RF1), IC3.21 (GPIO5)
unnamed: IC3.22 (GPIO4), SJ1.1
unnamed: IC9.1 (!LVD!), IC10.3 (EN)
unnamed: R5.1, TR1.3 (D)
unnamed: R8.1, TR2.3 (D)
unnamed: IC1.24 (RA0), R9.2, TR2.2 (S)
unnamed: IC1.23 (RA1), IC3.3 (GPIO6)
RB0: CN2.20, IC1.48 (ZCDIN/RB0)
RB1: CN2.19, IC1.47 (RB1)
RB2: CN2.18, IC1.46 (RB2)
RB3: CN2.17, IC1.45 (RB3)
RB4: CN2.16, IC1.44 (RB4)
RB5: CN2.15, IC1.43 (RB5)
RB6: CN2.14, IC1.42 (ICSPCLK/RB6), ICSP.5
RB7: CN2.13, IC1.37 (DAC1OUT2/ICSPDAT/RB7), ICSP.4
RC0: CN2.5, IC1.30 (RC0/SOSCO)
RC1: CN2.6, IC1.29 (RC1/SOSCI)
RC2: CN2.9, IC1.33 (RC2)
RC3: CN2.10, IC1.34 (RC3)
RC4: CN2.11, IC1.35 (RC4)
RC5: CN2.12, IC1.36 (RC5)
RC6: CN2.7, IC1.31 (RC6)
RC7: CN2.8, IC1.32 (RC7)
RE0: CN2.28, IC1.2 (RE0)
RE1: CN2.27, IC1.1 (RE1)
RE2: CN2.26, IC1.64 (RE2)
RE3: CN2.25, IC1.63 (RE3)
RE4: CN2.24, IC1.62 (RE4)
RE5: CN2.23, IC1.61 (RE5)
RE6: CN2.22, IC1.58 (RD0), IC1.60 (RE6)
RE7: CN2.21, IC1.55 (RD1), IC1.59 (RE7)
VBAT: C2.1, D1.C, IC9.2 (VCC), IC10.1 (IN), PTC3.1, TR3.2 (S)
VDD: C1.2, C4.2, C8.1, C11.1, CN2.3, IC1.10 (VDD), IC1.38 (VDD), IC3.11 (VDD), IC10.5 (OUT), ICSP.2

Notes on the sheet:
Charge current select H:500mA L:100mA
H:Measure enable
LiPo Connectors
UI Board Header
Inverted UART w/o TX of FT
Vref=2.048V 10bit N*55/64(0.01V)
EUSART2
EUSART5
Choose one or don't mount both.

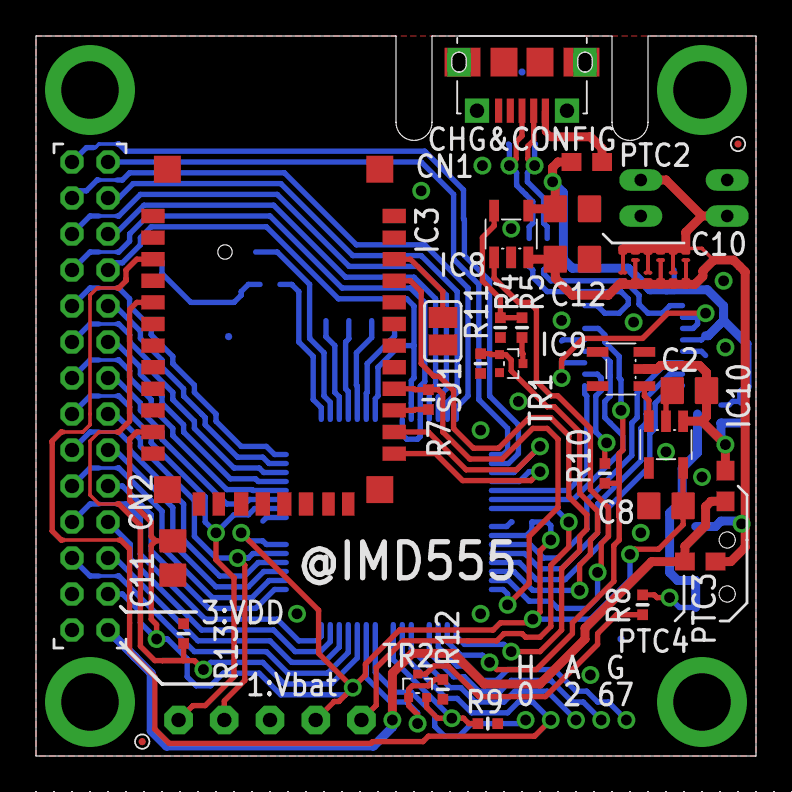
[picture p34: board PCB/v2/Main_board/untitled.brd from above]

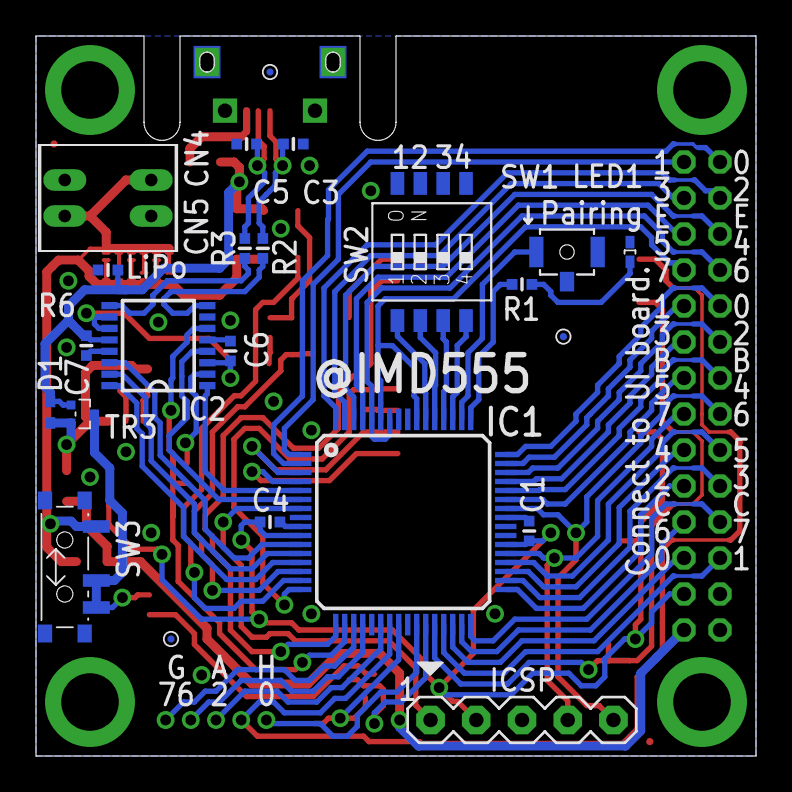
[picture p35: board PCB/v2/Main_board/untitled.brd from below]

Board: 2 copper layers, 40.0 x 40.0 mm, 60 parts (25 on the bottom side), 68 nets.

Other parts of the board:
U$1, U$3, U$6, U$8, U$9: PCB_CHECK
U$2: RULER
U$4: RULER-S
