IMD555/BTKB/PCB/v2/Battery_Stay/untitled.brd

## EAGLE design PCB/v2/Battery_Stay/untitled.brd (2021-03-14)

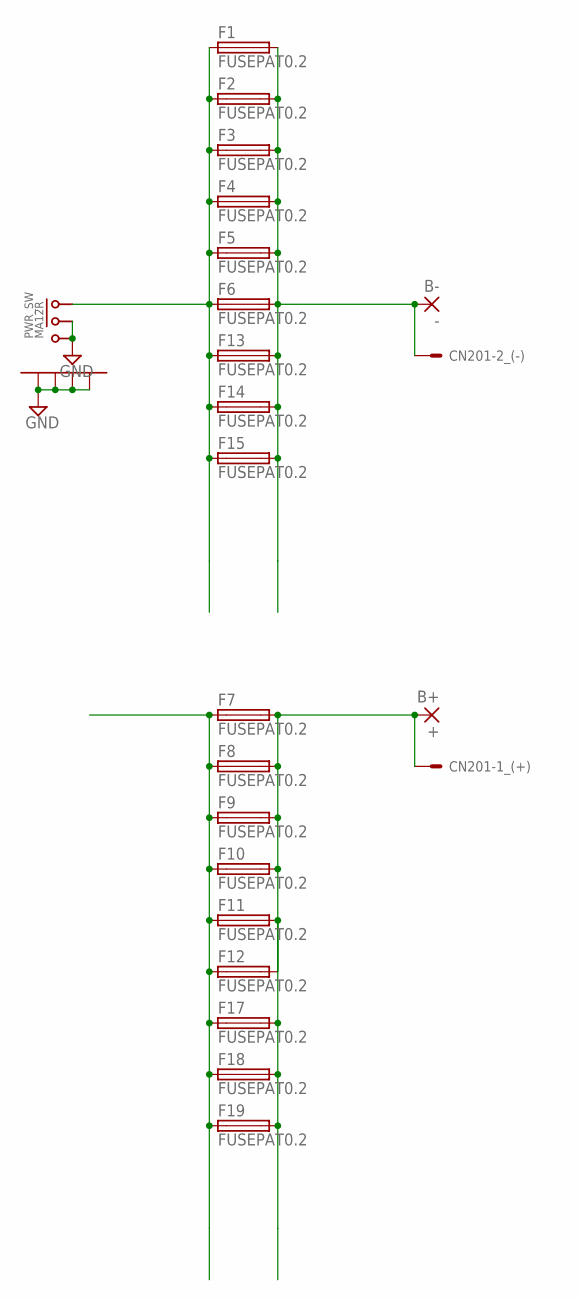
[picture p36: schematic untitled.sch]

Parts:
B+: +; SMD2,5-5
B-: -; SMD2,5-5
CN201: 2P_(POWER)53048; 53048-0210
F1, F2, F3, F4, F5, F6, F7, F8, F9, F10, F11, F12, F13, F14, F15, F17, F18, F19: FUSEPAT0.2; FUSE_PAT1
PWR_SW: MA12R

Connections:
GND: PWR_SW.P$2 (2), PWR_SW.P$3 (3), PWR_SW.P$4, PWR_SW.P$5, PWR_SW.P$6, PWR_SW.P$7
unnamed: F1.P$1 (1), F2.P$1 (1), F3.P$1 (1), F4.P$1 (1), F5.P$1 (1), F6.P$1 (1), F13.P$1 (1), F14.P$1 (1), F15.P$1 (1), PWR_SW.P$1 (1)
unnamed: B-.1, CN201.2, F1.P$2 (2), F2.P$2 (2), F3.P$2 (2), F4.P$2 (2), F5.P$2 (2), F6.P$2 (2), F13.P$2 (2), F14.P$2 (2), F15.P$2 (2)
unnamed: F7.P$1 (1), F8.P$1 (1), F9.P$1 (1), F10.P$1 (1), F11.P$1 (1), F12.P$1 (1), F17.P$1 (1), F18.P$1 (1), F19.P$1 (1)
unnamed: B+.1, CN201.1, F7.P$2 (2), F8.P$2 (2), F9.P$2 (2), F10.P$2 (2), F11.P$2 (2), F12.P$2 (2), F17.P$2 (2), F18.P$2 (2), F19.P$2 (2)

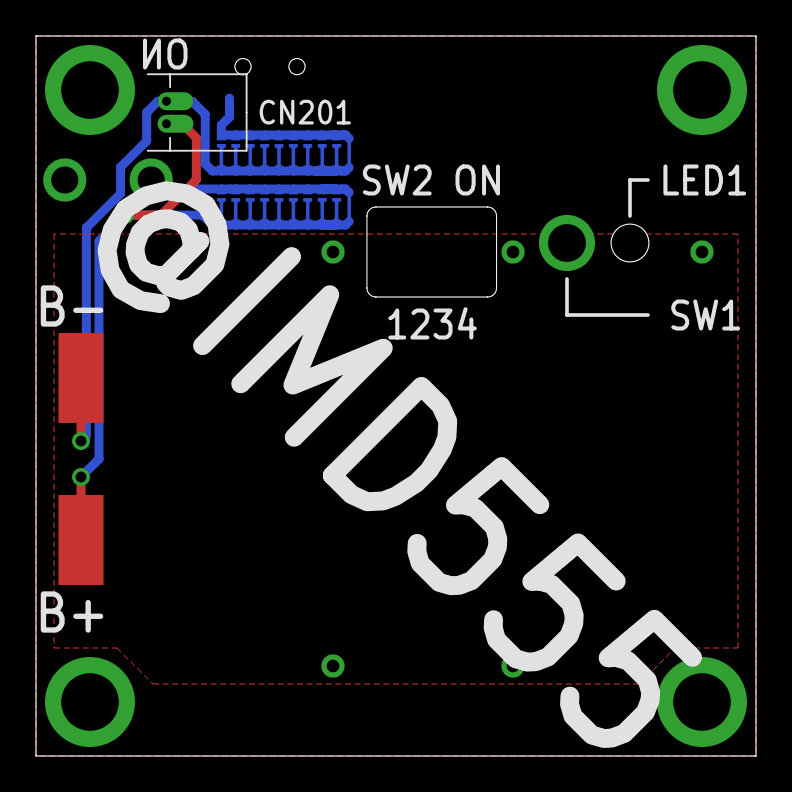
[picture p37: board PCB/v2/Battery_Stay/untitled.brd from above]

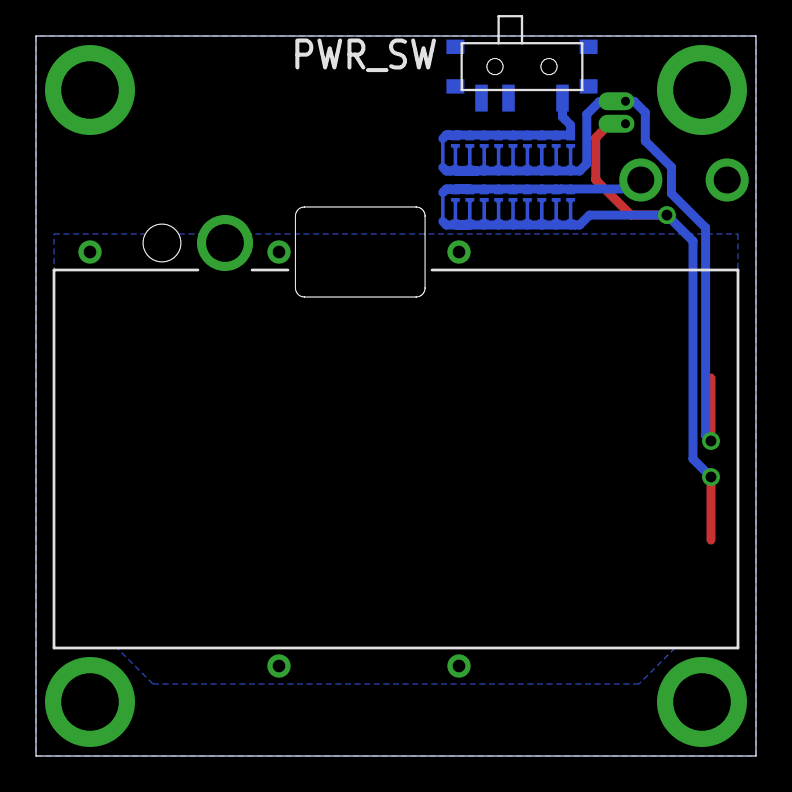
[picture p38: board PCB/v2/Battery_Stay/untitled.brd from below]

Board: 2 copper layers, 40.0 x 40.0 mm, 22 parts (19 on the bottom side), 5 nets.
