IMD555/BTKB/PCB/v1/REMOTE_CONTROL/untitled.brd

## EAGLE design PCB/v1/REMOTE_CONTROL/untitled.brd (2021-03-14, an earlier design)

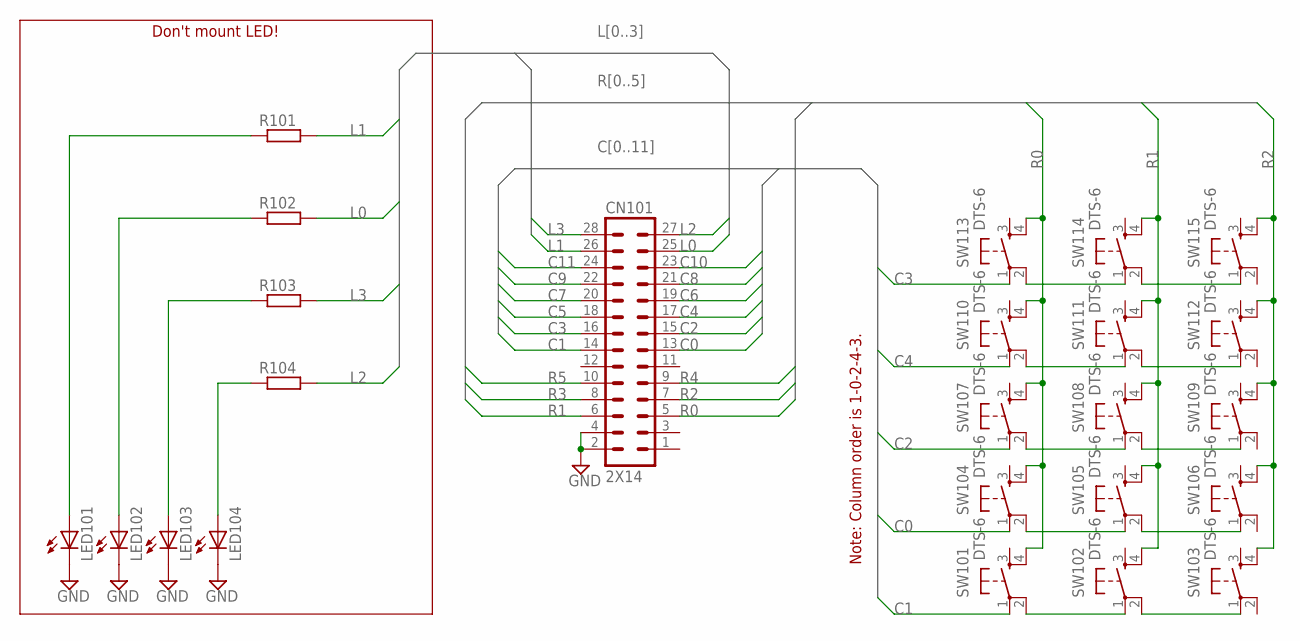
[picture p39: schematic untitled.sch]

Parts:
CN101: 2X14; 2MM_14X2
LED101, LED102, LED103, LED104: LEDP-LCC-2-BACK; P-LCC-2-TOPLED-RG
R101, R102, R103, R104: R-EU_R0402-SS; R0402-SS
SW101, SW102, SW103, SW104, SW105, SW106, SW107, SW108, SW109, SW110, SW111, SW112, SW113, SW114, SW115: DTS-6

Connections:
C0: CN101.13, SW104.1
C1: CN101.14, SW101.1
C2: CN101.15, SW107.1
C3: CN101.16, SW113.1
C4: CN101.17, SW110.1
C5: CN101.18
C6: CN101.19
C7: CN101.20
C8: CN101.21
C9: CN101.22
C10: CN101.23
C11: CN101.24
GND: CN101.2, CN101.4, LED101.C, LED102.C, LED103.C, LED104.C
L0: CN101.25, R102.2
L1: CN101.26, R101.2
L2: CN101.27, R104.2
L3: CN101.28, R103.2
unnamed: LED101.A, R101.1
unnamed: SW114.2, SW115.1
unnamed: LED102.A, R102.1
unnamed: SW111.2, SW112.1
unnamed: SW108.2, SW109.1
unnamed: LED103.A, R103.1
unnamed: SW102.2, SW103.1
unnamed: SW105.2, SW106.1
unnamed: LED104.A, R104.1
unnamed: SW110.2, SW111.1
unnamed: SW107.2, SW108.1
unnamed: SW104.2, SW105.1
unnamed: SW101.2, SW102.1
unnamed: SW113.2, SW114.1
R0: CN101.5, SW101.4, SW104.4, SW107.4, SW110.4, SW113.4
R1: CN101.6, SW102.4, SW105.4, SW108.4, SW111.4, SW114.4
R2: CN101.7, SW103.4, SW106.4, SW109.4, SW112.4, SW115.4
R3: CN101.8
R4: CN101.9
R5: CN101.10

Notes on the sheet:
Note: Column order is 1-0-2-4-3.
Don't mount LED!

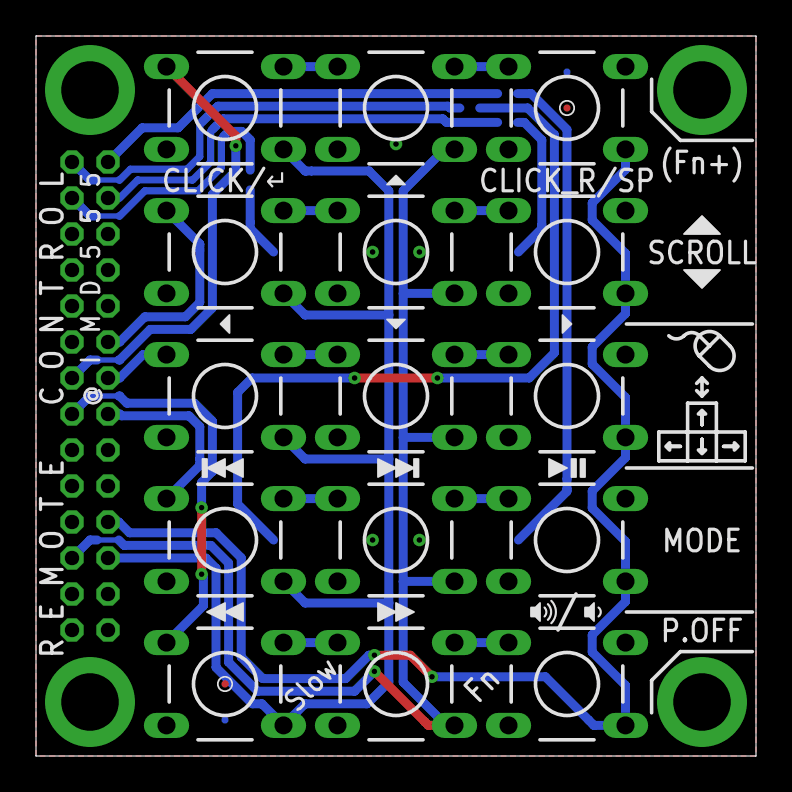
[picture p40: board PCB/v1/REMOTE_CONTROL/untitled.brd from above]

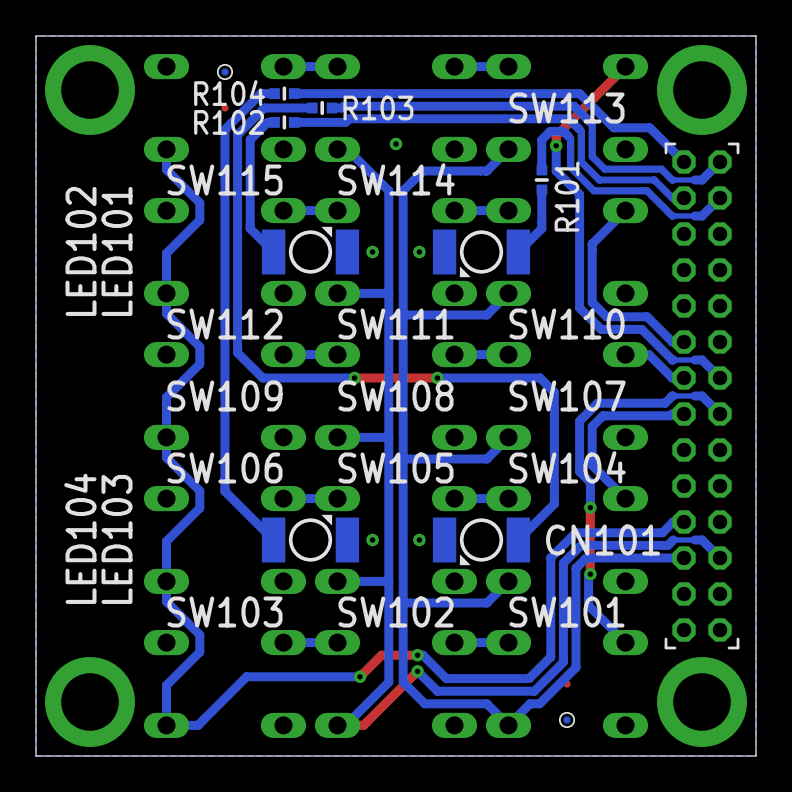
[picture p41: board PCB/v1/REMOTE_CONTROL/untitled.brd from below]

Board: 2 copper layers, 40.0 x 40.0 mm, 31 parts (12 on the bottom side), 27 nets.

Other parts of the board:
U$1, U$4, U$6, U$7: PCB_CHECK
U$2, U$3, U$5: RULER-S
