IMD555/BTKB/PCB/v2/Micro_QWERTY/Micro_QWERTY_Stencil.brd

## EAGLE design PCB/v2/Micro_QWERTY/Micro_QWERTY_Stencil.brd (2021-03-14)

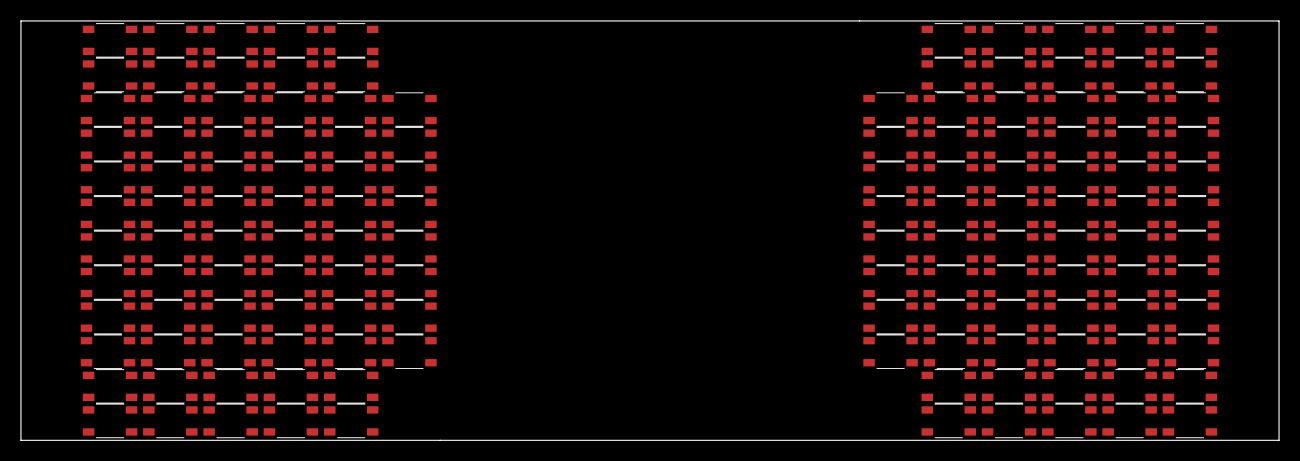
[picture p42: board Micro_QWERTY_Stencil.brd from above]

Board: 2 copper layers, 120.0 x 40.0 mm, 136 parts (0 on the bottom side), 40 nets, no tracks yet.

Parts:
SW1, SW112: SKRP(ALPS); TVAU10-025
SW2, SW3, SW4, SW5, SW6, SW7, SW8, SW9, SW10, SW11, SW12, SW13, SW14, SW15, SW16, SW17, SW18, SW19, SW20, SW21, SW22, SW23, SW24, SW25, SW26, SW27, SW28, SW29, SW30, SW31, SW32, SW33, SW34, SW35, SW36, SW37, SW38, SW39, SW40, SW41, SW42, SW43, SW44, SW45, SW46, SW47, SW48, SW49, SW50, SW51, SW52, SW53, SW54, SW55, SW56, SW57, SW58, SW59, SW60, SW61, SW62, SW63, SW64, SW65, SW66, SW67, SW68, SW101, SW102, SW103, SW104, SW105, SW106, SW107, SW108, SW109, SW110, SW111, SW113, SW114, SW115, SW116, SW117, SW118, SW119, SW120, SW121, SW122, SW123, SW124, SW125, SW126, SW127, SW128, SW129, SW130, SW131, SW132, SW133, SW134, SW135, SW136, SW137, SW138, SW139, SW140, SW141, SW142, SW143, SW144, SW145, SW146, SW147, SW148, SW149, SW150, SW151, SW152, SW153, SW154, SW155, SW156, SW157, SW158, SW159, SW160, SW163, SW164, SW165, SW166, SW167, SW168, SW169, SW170: SW_4PTVAU10-025; TVAU10-025

Connections:
C0: SW112.P$2, SW124.P$1
C1: SW111.P$2, SW123.P$1
C2: SW122.P$2, SW134.P$1
C3: SW121.P$2, SW133.P$1
C4: SW120.P$2, SW132.P$1
C5: SW119.P$2, SW131.P$1
C6: SW118.P$4, SW130.P$3
C7: SW117.P$4, SW129.P$3
C8: SW116.P$4, SW128.P$3
C9: SW115.P$4, SW127.P$3
C10: SW102.P$4, SW114.P$3
C11: SW101.P$4, SW113.P$3
C12: SW1.P$2, SW2.P$1
C13: SW6.P$2, SW7.P$1
C14: SW12.P$2, SW13.P$1
C15: SW18.P$2, SW19.P$1
C16: SW24.P$2, SW25.P$1
C17: SW30.P$2, SW31.P$1
C18: SW36.P$4, SW37.P$3
C19: SW42.P$4, SW43.P$3
C20: SW48.P$4, SW49.P$3
C21: SW54.P$4, SW55.P$3
C22: SW59.P$4, SW60.P$3
C23: SW64.P$4, SW65.P$3
unnamed: SW123.P$2, SW135.P$1
unnamed: SW114.P$4, SW126.P$3
unnamed: SW7.P$2, SW8.P$1
unnamed: SW60.P$4, SW61.P$3
R0: SW101.P$1, SW102.P$1, SW103.P$1, SW104.P$1, SW105.P$1, SW106.P$1, SW107.P$3, SW108.P$3, SW109.P$3, SW110.P$3, SW111.P$3, SW112.P$3
R1: SW113.P$1, SW114.P$1, SW115.P$1, SW116.P$1, SW117.P$1, SW118.P$1, SW119.P$3, SW120.P$3, SW121.P$3, SW122.P$3, SW123.P$3, SW124.P$3
R2: SW125.P$1, SW126.P$1, SW127.P$1, SW128.P$1, SW129.P$1, SW130.P$1, SW131.P$3, SW132.P$3, SW133.P$3, SW134.P$3, SW135.P$3, SW136.P$3
R3: SW137.P$1, SW138.P$1, SW139.P$1, SW140.P$1, SW141.P$1, SW142.P$1, SW143.P$3, SW144.P$3, SW145.P$3, SW146.P$3, SW147.P$3, SW148.P$3
R4: SW149.P$1, SW150.P$1, SW151.P$1, SW152.P$1, SW153.P$1, SW154.P$1, SW155.P$3, SW156.P$3, SW157.P$3, SW158.P$3, SW159.P$3, SW160.P$3
R5: SW163.P$1, SW164.P$1, SW165.P$1, SW166.P$1, SW167.P$3, SW168.P$3, SW169.P$3, SW170.P$3
R6: SW1.P$3, SW6.P$3, SW11.P$3, SW17.P$3, SW23.P$3, SW29.P$3, SW35.P$1, SW41.P$1, SW47.P$1, SW53.P$1, SW59.P$1, SW64.P$1
R7: SW2.P$3, SW7.P$3, SW12.P$3, SW18.P$3, SW24.P$3, SW30.P$3, SW36.P$1, SW42.P$1, SW48.P$1, SW54.P$1, SW60.P$1, SW65.P$1
R8: SW3.P$3, SW8.P$3, SW13.P$3, SW19.P$3, SW25.P$3, SW31.P$3, SW37.P$1, SW43.P$1, SW49.P$1, SW55.P$1, SW61.P$1, SW66.P$1
R9: SW4.P$3, SW9.P$3, SW14.P$3, SW20.P$3, SW26.P$3, SW32.P$3, SW38.P$1, SW44.P$1, SW50.P$1, SW56.P$1, SW62.P$1, SW67.P$1
R10: SW5.P$3, SW10.P$3, SW15.P$3, SW21.P$3, SW27.P$3, SW33.P$3, SW39.P$1, SW45.P$1, SW51.P$1, SW57.P$1, SW63.P$1, SW68.P$1
R11: SW16.P$3, SW22.P$3, SW28.P$3, SW34.P$3, SW40.P$1, SW46.P$1, SW52.P$1, SW58.P$1
