IMD555/BTKB/PCB/v2/Battery_Stay/Battery_Stay.brd

## EAGLE design PCB/v2/Battery_Stay/Battery_Stay.brd (2021-03-14)

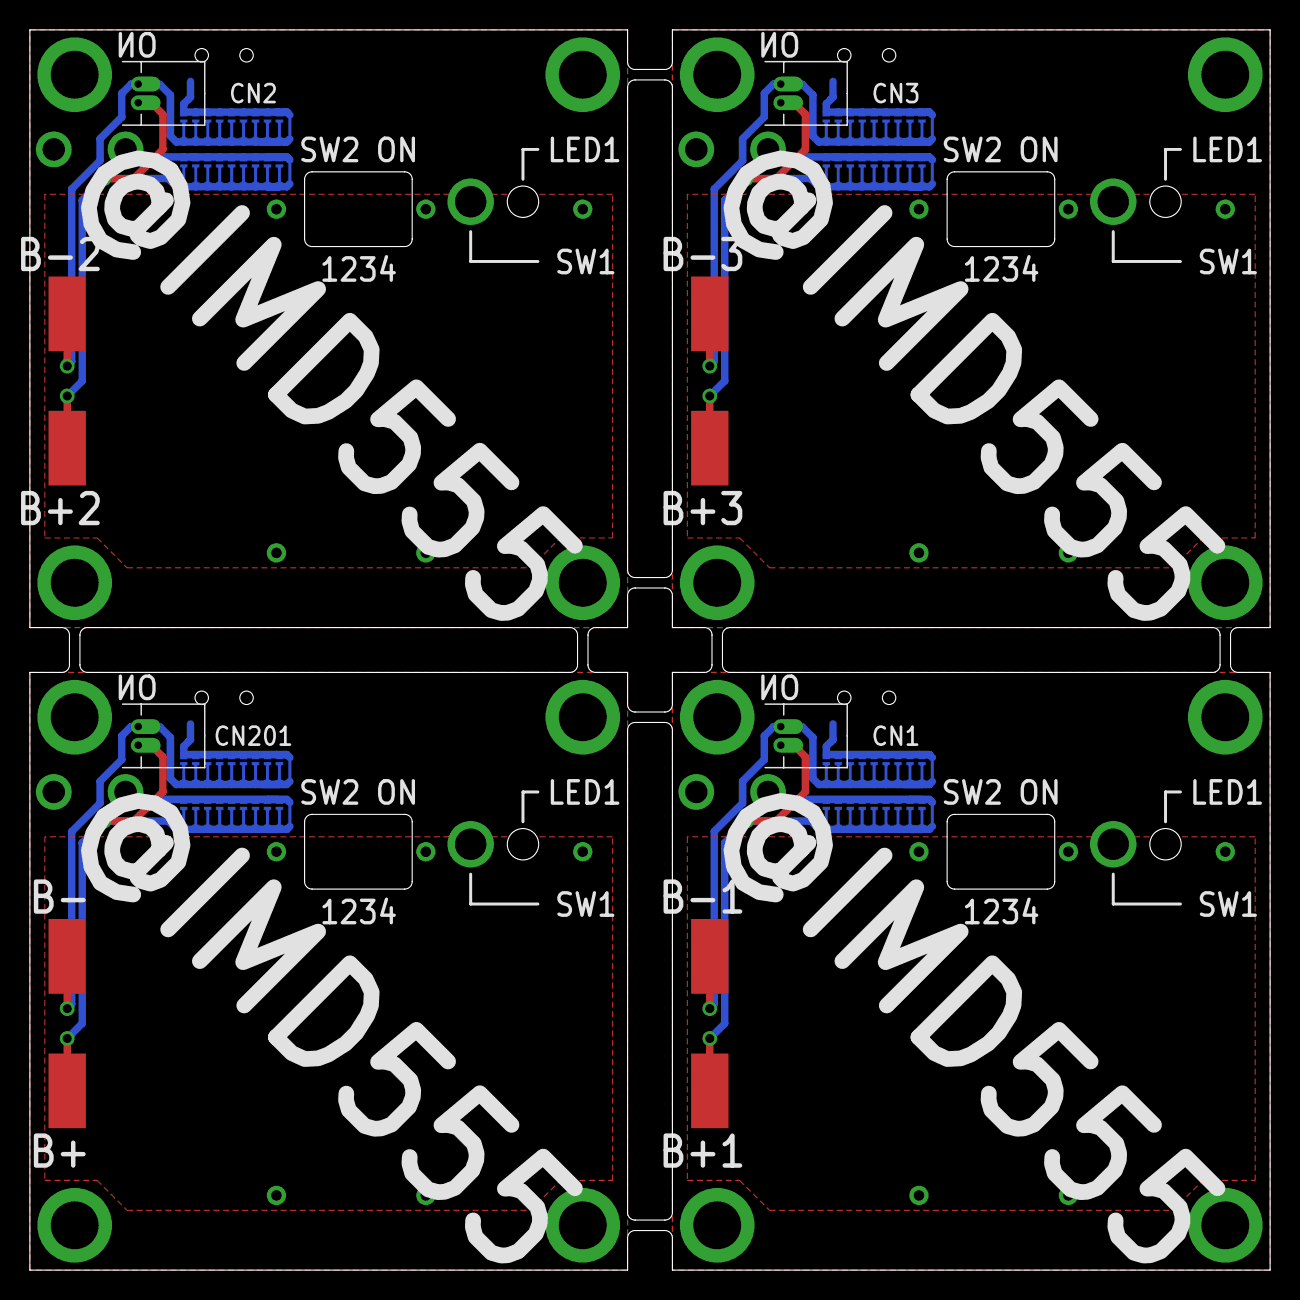
[picture p43: board Battery_Stay.brd from above]

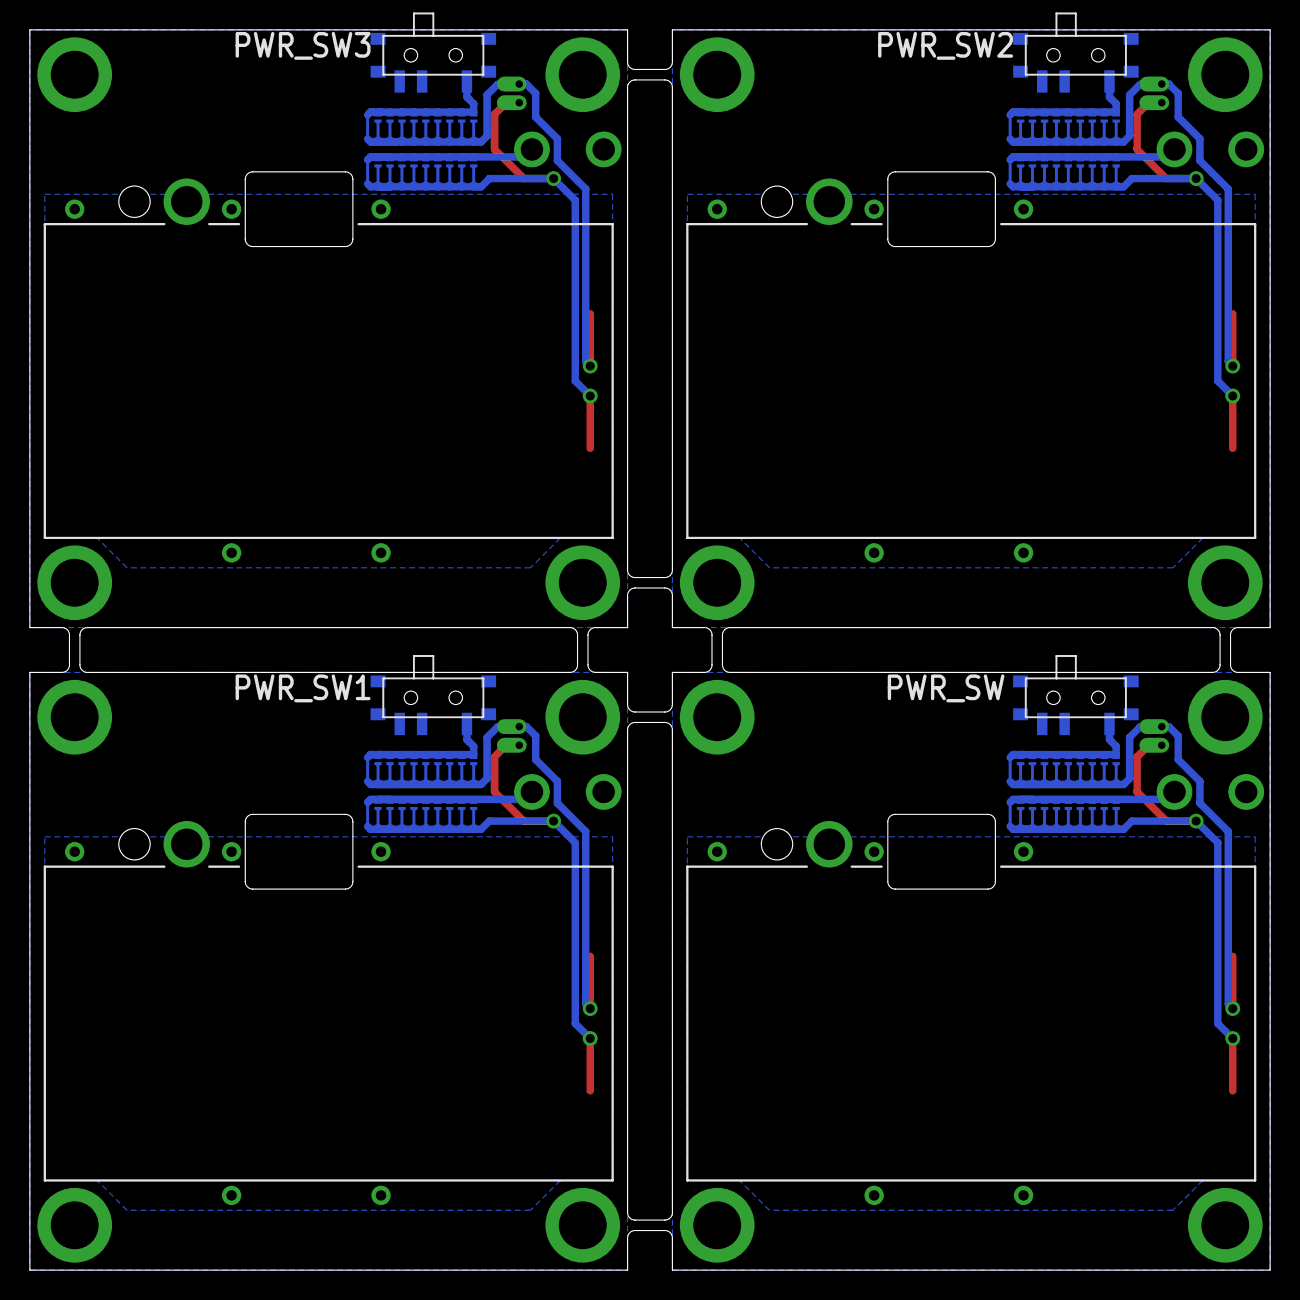
[picture p44: board Battery_Stay.brd from below]

Board: 2 copper layers, 83.0 x 83.0 mm, 88 parts (76 on the bottom side), 20 nets.

Parts:
B+, B+1, B+2, B+3: +; SMD2,5-5
B-, B-1, B-2, B-3: -; SMD2,5-5
CN1, CN2, CN3, CN201: 53048-0210
F1, F2, F3, F4, F5, F6, F7, F8, F9, F10, F11, F12, F13, F14, F15, F16, F17, F18, F19, F20, F21, F22, F23, F24, F25, F26, F27, F28, F29, F30, F31, F32, F33, F34, F35, F36, F37, F38, F39, F40, F41, F42, F43, F44, F45, F46, F47, F48, F49, F50, F51, F52, F53, F54, F55, F56, F57, F58, F59, F60, F61, F62, F63, F64, F65, F66, F67, F68, F69, F70, F71, F72: FUSEPAT0.2; FUSE_PAT1
PWR_SW, PWR_SW1, PWR_SW2, PWR_SW3: MA12R

Connections:
GND: PWR_SW.P$2, PWR_SW.P$3, PWR_SW.P$4, PWR_SW.P$5, PWR_SW.P$6, PWR_SW.P$7
GND1: PWR_SW1.P$2, PWR_SW1.P$3, PWR_SW1.P$4, PWR_SW1.P$5, PWR_SW1.P$6, PWR_SW1.P$7
GND2: PWR_SW2.P$2, PWR_SW2.P$3, PWR_SW2.P$4, PWR_SW2.P$5, PWR_SW2.P$6, PWR_SW2.P$7
GND3: PWR_SW3.P$2, PWR_SW3.P$3, PWR_SW3.P$4, PWR_SW3.P$5, PWR_SW3.P$6, PWR_SW3.P$7
unnamed: F1.P$1, F2.P$1, F3.P$1, F4.P$1, F5.P$1, F6.P$1, F13.P$1, F14.P$1, F15.P$1, PWR_SW.P$1
unnamed: B-.1, CN201.2, F1.P$2, F2.P$2, F3.P$2, F4.P$2, F5.P$2, F6.P$2, F13.P$2, F14.P$2, F15.P$2
unnamed: F7.P$1, F8.P$1, F9.P$1, F10.P$1, F11.P$1, F12.P$1, F17.P$1, F18.P$1, F19.P$1
unnamed: B+.1, CN201.1, F7.P$2, F8.P$2, F9.P$2, F10.P$2, F11.P$2, F12.P$2, F17.P$2, F18.P$2, F19.P$2
unnamed: F16.P$1, F23.P$1, F24.P$1, F25.P$1, F26.P$1, F27.P$1, F31.P$1, F32.P$1, F33.P$1, PWR_SW1.P$1
unnamed: B-1.1, CN1.2, F16.P$2, F23.P$2, F24.P$2, F25.P$2, F26.P$2, F27.P$2, F31.P$2, F32.P$2, F33.P$2
unnamed: F20.P$1, F21.P$1, F22.P$1, F28.P$1, F29.P$1, F30.P$1, F34.P$1, F35.P$1, F36.P$1
unnamed: B+1.1, CN1.1, F20.P$2, F21.P$2, F22.P$2, F28.P$2, F29.P$2, F30.P$2, F34.P$2, F35.P$2, F36.P$2
unnamed: F37.P$1, F41.P$1, F42.P$1, F43.P$1, F44.P$1, F45.P$1, F49.P$1, F50.P$1, F51.P$1, PWR_SW2.P$1
unnamed: B-2.1, CN2.2, F37.P$2, F41.P$2, F42.P$2, F43.P$2, F44.P$2, F45.P$2, F49.P$2, F50.P$2, F51.P$2
unnamed: F38.P$1, F39.P$1, F40.P$1, F46.P$1, F47.P$1, F48.P$1, F52.P$1, F53.P$1, F54.P$1
unnamed: B+2.1, CN2.1, F38.P$2, F39.P$2, F40.P$2, F46.P$2, F47.P$2, F48.P$2, F52.P$2, F53.P$2, F54.P$2
unnamed: F55.P$1, F59.P$1, F60.P$1, F61.P$1, F62.P$1, F63.P$1, F67.P$1, F68.P$1, F69.P$1, PWR_SW3.P$1
unnamed: B-3.1, CN3.2, F55.P$2, F59.P$2, F60.P$2, F61.P$2, F62.P$2, F63.P$2, F67.P$2, F68.P$2, F69.P$2
unnamed: F56.P$1, F57.P$1, F58.P$1, F64.P$1, F65.P$1, F66.P$1, F70.P$1, F71.P$1, F72.P$1
unnamed: B+3.1, CN3.1, F56.P$2, F57.P$2, F58.P$2, F64.P$2, F65.P$2, F66.P$2, F70.P$2, F71.P$2, F72.P$2
