IMD555/BTKB/PCB/v2/Micro_QWERTY/Micro_QWERTY.brd

## EAGLE design PCB/v2/Micro_QWERTY/Micro_QWERTY.brd (2021-03-14)

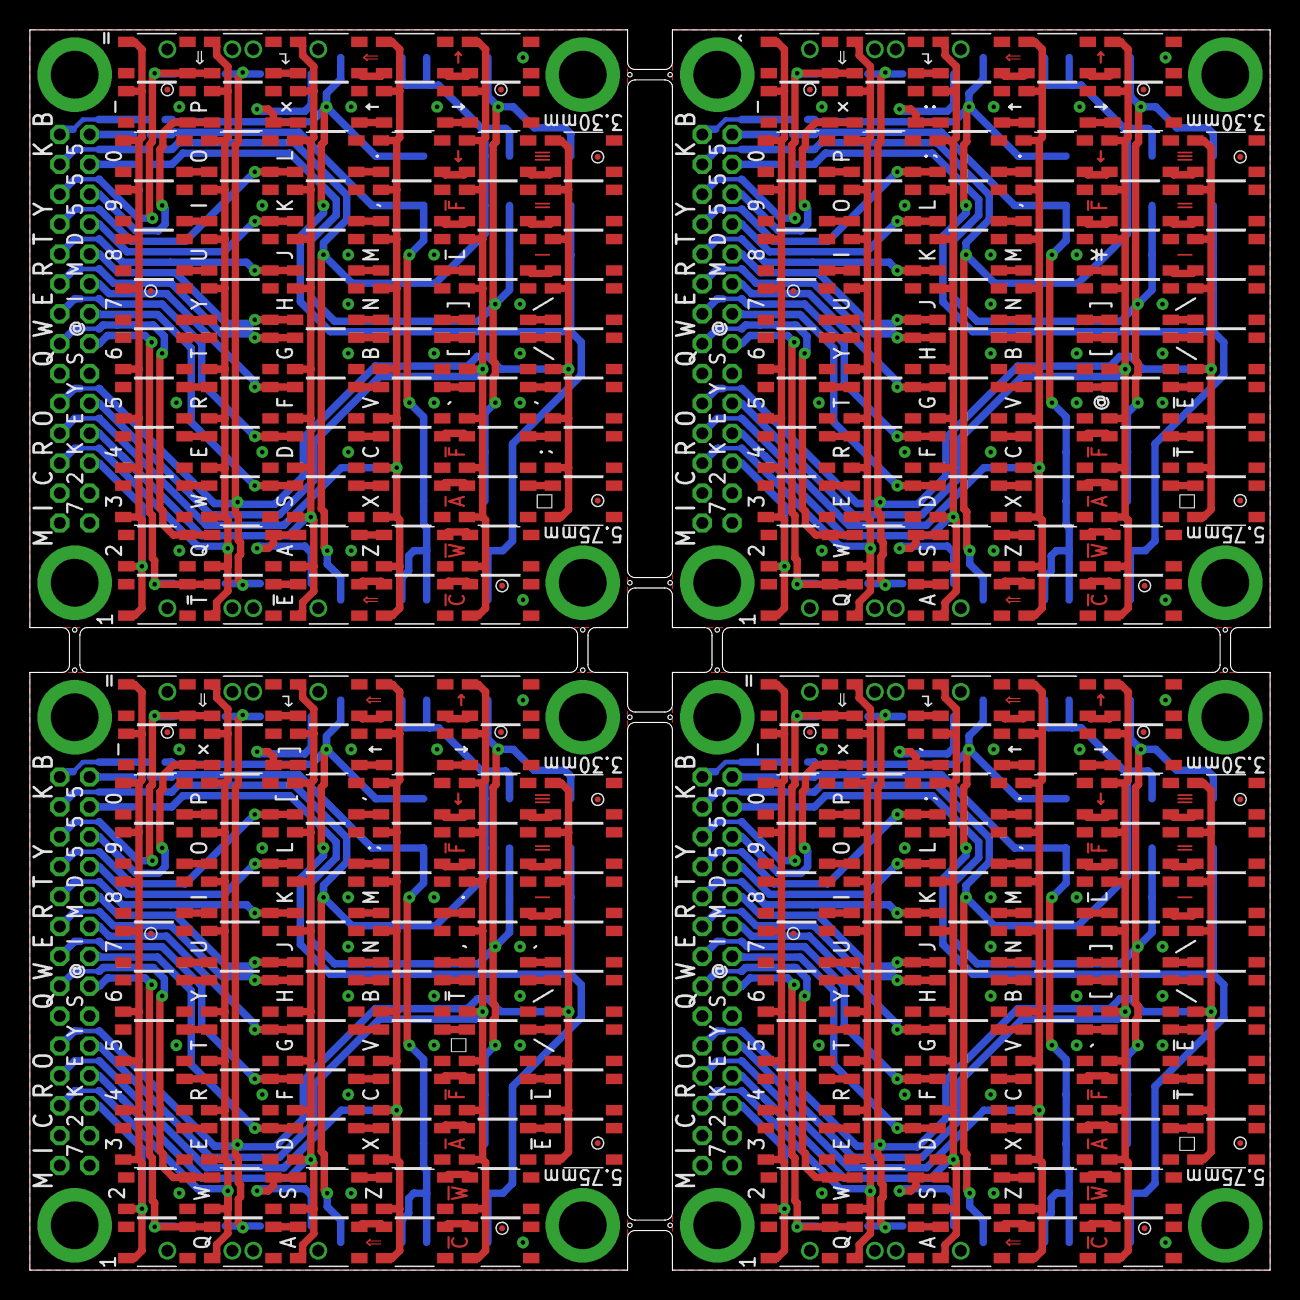
[picture p45: board Micro_QWERTY.brd from above]

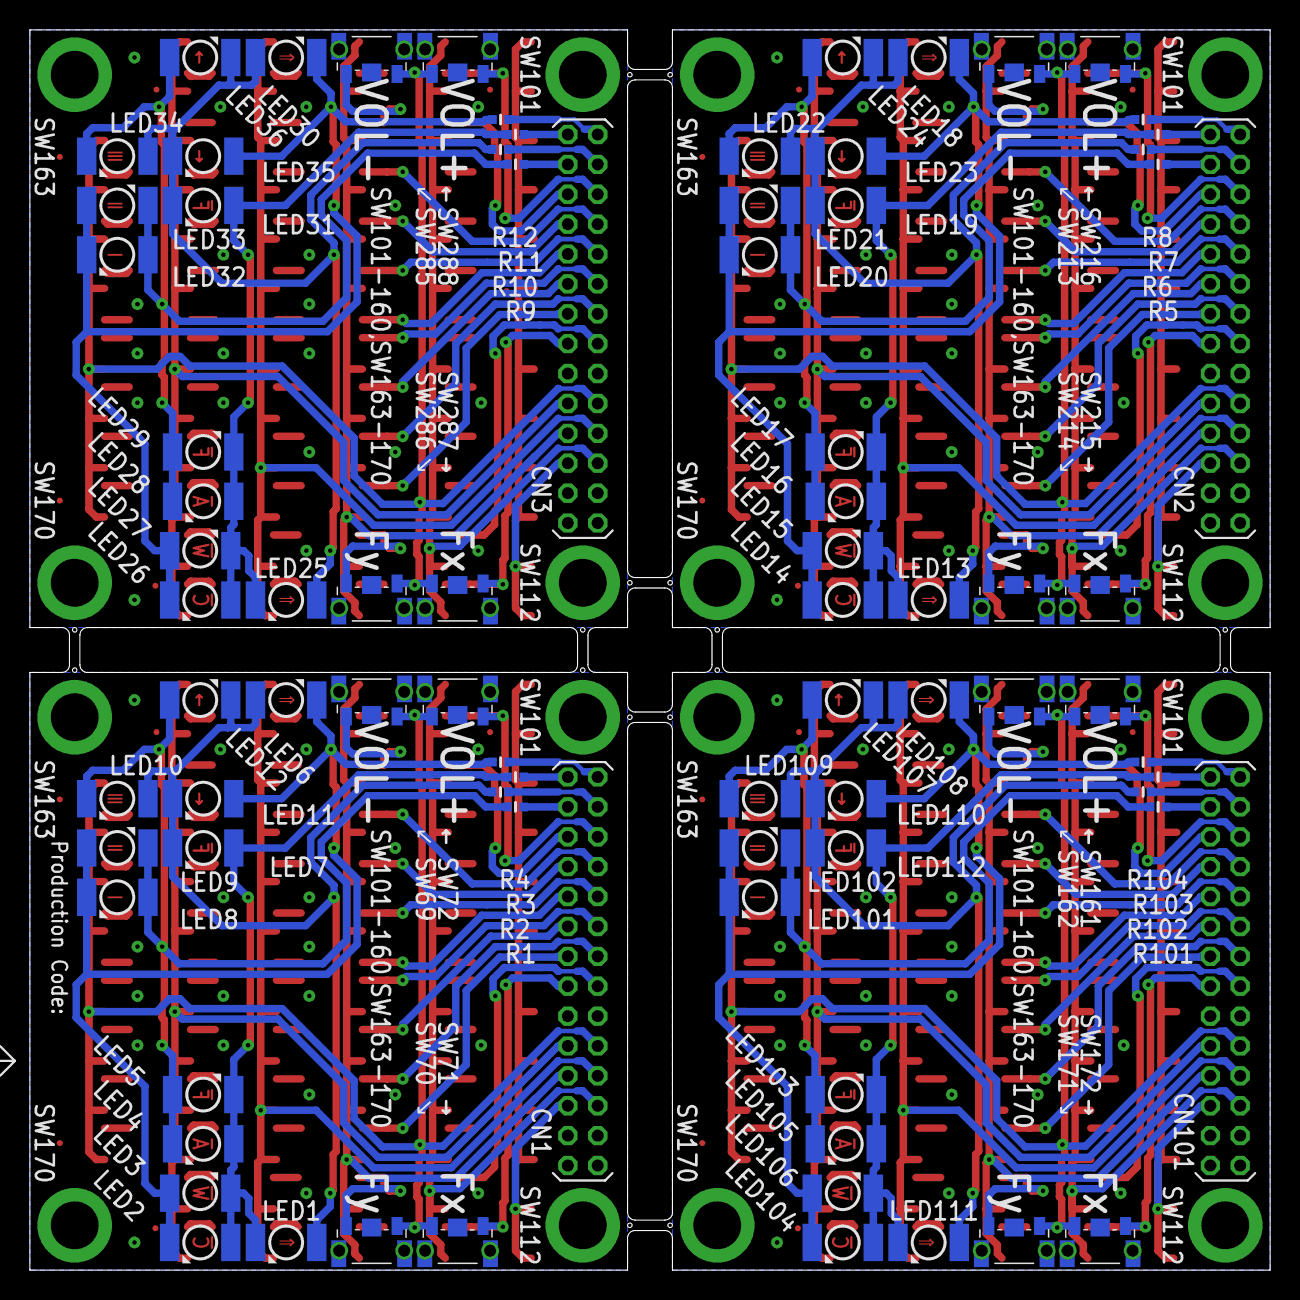
[picture p46: board Micro_QWERTY.brd from below]

Board: 2 copper layers, 83.0 x 83.0 mm, 380 parts (84 on the bottom side), 284 nets.

Parts:
CN1, CN2, CN3, CN101: 14X2R; 2MM_14X2_R
LED1, LED13, LED25, LED111: Shift_Left; P-LCC-2-TOPLED-RG-WINDOW
LED2, LED14, LED26, LED104: Ctrl; P-LCC-2-TOPLED-RG-WINDOW
LED3, LED15, LED27, LED106: Win; P-LCC-2-TOPLED-RG-WINDOW
LED4, LED16, LED28, LED105: Alt; P-LCC-2-TOPLED-RG-WINDOW
LED5, LED17, LED29, LED103: Fn_Left; P-LCC-2-TOPLED-RG-WINDOW
LED6, LED18, LED30, LED108: Shift_Right; P-LCC-2-TOPLED-RG-WINDOW
LED7, LED19, LED31, LED112: Fn_Right; P-LCC-2-TOPLED-RG-WINDOW
LED8, LED20, LED32, LED101: M1; P-LCC-2-TOPLED-RG-WINDOW
LED9, LED21, LED33, LED102: M2; P-LCC-2-TOPLED-RG-WINDOW
LED10, LED22, LED34, LED109: M3; P-LCC-2-TOPLED-RG-WINDOW
LED11, LED23, LED35, LED110: Cursor_Left; P-LCC-2-TOPLED-RG-WINDOW
LED12, LED24, LED36, LED107: Cursor_Right; P-LCC-2-TOPLED-RG-WINDOW
R1, R2, R3, R4, R5, R6, R7, R8, R9, R10, R11, R12, R101, R102, R103, R104: R0402-SS
SW1, SW73, SW112, SW217: SKRP(ALPS); TVAU10-025
SW2, SW3, SW4, SW5, SW6, SW7, SW8, SW9, SW10, SW11, SW12, SW13, SW14, SW15, SW16, SW17, SW18, SW19, SW20, SW21, SW22, SW23, SW24, SW25, SW26, SW27, SW28, SW29, SW30, SW31, SW32, SW33, SW34, SW35, SW36, SW37, SW38, SW39, SW40, SW41, SW42, SW43, SW44, SW45, SW46, SW47, SW48, SW49, SW50, SW51, SW52, SW53, SW54, SW55, SW56, SW57, SW58, SW59, SW60, SW61, SW62, SW63, SW64, SW65, SW66, SW67, SW68, SW74, SW75, SW76, SW77, SW78, SW79, SW80, SW81, SW82, SW83, SW84, SW85, SW86, SW87, SW88, SW89, SW90, SW91, SW92, SW93, SW94, SW95, SW96, SW97, SW98, SW99, SW100, SW101, SW102, SW103, SW104, SW105, SW106, SW107, SW108, SW109, SW110, SW111, SW113, SW114, SW115, SW116, SW117, SW118, SW119, SW120, SW121, SW122, SW123, SW124, SW125, SW126, SW127, SW128, SW129, SW130, SW131, SW132, SW133, SW134, SW135, SW136, SW137, SW138, SW139, SW140, SW141, SW142, SW143, SW144, SW145, SW146, SW147, SW148, SW149, SW150, SW151, SW152, SW153, SW154, SW155, SW156, SW157, SW158, SW159, SW160, SW163, SW164, SW165, SW166, SW167, SW168, SW169, SW170, SW173, SW174, SW175, SW176, SW177, SW178, SW179, SW180, SW181, SW182, SW183, SW184, SW185, SW186, SW187, SW188, SW189, SW190, SW191, SW192, SW193, SW194, SW195, SW196, SW197, SW198, SW199, SW200, SW201, SW202, SW203, SW204, SW205, SW206, SW207, SW208, SW209, SW210, SW211, SW212, SW218, SW219, SW220, SW221, SW222, SW223, SW224, SW225, SW226, SW227, SW228, SW229, SW230, SW231, SW232, SW233, SW234, SW235, SW236, SW237, SW238, SW239, SW240, SW241, SW242, SW243, SW244, SW245, SW246, SW247, SW248, SW249, SW250, SW251, SW252, SW253, SW254, SW255, SW256, SW257, SW258, SW259, SW260, SW261, SW262, SW263, SW264, SW265, SW266, SW267, SW268, SW269, SW270, SW271, SW272, SW273, SW274, SW275, SW276, SW277, SW278, SW279, SW280, SW281, SW282, SW283, SW284: SW_4PTVAU10-025; TVAU10-025
SW69, SW70, SW72, SW161, SW162, SW171, SW213, SW214, SW216, SW285, SW286, SW288: SW_WITH_EARTHX; THAM05
SW71, SW172, SW215, SW287: THAM05 or TS-018A; THAM05
U$1, U$2, U$3, U$4, U$5, U$6, U$7, U$8, U$9, U$10, U$11, U$12, U$13, U$14, U$15, U$16, U$17, U$18, U$19, U$20, U$21, U$22, U$23, U$24: PCB_CHECK

Connections:
C0: CN101.13, SW112.P$2, SW124.P$1, SW172.P$1
C1: CN101.14, SW111.P$2, SW123.P$1
C2: CN101.15, SW122.P$2, SW134.P$1
C3: CN101.16, SW121.P$2, SW133.P$1
C4: CN101.17, SW120.P$2, SW132.P$1
C5: CN101.18, SW119.P$2, SW131.P$1
C6: CN101.19, SW118.P$4, SW130.P$3
C7: CN101.20, SW117.P$4, SW129.P$3
C8: CN101.21, SW116.P$4, SW128.P$3
C9: CN101.22, SW115.P$4, SW127.P$3
C10: CN101.23, SW102.P$4, SW114.P$3
C11: CN101.24, SW101.P$4, SW113.P$3, SW161.P$2
C12: CN1.13, SW1.P$2, SW2.P$1, SW71.P$1
C13: CN1.14, SW6.P$2, SW7.P$1
C14: CN1.15, SW12.P$2, SW13.P$1
C15: CN1.16, SW18.P$2, SW19.P$1
C16: CN1.17, SW24.P$2, SW25.P$1
C17: CN1.18, SW30.P$2, SW31.P$1
C18: CN1.19, SW36.P$4, SW37.P$3
C19: CN1.20, SW42.P$4, SW43.P$3
C20: CN1.21, SW48.P$4, SW49.P$3
C21: CN1.22, SW54.P$4, SW55.P$3
C22: CN1.23, SW59.P$4, SW60.P$3
C23: CN1.24, SW64.P$4, SW65.P$3, SW72.P$2
C24: CN2.13, SW73.P$2, SW74.P$1, SW215.P$1
C25: CN2.14, SW78.P$2, SW79.P$1
C26: CN2.15, SW84.P$2, SW85.P$1
C27: CN2.16, SW90.P$2, SW91.P$1
C28: CN2.17, SW96.P$2, SW97.P$1
C29: CN2.18, SW174.P$2, SW175.P$1
C30: CN2.19, SW180.P$4, SW181.P$3
C31: CN2.20, SW186.P$4, SW187.P$3
C32: CN2.21, SW192.P$4, SW193.P$3
C33: CN2.22, SW198.P$4, SW199.P$3
C34: CN2.23, SW203.P$4, SW204.P$3
C35: CN2.24, SW208.P$4, SW209.P$3, SW216.P$2
C36: CN3.13, SW217.P$2, SW218.P$1, SW287.P$1
C37: CN3.14, SW222.P$2, SW223.P$1
C38: CN3.15, SW228.P$2, SW229.P$1
C39: CN3.16, SW234.P$2, SW235.P$1
C40: CN3.17, SW240.P$2, SW241.P$1
C41: CN3.18, SW246.P$2, SW247.P$1
C42: CN3.19, SW252.P$4, SW253.P$3
C43: CN3.20, SW258.P$4, SW259.P$3
C44: CN3.21, SW264.P$4, SW265.P$3
C45: CN3.22, SW270.P$4, SW271.P$3
C46: CN3.23, SW275.P$4, SW276.P$3
C47: CN3.24, SW280.P$4, SW281.P$3, SW288.P$2
GND: CN101.2, CN101.4, SW161.S1, SW161.S2, SW161.S3, SW161.S4, SW161.S5, SW162.S1, SW162.S2, SW162.S3, SW162.S4, SW162.S5, SW171.S1, SW171.S2, SW171.S3, SW171.S4, SW171.S5, SW172.S1, SW172.S2, SW172.S3, SW172.S4, SW172.S5
GND1: CN1.2, CN1.4, SW69.S1, SW69.S2, SW69.S3, SW69.S4, SW69.S5, SW70.S1, SW70.S2, SW70.S3, SW70.S4, SW70.S5, SW71.S1, SW71.S2, SW71.S3, SW71.S4, SW71.S5, SW72.S1, SW72.S2, SW72.S3, SW72.S4, SW72.S5
GND2: CN2.2, CN2.4, SW213.S1, SW213.S2, SW213.S3, SW213.S4, SW213.S5, SW214.S1, SW214.S2, SW214.S3, SW214.S4, SW214.S5, SW215.S1, SW215.S2, SW215.S3, SW215.S4, SW215.S5, SW216.S1, SW216.S2, SW216.S3, SW216.S4, SW216.S5
GND3: CN3.2, CN3.4, SW285.S1, SW285.S2, SW285.S3, SW285.S4, SW285.S5, SW286.S1, SW286.S2, SW286.S3, SW286.S4, SW286.S5, SW287.S1, SW287.S2, SW287.S3, SW287.S4, SW287.S5, SW288.S1, SW288.S2, SW288.S3, SW288.S4, SW288.S5
L0: CN101.28, R104.2
L1: CN101.27, R103.2
L2: CN101.26, R102.2
L3: CN101.25, R101.2
L4: CN1.26, R2.2
L5: CN1.28, R4.2
L6: CN1.25, R1.2
L7: CN1.27, R3.2
L8: CN2.26, R6.2
L9: CN2.28, R8.2
L10: CN2.25, R5.2
L11: CN2.27, R7.2
L12: CN3.26, R10.2
L13: CN3.28, R12.2
L14: CN3.25, R9.2
L15: CN3.27, R11.2
unnamed: LED107.C, LED108.A, LED109.A, LED110.C, LED111.A, LED112.C, R102.1
unnamed: LED101.A, LED102.C, LED103.A, LED105.C, LED107.A, LED109.C, R101.1
unnamed: LED103.C, LED104.A, LED105.A, LED106.C, LED111.C, LED112.A, R103.1
unnamed: LED101.C, LED102.A, LED104.C, LED106.A, LED108.C, LED110.A, R104.1
unnamed: SW123.P$2, SW135.P$1, SW171.P$2
unnamed: SW113.P$4, SW125.P$3
unnamed: SW114.P$4, SW126.P$3, SW162.P$1
unnamed: SW29.P$2, SW30.P$1
unnamed: SW106.P$4, SW118.P$3
unnamed: SW130.P$4, SW142.P$3
unnamed: SW154.P$4, SW166.P$3
unnamed: SW142.P$4, SW154.P$3
unnamed: SW105.P$4, SW117.P$3
unnamed: SW129.P$4, SW141.P$3
unnamed: SW153.P$4, SW165.P$3
unnamed: SW141.P$4, SW153.P$3
unnamed: SW104.P$4, SW116.P$3
unnamed: SW128.P$4, SW140.P$3
unnamed: SW152.P$4, SW164.P$3
unnamed: SW140.P$4, SW152.P$3
unnamed: SW103.P$4, SW115.P$3
unnamed: SW127.P$4, SW139.P$3
unnamed: SW151.P$4, SW163.P$3
unnamed: SW139.P$4, SW151.P$3
unnamed: SW31.P$2, SW32.P$1
unnamed: SW126.P$4, SW138.P$3
unnamed: SW32.P$2, SW33.P$1
unnamed: SW138.P$4, SW150.P$3
unnamed: SW33.P$2, SW34.P$1
unnamed: SW125.P$4, SW137.P$3
unnamed: SW2.P$2, SW3.P$1
unnamed: SW137.P$4, SW149.P$3
unnamed: SW3.P$2, SW4.P$1
unnamed: SW4.P$2, SW5.P$1
unnamed: SW8.P$2, SW9.P$1
unnamed: SW9.P$2, SW10.P$1
unnamed: SW11.P$2, SW12.P$1
unnamed: SW13.P$2, SW14.P$1
unnamed: SW14.P$2, SW15.P$1
unnamed: SW15.P$2, SW16.P$1
unnamed: SW107.P$2, SW119.P$1
unnamed: SW17.P$2, SW18.P$1
unnamed: SW131.P$2, SW143.P$1
unnamed: SW155.P$2, SW167.P$1
unnamed: SW143.P$2, SW155.P$1
unnamed: SW108.P$2, SW120.P$1
unnamed: SW19.P$2, SW20.P$1
unnamed: SW132.P$2, SW144.P$1
unnamed: SW156.P$2, SW168.P$1
unnamed: SW144.P$2, SW156.P$1
unnamed: SW109.P$2, SW121.P$1
unnamed: SW20.P$2, SW21.P$1
unnamed: SW133.P$2, SW145.P$1
unnamed: SW157.P$2, SW169.P$1
unnamed: SW145.P$2, SW157.P$1
unnamed: SW110.P$2, SW122.P$1
unnamed: SW21.P$2, SW22.P$1
unnamed: SW134.P$2, SW146.P$1
unnamed: SW158.P$2, SW170.P$1
unnamed: SW146.P$2, SW158.P$1
unnamed: SW23.P$2, SW24.P$1
unnamed: SW25.P$2, SW26.P$1
unnamed: SW26.P$2, SW27.P$1
unnamed: SW27.P$2, SW28.P$1
unnamed: LED1.A, LED6.A, LED7.C, LED10.A, LED11.C, LED12.C, R2.1
unnamed: LED4.C, LED5.A, LED8.A, LED9.C, LED10.C, LED12.A, R1.1
unnamed: LED1.C, LED2.A, LED3.C, LED4.A, LED5.C, LED7.A, R3.1
unnamed: SW135.P$2, SW147.P$1
unnamed: LED2.C, LED3.A, LED6.C, LED8.C, LED9.A, LED11.A, R4.1
unnamed: SW147.P$2, SW159.P$1
unnamed: SW41.P$4, SW42.P$3
unnamed: SW124.P$2, SW136.P$1
unnamed: SW136.P$2, SW148.P$1
unnamed: SW43.P$4, SW44.P$3
unnamed: SW148.P$2, SW160.P$1
unnamed: SW44.P$4, SW45.P$3
unnamed: SW45.P$4, SW46.P$3
unnamed: SW47.P$4, SW48.P$3
unnamed: SW49.P$4, SW50.P$3
unnamed: SW50.P$4, SW51.P$3
unnamed: SW51.P$4, SW52.P$3
unnamed: SW53.P$4, SW54.P$3
unnamed: SW55.P$4, SW56.P$3
unnamed: SW56.P$4, SW57.P$3
unnamed: SW57.P$4, SW58.P$3
unnamed: SW61.P$4, SW62.P$3
unnamed: SW62.P$4, SW63.P$3
unnamed: SW66.P$4, SW67.P$3
unnamed: SW67.P$4, SW68.P$3
unnamed: SW35.P$4, SW36.P$3
unnamed: SW37.P$4, SW38.P$3
unnamed: SW38.P$4, SW39.P$3
unnamed: SW39.P$4, SW40.P$3
unnamed: SW7.P$2, SW8.P$1, SW70.P$2
unnamed: SW65.P$4, SW66.P$3
unnamed: SW60.P$4, SW61.P$3, SW69.P$1
unnamed: SW173.P$2, SW174.P$1
unnamed: SW175.P$2, SW176.P$1
unnamed: SW176.P$2, SW177.P$1
unnamed: SW177.P$2, SW178.P$1
unnamed: SW74.P$2, SW75.P$1
unnamed: SW75.P$2, SW76.P$1
unnamed: SW76.P$2, SW77.P$1
unnamed: SW80.P$2, SW81.P$1
unnamed: SW81.P$2, SW82.P$1
unnamed: SW83.P$2, SW84.P$1
unnamed: SW85.P$2, SW86.P$1
unnamed: SW86.P$2, SW87.P$1
unnamed: SW87.P$2, SW88.P$1
unnamed: SW89.P$2, SW90.P$1
unnamed: SW91.P$2, SW92.P$1
unnamed: SW92.P$2, SW93.P$1
unnamed: SW93.P$2, SW94.P$1
unnamed: SW95.P$2, SW96.P$1
unnamed: SW97.P$2, SW98.P$1
unnamed: SW98.P$2, SW99.P$1
unnamed: SW99.P$2, SW100.P$1
unnamed: LED13.A, LED18.A, LED19.C, LED22.A, LED23.C, LED24.C, R6.1
unnamed: LED16.C, LED17.A, LED20.A, LED21.C, LED22.C, LED24.A, R5.1
unnamed: LED13.C, LED14.A, LED15.C, LED16.A, LED17.C, LED19.A, R7.1
unnamed: LED14.C, LED15.A, LED18.C, LED20.C, LED21.A, LED23.A, R8.1
unnamed: SW185.P$4, SW186.P$3
unnamed: SW187.P$4, SW188.P$3
unnamed: SW188.P$4, SW189.P$3
unnamed: SW189.P$4, SW190.P$3
unnamed: SW191.P$4, SW192.P$3
unnamed: SW193.P$4, SW194.P$3
unnamed: SW194.P$4, SW195.P$3
unnamed: SW195.P$4, SW196.P$3
unnamed: SW197.P$4, SW198.P$3
unnamed: SW199.P$4, SW200.P$3
unnamed: SW200.P$4, SW201.P$3
unnamed: SW201.P$4, SW202.P$3
unnamed: SW205.P$4, SW206.P$3
unnamed: SW206.P$4, SW207.P$3
unnamed: SW210.P$4, SW211.P$3
unnamed: SW211.P$4, SW212.P$3
unnamed: SW179.P$4, SW180.P$3
unnamed: SW181.P$4, SW182.P$3
unnamed: SW182.P$4, SW183.P$3
unnamed: SW183.P$4, SW184.P$3
unnamed: SW79.P$2, SW80.P$1, SW214.P$2
unnamed: SW209.P$4, SW210.P$3
unnamed: SW204.P$4, SW205.P$3, SW213.P$1
unnamed: SW245.P$2, SW246.P$1
unnamed: SW247.P$2, SW248.P$1
unnamed: SW248.P$2, SW249.P$1
unnamed: SW249.P$2, SW250.P$1
unnamed: SW218.P$2, SW219.P$1
unnamed: SW219.P$2, SW220.P$1
unnamed: SW220.P$2, SW221.P$1
unnamed: SW224.P$2, SW225.P$1
unnamed: SW225.P$2, SW226.P$1
unnamed: SW227.P$2, SW228.P$1
unnamed: SW229.P$2, SW230.P$1
unnamed: SW230.P$2, SW231.P$1
unnamed: SW231.P$2, SW232.P$1
unnamed: SW233.P$2, SW234.P$1
unnamed: SW235.P$2, SW236.P$1
unnamed: SW236.P$2, SW237.P$1
unnamed: SW237.P$2, SW238.P$1
unnamed: SW239.P$2, SW240.P$1
unnamed: SW241.P$2, SW242.P$1
unnamed: SW242.P$2, SW243.P$1
unnamed: SW243.P$2, SW244.P$1
unnamed: LED25.A, LED30.A, LED31.C, LED34.A, LED35.C, LED36.C, R10.1
unnamed: LED28.C, LED29.A, LED32.A, LED33.C, LED34.C, LED36.A, R9.1
unnamed: LED25.C, LED26.A, LED27.C, LED28.A, LED29.C, LED31.A, R11.1
unnamed: LED26.C, LED27.A, LED30.C, LED32.C, LED33.A, LED35.A, R12.1
unnamed: SW257.P$4, SW258.P$3
unnamed: SW259.P$4, SW260.P$3
unnamed: SW260.P$4, SW261.P$3
unnamed: SW261.P$4, SW262.P$3
unnamed: SW263.P$4, SW264.P$3
unnamed: SW265.P$4, SW266.P$3
unnamed: SW266.P$4, SW267.P$3
unnamed: SW267.P$4, SW268.P$3
unnamed: SW269.P$4, SW270.P$3
unnamed: SW271.P$4, SW272.P$3
unnamed: SW272.P$4, SW273.P$3
unnamed: SW273.P$4, SW274.P$3
unnamed: SW277.P$4, SW278.P$3
unnamed: SW278.P$4, SW279.P$3
unnamed: SW282.P$4, SW283.P$3
unnamed: SW283.P$4, SW284.P$3
unnamed: SW251.P$4, SW252.P$3
unnamed: SW253.P$4, SW254.P$3
unnamed: SW254.P$4, SW255.P$3
unnamed: SW255.P$4, SW256.P$3
unnamed: SW223.P$2, SW224.P$1, SW286.P$2
unnamed: SW281.P$4, SW282.P$3
unnamed: SW276.P$4, SW277.P$3, SW285.P$1
R0: CN101.5, SW101.P$1, SW102.P$1, SW103.P$1, SW104.P$1, SW105.P$1, SW106.P$1, SW107.P$3, SW108.P$3, SW109.P$3, SW110.P$3, SW111.P$3, SW112.P$3
R1: CN101.6, SW113.P$1, SW114.P$1, SW115.P$1, SW116.P$1, SW117.P$1, SW118.P$1, SW119.P$3, SW120.P$3, SW121.P$3, SW122.P$3, SW123.P$3, SW124.P$3
R2: CN101.7, SW125.P$1, SW126.P$1, SW127.P$1, SW128.P$1, SW129.P$1, SW130.P$1, SW131.P$3, SW132.P$3, SW133.P$3, SW134.P$3, SW135.P$3, SW136.P$3
R3: CN101.8, SW137.P$1, SW138.P$1, SW139.P$1, SW140.P$1, SW141.P$1, SW142.P$1, SW143.P$3, SW144.P$3, SW145.P$3, SW146.P$3, SW147.P$3, SW148.P$3
R4: CN101.9, SW149.P$1, SW150.P$1, SW151.P$1, SW152.P$1, SW153.P$1, SW154.P$1, SW155.P$3, SW156.P$3, SW157.P$3, SW158.P$3, SW159.P$3, SW160.P$3
R5: CN101.10, SW161.P$1, SW162.P$2, SW163.P$1, SW164.P$1, SW165.P$1, SW166.P$1, SW167.P$3, SW168.P$3, SW169.P$3, SW170.P$3, SW171.P$1, SW172.P$2
R6: CN1.5, SW1.P$3, SW6.P$3, SW11.P$3, SW17.P$3, SW23.P$3, SW29.P$3, SW35.P$1, SW41.P$1, SW47.P$1, SW53.P$1, SW59.P$1, SW64.P$1
R7: CN1.6, SW2.P$3, SW7.P$3, SW12.P$3, SW18.P$3, SW24.P$3, SW30.P$3, SW36.P$1, SW42.P$1, SW48.P$1, SW54.P$1, SW60.P$1, SW65.P$1
R8: CN1.7, SW3.P$3, SW8.P$3, SW13.P$3, SW19.P$3, SW25.P$3, SW31.P$3, SW37.P$1, SW43.P$1, SW49.P$1, SW55.P$1, SW61.P$1, SW66.P$1
R9: CN1.8, SW4.P$3, SW9.P$3, SW14.P$3, SW20.P$3, SW26.P$3, SW32.P$3, SW38.P$1, SW44.P$1, SW50.P$1, SW56.P$1, SW62.P$1, SW67.P$1
R10: CN1.9, SW5.P$3, SW10.P$3, SW15.P$3, SW21.P$3, SW27.P$3, SW33.P$3, SW39.P$1, SW45.P$1, SW51.P$1, SW57.P$1, SW63.P$1, SW68.P$1
R11: CN1.10, SW16.P$3, SW22.P$3, SW28.P$3, SW34.P$3, SW40.P$1, SW46.P$1, SW52.P$1, SW58.P$1, SW69.P$2, SW70.P$1, SW71.P$2, SW72.P$1
R12: CN2.5, SW73.P$3, SW78.P$3, SW83.P$3, SW89.P$3, SW95.P$3, SW173.P$3, SW179.P$1, SW185.P$1, SW191.P$1, SW197.P$1, SW203.P$1, SW208.P$1
R13: CN2.6, SW74.P$3, SW79.P$3, SW84.P$3, SW90.P$3, SW96.P$3, SW174.P$3, SW180.P$1, SW186.P$1, SW192.P$1, SW198.P$1, SW204.P$1, SW209.P$1
R14: CN2.7, SW75.P$3, SW80.P$3, SW85.P$3, SW91.P$3, SW97.P$3, SW175.P$3, SW181.P$1, SW187.P$1, SW193.P$1, SW199.P$1, SW205.P$1, SW210.P$1
R15: CN2.8, SW76.P$3, SW81.P$3, SW86.P$3, SW92.P$3, SW98.P$3, SW176.P$3, SW182.P$1, SW188.P$1, SW194.P$1, SW200.P$1, SW206.P$1, SW211.P$1
R16: CN2.9, SW77.P$3, SW82.P$3, SW87.P$3, SW93.P$3, SW99.P$3, SW177.P$3, SW183.P$1, SW189.P$1, SW195.P$1, SW201.P$1, SW207.P$1, SW212.P$1
R17: CN2.10, SW88.P$3, SW94.P$3, SW100.P$3, SW178.P$3, SW184.P$1, SW190.P$1, SW196.P$1, SW202.P$1, SW213.P$2, SW214.P$1, SW215.P$2, SW216.P$1
R18: CN3.5, SW217.P$3, SW222.P$3, SW227.P$3, SW233.P$3, SW239.P$3, SW245.P$3, SW251.P$1, SW257.P$1, SW263.P$1, SW269.P$1, SW275.P$1, SW280.P$1
R19: CN3.6, SW218.P$3, SW223.P$3, SW228.P$3, SW234.P$3, SW240.P$3, SW246.P$3, SW252.P$1, SW258.P$1, SW264.P$1, SW270.P$1, SW276.P$1, SW281.P$1
R20: CN3.7, SW219.P$3, SW224.P$3, SW229.P$3, SW235.P$3, SW241.P$3, SW247.P$3, SW253.P$1, SW259.P$1, SW265.P$1, SW271.P$1, SW277.P$1, SW282.P$1
R21: CN3.8, SW220.P$3, SW225.P$3, SW230.P$3, SW236.P$3, SW242.P$3, SW248.P$3, SW254.P$1, SW260.P$1, SW266.P$1, SW272.P$1, SW278.P$1, SW283.P$1
R22: CN3.9, SW221.P$3, SW226.P$3, SW231.P$3, SW237.P$3, SW243.P$3, SW249.P$3, SW255.P$1, SW261.P$1, SW267.P$1, SW273.P$1, SW279.P$1, SW284.P$1
R23: CN3.10, SW232.P$3, SW238.P$3, SW244.P$3, SW250.P$3, SW256.P$1, SW262.P$1, SW268.P$1, SW274.P$1, SW285.P$2, SW286.P$1, SW287.P$2, SW288.P$1
