IMD555/BTKB/PCB/v1/Main_board/Panelize.brd

## EAGLE design PCB/v1/Main_board/Panelize.brd (2021-03-14, an earlier design)

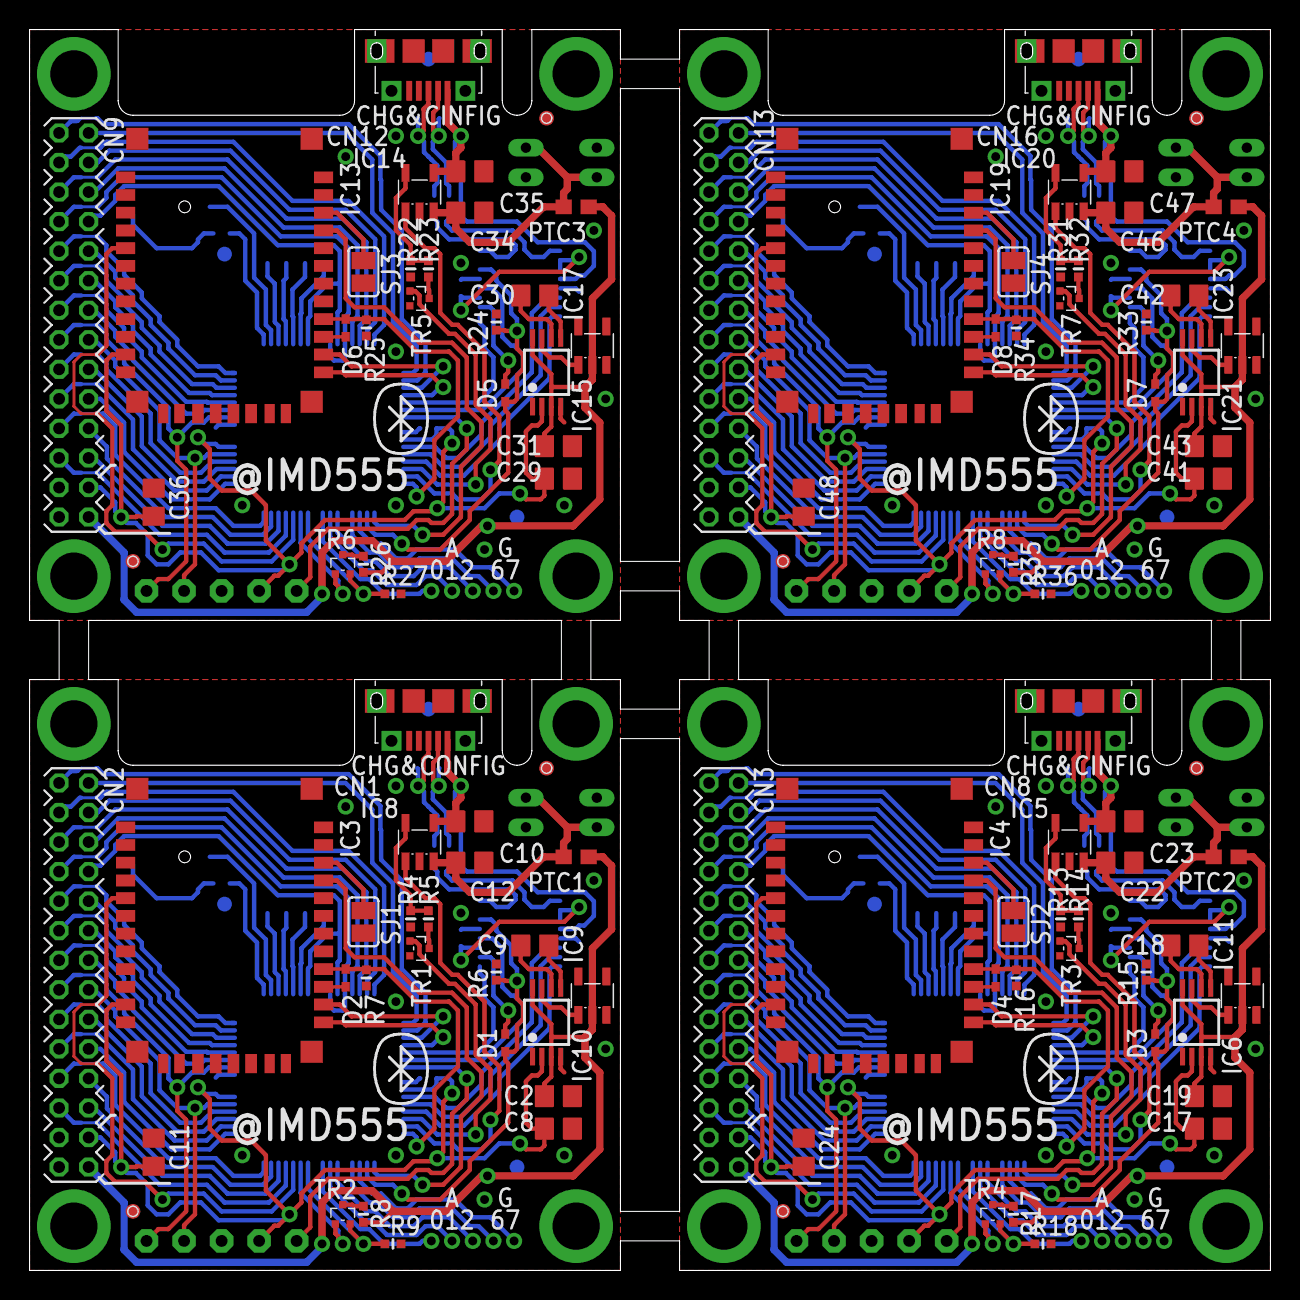
[picture p47: board Panelize.brd from above]

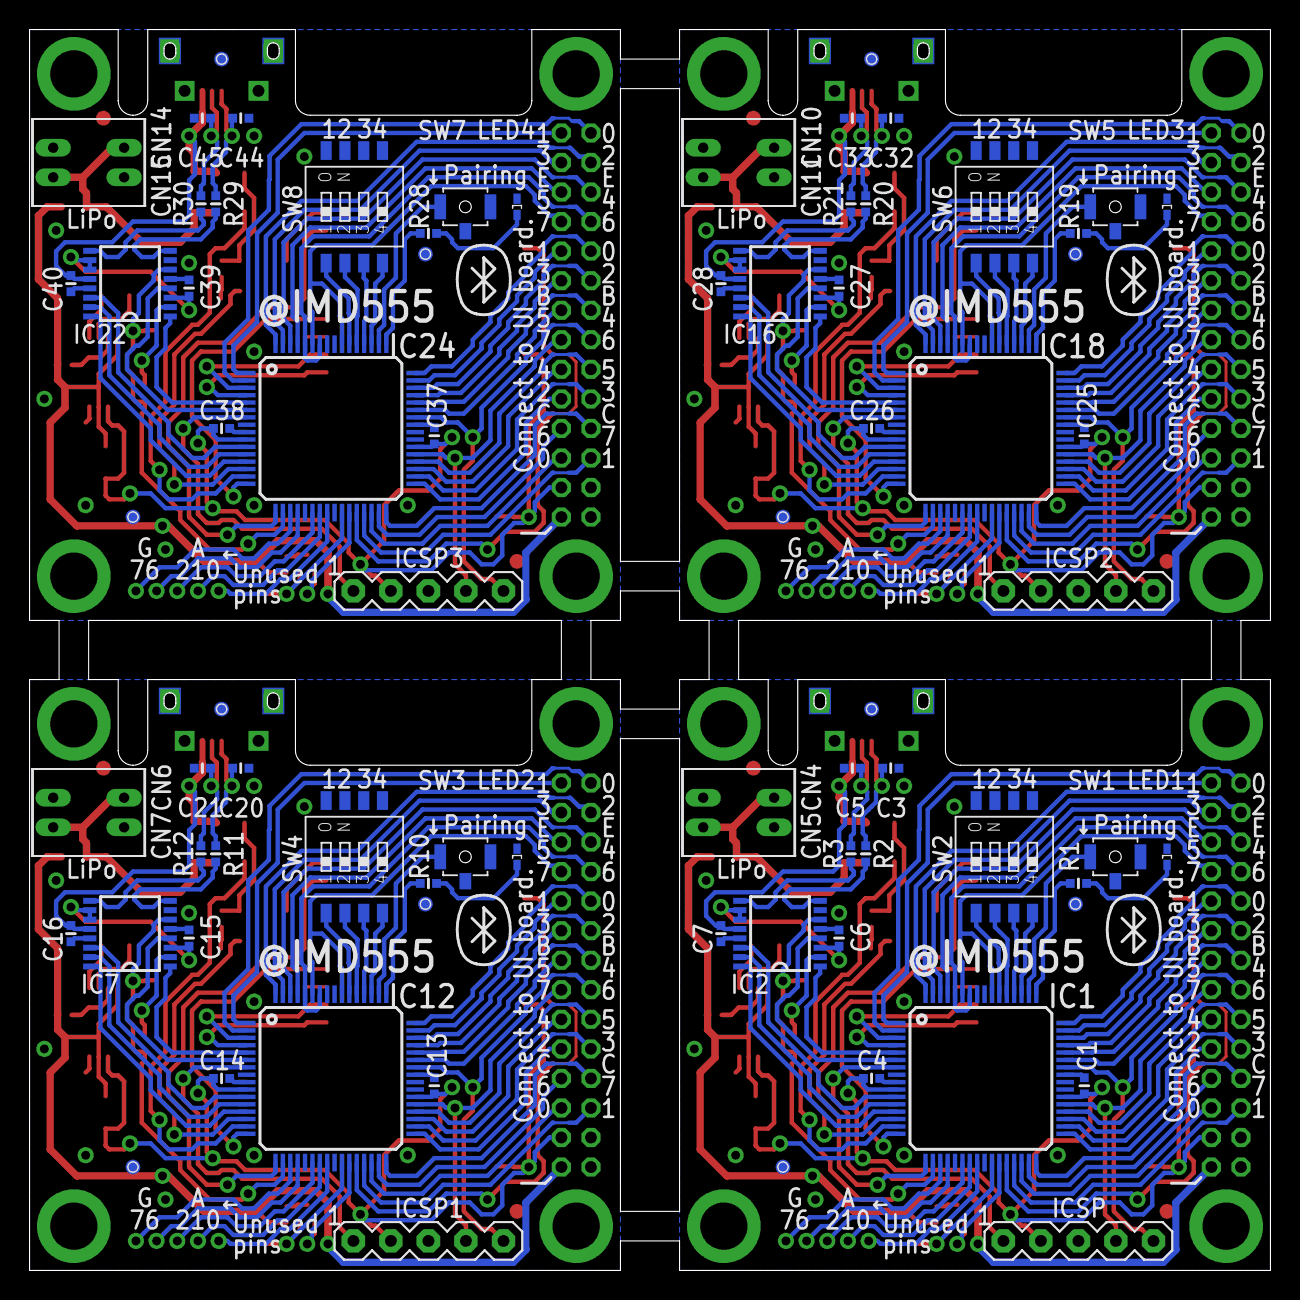
[picture p48: board Panelize.brd from below]

Board: 2 copper layers, 84.0 x 84.0 mm, 184 parts (80 on the bottom side), 264 nets.

Parts:
C1, C4, C6, C7, C13, C14, C15, C16, C25, C26, C27, C28, C37, C38, C39, C40: 0.1u; C0402-SS
C2, C8, C10, C11, C12, C17, C19, C22, C23, C24, C29, C31, C34, C35, C36, C41, C43, C46, C47, C48: 4.7u; C0805
C3, C5, C20, C21, C32, C33, C44, C45: 47p; C0402-SS
C9, C18, C30, C42: 1u; C0805
CN1, CN8, CN12, CN16: ZX62M-B-5P10118194-0001LF; 10118194-0001LF
CN2, CN3, CN9, CN13: 2X14; 2MM_14X2
CN4, CN5, CN6, CN7, CN10, CN11, CN14, CN15: PH-2_S
D1, D2, D3, D4, D5, D6, D7, D8: VMN2
IC1, IC12, IC18, IC24: PIC18F67K40; TQFP64-10X10
IC2, IC7, IC16, IC22: FT230X; SSOP16
IC3, IC4, IC13, IC19: RN42; RN-42
IC5, IC8, IC14, IC20: MCP73831; SOT23-5L
IC6, IC10, IC15, IC21: MCP1253-33X50; MSOP8
IC9, IC11, IC17, IC23: BD4931G; SOT23-5L
ICSP, ICSP1, ICSP2, ICSP3: MA05-1
LED1, LED2, LED3, LED4: White; CHIP-LED1005
PTC1, PTC2, PTC3, PTC4: 250mA 100mA 0ZCM0010FF2G; R0603
R1, R10, R19, R28: 100; R0402-SS
R2, R3, R11, R12, R20, R21, R29, R30: 27; R0402-SS
R4, R6, R7, R9, R13, R15, R16, R18, R22, R24, R25, R27, R31, R33, R34, R36: 10k; R0402-SS
R5, R14, R23, R32: 3.3k; R0402-SS
R8, R17, R26, R35: 33k; R0402-SS
SJ1, SJ2, SJ3, SJ4: SJ
SW1, SW3, SW5, SW7: B3U-1000P
SW2, SW4, SW6, SW8: CHS-04B
TR1, TR3, TR5, TR7: DMG1012T-7; SOT523
TR2, TR4, TR6, TR8: DMG1012T; SOT523
U$1, U$2, U$3, U$4, U$5, U$6, U$7, U$8, U$9, U$10, U$11, U$12, U$13, U$14, U$15, U$16, U$17, U$18, U$19, U$20: PCB_CHECK

Connections:
GND: C1.1, C2.2, C3.2, C4.1, C5.2, C6.2, C7.2, C8.2, C10.2, C11.2, C12.2, CN1.P$5, CN1.P$6, CN1.P$7, CN1.S1, CN1.S2, CN1.S3, CN1.S4, CN1.S5, CN1.S6, CN1.S7, CN1.S8, CN1.S9, CN1.S10, CN2.2, CN2.4, CN4.2, CN5.2, IC1.9, IC1.21, IC1.25, IC1.41, IC1.56, IC1.57, IC2.5, IC2.13, IC3.1, IC3.12, IC3.28, IC3.29, IC3.SHIELD, IC3.SHIELD@1, IC3.SHIELD@2, IC3.SHIELD@3, IC8.2, IC9.3, IC10.4, ICSP.3, LED1.C, R4.1, R6.1, R7.2, R9.1, SJ1.2, SW1.P$2, SW1.P$3, SW2.5, SW2.6, SW2.7, SW2.8, TR1.2
GND1: C13.1, C14.1, C15.2, C16.2, C17.2, C19.2, C20.2, C21.2, C22.2, C23.2, C24.2, CN3.2, CN3.4, CN6.2, CN7.2, CN8.P$5, CN8.P$6, CN8.P$7, CN8.S1, CN8.S2, CN8.S3, CN8.S4, CN8.S5, CN8.S6, CN8.S7, CN8.S8, CN8.S9, CN8.S10, IC4.1, IC4.12, IC4.28, IC4.29, IC4.SHIELD, IC4.SHIELD@1, IC4.SHIELD@2, IC4.SHIELD@3, IC5.2, IC6.4, IC7.5, IC7.13, IC11.3, IC12.9, IC12.21, IC12.25, IC12.41, IC12.56, IC12.57, ICSP1.3, LED2.C, R13.1, R15.1, R16.2, R18.1, SJ2.2, SW3.P$2, SW3.P$3, SW4.5, SW4.6, SW4.7, SW4.8, TR3.2
GND2: C25.1, C26.1, C27.2, C28.2, C29.2, C31.2, C32.2, C33.2, C34.2, C35.2, C36.2, CN9.2, CN9.4, CN10.2, CN11.2, CN12.P$5, CN12.P$6, CN12.P$7, CN12.S1, CN12.S2, CN12.S3, CN12.S4, CN12.S5, CN12.S6, CN12.S7, CN12.S8, CN12.S9, CN12.S10, IC13.1, IC13.12, IC13.28, IC13.29, IC13.SHIELD, IC13.SHIELD@1, IC13.SHIELD@2, IC13.SHIELD@3, IC14.2, IC15.4, IC16.5, IC16.13, IC17.3, IC18.9, IC18.21, IC18.25, IC18.41, IC18.56, IC18.57, ICSP2.3, LED3.C, R22.1, R24.1, R25.2, R27.1, SJ3.2, SW5.P$2, SW5.P$3, SW6.5, SW6.6, SW6.7, SW6.8, TR5.2
GND3: C37.1, C38.1, C39.2, C40.2, C41.2, C43.2, C44.2, C45.2, C46.2, C47.2, C48.2, CN13.2, CN13.4, CN14.2, CN15.2, CN16.P$5, CN16.P$6, CN16.P$7, CN16.S1, CN16.S2, CN16.S3, CN16.S4, CN16.S5, CN16.S6, CN16.S7, CN16.S8, CN16.S9, CN16.S10, IC19.1, IC19.12, IC19.28, IC19.29, IC19.SHIELD, IC19.SHIELD@1, IC19.SHIELD@2, IC19.SHIELD@3, IC20.2, IC21.4, IC22.5, IC22.13, IC23.3, IC24.9, IC24.21, IC24.25, IC24.41, IC24.56, IC24.57, ICSP3.3, LED4.C, R31.1, R33.1, R34.2, R36.1, SJ4.2, SW7.P$2, SW7.P$3, SW8.5, SW8.6, SW8.7, SW8.8, TR7.2
unnamed: IC1.4, IC3.13
unnamed: IC1.5, IC2.1
unnamed: IC1.3, IC3.14
unnamed: C16.1, C23.1, CN8.P$1, IC5.4, IC7.12
unnamed: C5.1, CN1.P$3, R2.2
unnamed: C3.1, CN1.P$2, R3.2
unnamed: IC1.6, IC2.4
unnamed: IC12.7, ICSP1.1
unnamed: C7.1, C10.1, CN1.P$1, IC2.12, IC8.4
unnamed: IC1.15, IC8.1
unnamed: IC4.14, IC12.3
unnamed: IC4.13, IC12.4
unnamed: IC7.4, IC12.6
unnamed: IC1.7, ICSP.1
unnamed: IC7.1, IC12.5
unnamed: C18.1, IC6.6
unnamed: C18.2, IC6.5
unnamed: IC12.52, SW4.3
unnamed: IC12.51, SW4.4
unnamed: IC12.50, SW3.P$1
unnamed: IC12.53, SW4.2
unnamed: IC12.54, SW4.1
unnamed: IC12.49, R10.1
unnamed: LED2.A, R10.2
unnamed: IC4.5, IC12.28
unnamed: IC7.9, R12.1
unnamed: IC7.8, R11.1
unnamed: C21.1, CN8.P$3, R11.2
unnamed: C20.1, CN8.P$2, R12.2
unnamed: IC7.15, IC12.12
unnamed: IC7.16, IC12.13
unnamed: IC5.5, R13.2, R14.2
unnamed: IC12.14, TR3.1
unnamed: IC1.54, SW2.1
unnamed: IC1.52, SW2.3
unnamed: C9.1, IC10.6
unnamed: C9.2, IC10.5
unnamed: IC1.51, SW2.4
unnamed: IC1.49, R1.1
unnamed: IC1.28, IC3.5
unnamed: LED1.A, R1.2
unnamed: C6.1, IC2.3, IC2.10, IC2.11
unnamed: IC1.50, SW1.P$1
unnamed: IC2.9, R3.1
unnamed: IC1.53, SW2.2
unnamed: IC2.8, R2.1
unnamed: C15.1, IC7.3, IC7.10, IC7.11
unnamed: IC1.12, IC2.15
unnamed: IC1.13, IC2.16
unnamed: IC8.5, R4.2, R5.2
unnamed: IC1.27, TR2.1
unnamed: D2.C, IC1.16, IC3.16, R7.1
unnamed: IC1.14, TR1.1
unnamed: D2.A, IC3.15
unnamed: IC1.11, IC2.14
unnamed: D1.A, IC2.2
unnamed: D1.C, IC1.18, IC2.6, R6.2
unnamed: IC1.17, IC3.21
unnamed: IC3.22, SJ1.1
unnamed: D4.A, IC4.15
unnamed: IC7.14, IC12.11
unnamed: D3.A, IC7.2
unnamed: D4.C, IC4.16, IC12.16, R16.1
unnamed: D3.C, IC7.6, IC12.18, R15.2
unnamed: IC4.22, SJ2.1
unnamed: IC4.21, IC12.17
unnamed: IC5.1, IC12.15
unnamed: IC12.27, TR4.1
unnamed: IC6.7, IC11.1
unnamed: IC9.1, IC10.7
unnamed: R5.1, TR1.3
unnamed: R8.1, TR2.3
unnamed: IC1.26, R9.2, TR2.2
unnamed: R14.1, TR3.3
unnamed: R17.1, TR4.3
unnamed: IC12.26, R18.2, TR4.2
unnamed: C28.1, C35.1, CN12.P$1, IC14.4, IC16.12
unnamed: IC18.7, ICSP2.1
unnamed: IC13.14, IC18.3
unnamed: IC13.13, IC18.4
unnamed: IC16.4, IC18.6
unnamed: IC16.1, IC18.5
unnamed: C30.1, IC15.6
unnamed: C30.2, IC15.5
unnamed: IC18.52, SW6.3
unnamed: IC18.51, SW6.4
unnamed: IC18.50, SW5.P$1
unnamed: IC18.53, SW6.2
unnamed: IC18.54, SW6.1
unnamed: IC18.49, R19.1
unnamed: LED3.A, R19.2
unnamed: IC13.5, IC18.28
unnamed: IC16.9, R21.1
unnamed: IC16.8, R20.1
unnamed: C33.1, CN12.P$3, R20.2
unnamed: C32.1, CN12.P$2, R21.2
unnamed: IC16.15, IC18.12
unnamed: IC16.16, IC18.13
unnamed: IC14.5, R22.2, R23.2
unnamed: IC18.14, TR5.1
unnamed: C27.1, IC16.3, IC16.10, IC16.11
unnamed: D6.A, IC13.15
unnamed: IC16.14, IC18.11
unnamed: D5.A, IC16.2
unnamed: D6.C, IC13.16, IC18.16, R25.1
unnamed: D5.C, IC16.6, IC18.18, R24.2
unnamed: IC13.22, SJ3.1
unnamed: IC13.21, IC18.17
unnamed: IC14.1, IC18.15
unnamed: IC18.27, TR6.1
unnamed: IC15.7, IC17.1
unnamed: R23.1, TR5.3
unnamed: R26.1, TR6.3
unnamed: IC18.26, R27.2, TR6.2
unnamed: C40.1, C47.1, CN16.P$1, IC20.4, IC22.12
unnamed: IC24.7, ICSP3.1
unnamed: IC19.14, IC24.3
unnamed: IC19.13, IC24.4
unnamed: IC22.4, IC24.6
unnamed: IC22.1, IC24.5
unnamed: C42.1, IC21.6
unnamed: C42.2, IC21.5
unnamed: IC24.52, SW8.3
unnamed: IC24.51, SW8.4
unnamed: IC24.50, SW7.P$1
unnamed: IC24.53, SW8.2
unnamed: IC24.54, SW8.1
unnamed: IC24.49, R28.1
unnamed: LED4.A, R28.2
unnamed: IC19.5, IC24.28
unnamed: IC22.9, R30.1
unnamed: IC22.8, R29.1
unnamed: C45.1, CN16.P$3, R29.2
unnamed: C44.1, CN16.P$2, R30.2
unnamed: IC22.15, IC24.12
unnamed: IC22.16, IC24.13
unnamed: IC20.5, R31.2, R32.2
unnamed: IC24.14, TR7.1
unnamed: C39.1, IC22.3, IC22.10, IC22.11
unnamed: D8.A, IC19.15
unnamed: IC22.14, IC24.11
unnamed: D7.A, IC22.2
unnamed: D8.C, IC19.16, IC24.16, R34.1
unnamed: D7.C, IC22.6, IC24.18, R33.2
unnamed: IC19.22, SJ4.1
unnamed: IC19.21, IC24.17
unnamed: IC20.1, IC24.15
unnamed: IC24.27, TR8.1
unnamed: IC21.7, IC23.1
unnamed: R32.1, TR7.3
unnamed: R35.1, TR8.3
unnamed: IC24.26, R36.2, TR8.2
RB0: CN2.20, IC1.48
RB1: CN2.19, IC1.47
RB2: CN2.18, IC1.46
RB3: CN2.17, IC1.45
RB4: CN2.16, IC1.44
RB5: CN2.15, IC1.43
RB6: CN2.14, IC1.42, ICSP.5
RB7: CN2.13, IC1.37, ICSP.4
RB8: CN3.20, IC12.48
RB9: CN3.19, IC12.47
RB10: CN3.18, IC12.46
RB11: CN3.17, IC12.45
RB12: CN3.16, IC12.44
RB13: CN3.15, IC12.43
RB14: CN3.14, IC12.42, ICSP1.5
RB15: CN3.13, IC12.37, ICSP1.4
RB16: CN9.20, IC18.48
RB17: CN9.19, IC18.47
RB18: CN9.18, IC18.46
RB19: CN9.17, IC18.45
RB20: CN9.16, IC18.44
RB21: CN9.15, IC18.43
RB22: CN9.14, IC18.42, ICSP2.5
RB23: CN9.13, IC18.37, ICSP2.4
RB24: CN13.20, IC24.48
RB25: CN13.19, IC24.47
RB26: CN13.18, IC24.46
RB27: CN13.17, IC24.45
RB28: CN13.16, IC24.44
RB29: CN13.15, IC24.43
RB30: CN13.14, IC24.42, ICSP3.5
RB31: CN13.13, IC24.37, ICSP3.4
RC0: CN2.5, IC1.30
RC1: CN2.6, IC1.29
RC2: CN2.9, IC1.33
RC3: CN2.10, IC1.34
RC4: CN2.11, IC1.35
RC5: CN2.12, IC1.36
RC6: CN2.7, IC1.31
RC7: CN2.8, IC1.32
RC8: CN3.12, IC12.36
RC9: CN3.11, IC12.35
RC10: CN3.10, IC12.34
RC11: CN3.9, IC12.33
RC12: CN3.8, IC12.32
RC13: CN3.7, IC12.31
RC14: CN3.5, IC12.30
RC15: CN3.6, IC12.29
RC16: CN9.12, IC18.36
RC17: CN9.11, IC18.35
RC18: CN9.10, IC18.34
RC19: CN9.9, IC18.33
RC20: CN9.8, IC18.32
RC21: CN9.7, IC18.31
RC22: CN9.5, IC18.30
RC23: CN9.6, IC18.29
RC24: CN13.12, IC24.36
RC25: CN13.11, IC24.35
RC26: CN13.10, IC24.34
RC27: CN13.9, IC24.33
RC28: CN13.8, IC24.32
RC29: CN13.7, IC24.31
RC30: CN13.5, IC24.30
RC31: CN13.6, IC24.29
RE0: CN2.28, IC1.2
RE1: CN2.27, IC1.1
RE2: CN2.26, IC1.64
RE3: CN2.25, IC1.63
RE4: CN2.24, IC1.62
RE5: CN2.23, IC1.61
RE6: CN2.22, IC1.58, IC1.60
RE7: CN2.21, IC1.55, IC1.59
RE8: CN3.21, IC12.55, IC12.59
RE9: CN3.22, IC12.58, IC12.60
RE10: CN3.23, IC12.61
RE11: CN3.24, IC12.62
RE12: CN3.25, IC12.63
RE13: CN3.26, IC12.64
RE14: CN3.27, IC12.1
RE15: CN3.28, IC12.2
RE16: CN9.21, IC18.55, IC18.59
RE17: CN9.22, IC18.58, IC18.60
RE18: CN9.23, IC18.61
RE19: CN9.24, IC18.62
RE20: CN9.25, IC18.63
RE21: CN9.26, IC18.64
RE22: CN9.27, IC18.1
RE23: CN9.28, IC18.2
RE24: CN13.21, IC24.55, IC24.59
RE25: CN13.22, IC24.58, IC24.60
RE26: CN13.23, IC24.61
RE27: CN13.24, IC24.62
RE28: CN13.25, IC24.63
RE29: CN13.26, IC24.64
RE30: CN13.27, IC24.1
RE31: CN13.28, IC24.2
VBAT: C12.1, CN4.1, CN5.1, IC8.3, PTC1.1
VBAT1: C19.1, CN3.1, IC6.3, IC6.8, IC11.2, PTC2.2, R17.2
VBAT2: C2.1, CN2.1, IC9.2, IC10.3, IC10.8, PTC1.2, R8.2
VBAT3: C22.1, CN6.1, CN7.1, IC5.3, PTC2.1
VBAT4: C31.1, CN9.1, IC15.3, IC15.8, IC17.2, PTC3.2, R26.2
VBAT5: C34.1, CN10.1, CN11.1, IC14.3, PTC3.1
VBAT6: C43.1, CN13.1, IC21.3, IC21.8, IC23.2, PTC4.2, R35.2
VBAT7: C46.1, CN14.1, CN15.1, IC20.3, PTC4.1
VDD: C1.2, C4.2, C8.1, C11.1, CN2.3, IC1.10, IC1.38, IC3.11, IC10.2, ICSP.2
VDD1: C13.2, C14.2, C17.1, C24.1, CN3.3, IC4.11, IC6.2, IC12.10, IC12.38, ICSP1.2
VDD2: C25.2, C26.2, C29.1, C36.1, CN9.3, IC13.11, IC15.2, IC18.10, IC18.38, ICSP2.2
VDD3: C37.2, C38.2, C41.1, C48.1, CN13.3, IC19.11, IC21.2, IC24.10, IC24.38, ICSP3.2
