IMD555/BTKB/PCB/v2/Main_board/Main_Board.brd

## EAGLE design PCB/v2/Main_board/Main_Board.brd (2021-03-14)

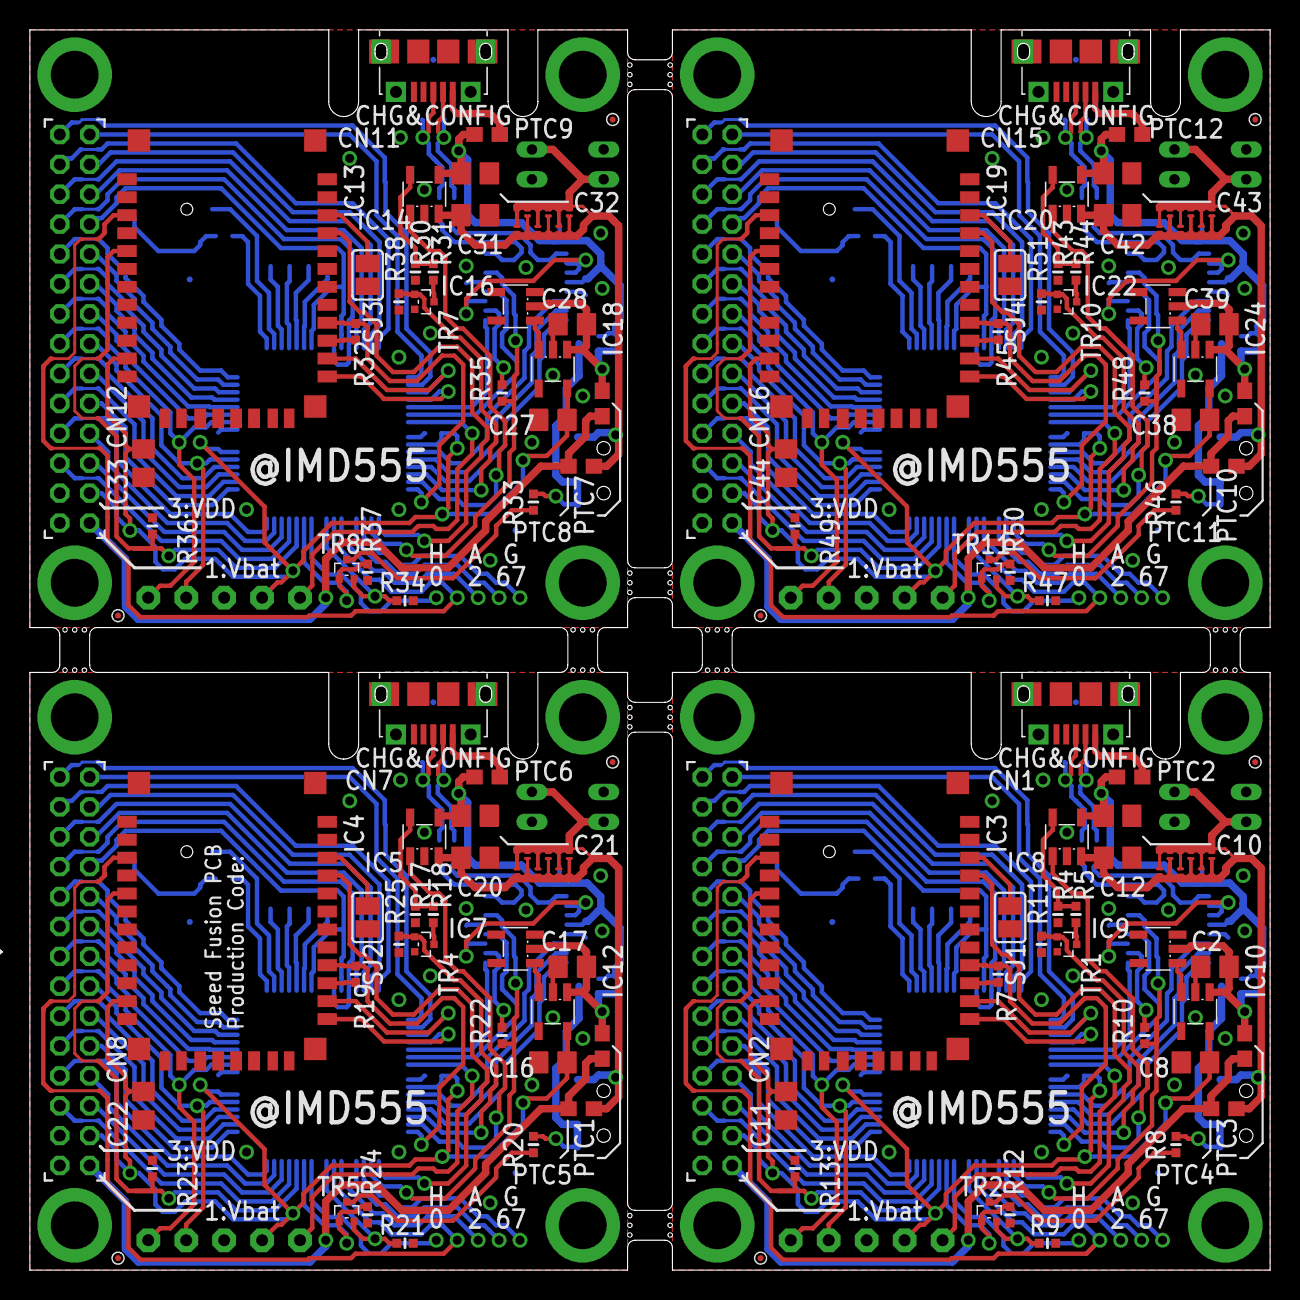
[picture p49: board Main_Board.brd from above]

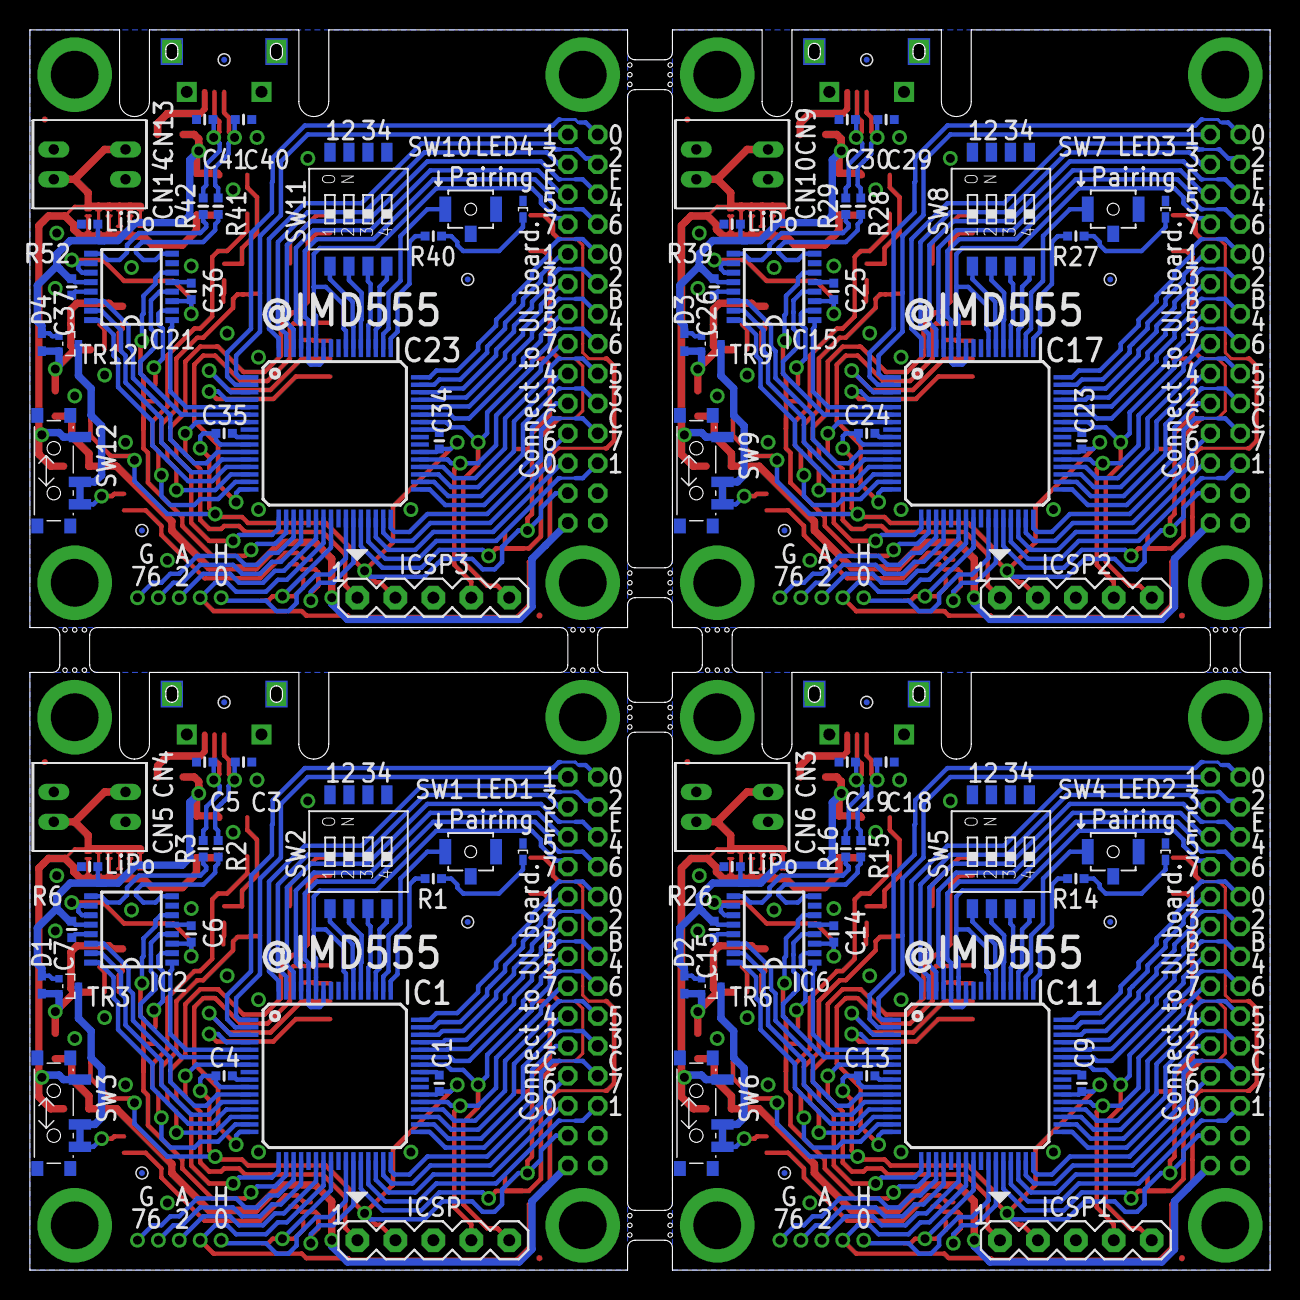
[picture p50: board Main_Board.brd from below]

Board: 2 copper layers, 83.0 x 83.0 mm, 232 parts (96 on the bottom side), 272 nets.

Parts:
C1, C4, C6, C7, C9, C13, C14, C15, C23, C24, C25, C26, C34, C35, C36, C37: 0.1u; C0402-SS
C2, C8, C10, C11, C12, C16, C17, C20, C21, C22, C27, C28, C31, C32, C33, C38, C39, C42, C43, C44: 4.7u; C0805
C3, C5, C18, C19, C29, C30, C40, C41: 47p; C0402-SS
CN1, CN7, CN11, CN15: microUSB; 10118194-0001LF
CN2, CN8, CN12, CN16: 2X14R; 2MM_14X2_R
CN3, CN4, CN5, CN6, CN9, CN10, CN13, CN14: PH-2_S
D1, D2, D3, D4: VMN2
F1, F2, F3, F4, F5, F6, F7, F8, F9, F10, F11, F12, F13, F14, F15, F16, F17, F18, F19, F20, F21, F22, F23, F24: FUSEPAT0.2; FUSE_PAT1
IC1, IC11, IC17, IC23: PIC18LF67K40; TQFP64-10X10
IC2, IC6, IC15, IC21: FT230X; SSOP16
IC3, IC4, IC13, IC19: RN42; RN-42
IC5, IC8, IC14, IC20: MCP73832; SOT23-5L
IC7, IC9, IC16, IC22: BD4931G; SOT23-5L
IC10, IC12, IC18, IC24: NCP551; SOT23-5L
ICSP, ICSP1, ICSP2, ICSP3: (Not mounting); MA05-1
LED1, LED2, LED3, LED4: Blue; CHIP-LED1005
PTC1, PTC2, PTC3, PTC4, PTC5, PTC6, PTC7, PTC8, PTC9, PTC10, PTC11, PTC12: 250mA 100mA 0ZCM0010FF2G; R0603
R1, R14, R27, R40: 1000 or 330; R0402-SS
R2, R3, R15, R16, R28, R29, R41, R42: 27; R0402-SS
R4, R7, R9, R10, R17, R19, R21, R22, R30, R32, R34, R35, R43, R45, R47, R48: 10k; R0402-SS
R5, R18, R31, R44: 3.3k; R0402-SS
R6, R8, R20, R26, R33, R39, R46, R52: 33k; R0402-SS
R11, R12, R13, R23, R24, R25, R36, R37, R38, R49, R50, R51: 100k; R0402-SS
SJ1, SJ2, SJ3, SJ4: (Don't short); SJ
SW1, SW4, SW7, SW10: B3U-1100P-B
SW2, SW5, SW8, SW11: CHS-04B
SW3, SW6, SW9, SW12: MA12R
TR1, TR2, TR4, TR5, TR7, TR8, TR10, TR11: DMG1012T-7; SOT523
TR3, TR6, TR9, TR12: PMOSSOT523; SOT523
U$1, U$2, U$3, U$4, U$5, U$6, U$7, U$8, U$9, U$10, U$11, U$12, U$13, U$14, U$15, U$16, U$17, U$18, U$19, U$20: PCB_CHECK

Connections:
GND: C1.1, C2.2, C3.2, C4.1, C5.2, C6.2, C7.2, C8.2, C10.2, C11.2, C12.2, CN1.P$5, CN1.P$6, CN1.P$7, CN1.S1, CN1.S2, CN1.S3, CN1.S4, CN1.S5, CN1.S6, CN1.S7, CN1.S8, CN1.S9, CN1.S10, CN2.2, CN2.4, CN4.2, CN5.2, IC1.8, IC1.9, IC1.21, IC1.25, IC1.39, IC1.40, IC1.41, IC1.56, IC1.57, IC2.5, IC2.13, IC3.1, IC3.12, IC3.28, IC3.29, IC3.SHIELD, IC3.SHIELD@1, IC3.SHIELD@2, IC3.SHIELD@3, IC8.2, IC9.3, IC10.2, ICSP.3, LED1.C, R4.1, R6.1, R9.1, R11.1, R12.1, R13.2, SJ1.2, SW1.P$2, SW1.P$3, SW2.5, SW2.6, SW2.7, SW2.8, SW3.P$4, SW3.P$5, SW3.P$6, SW3.P$7, TR1.2
GND1: C9.1, C13.1, C14.2, C15.2, C16.2, C17.2, C18.2, C19.2, C20.2, C21.2, C22.2, CN3.2, CN6.2, CN7.P$5, CN7.P$6, CN7.P$7, CN7.S1, CN7.S2, CN7.S3, CN7.S4, CN7.S5, CN7.S6, CN7.S7, CN7.S8, CN7.S9, CN7.S10, CN8.2, CN8.4, IC4.1, IC4.12, IC4.28, IC4.29, IC4.SHIELD, IC4.SHIELD@1, IC4.SHIELD@2, IC4.SHIELD@3, IC5.2, IC6.5, IC6.13, IC7.3, IC11.8, IC11.9, IC11.21, IC11.25, IC11.39, IC11.40, IC11.41, IC11.56, IC11.57, IC12.2, ICSP1.3, LED2.C, R17.1, R21.1, R23.2, R24.1, R25.1, R26.1, SJ2.2, SW4.P$2, SW4.P$3, SW5.5, SW5.6, SW5.7, SW5.8, SW6.P$4, SW6.P$5, SW6.P$6, SW6.P$7, TR4.2
GND2: C23.1, C24.1, C25.2, C26.2, C27.2, C28.2, C29.2, C30.2, C31.2, C32.2, C33.2, CN9.2, CN10.2, CN11.P$5, CN11.P$6, CN11.P$7, CN11.S1, CN11.S2, CN11.S3, CN11.S4, CN11.S5, CN11.S6, CN11.S7, CN11.S8, CN11.S9, CN11.S10, CN12.2, CN12.4, IC13.1, IC13.12, IC13.28, IC13.29, IC13.SHIELD, IC13.SHIELD@1, IC13.SHIELD@2, IC13.SHIELD@3, IC14.2, IC15.5, IC15.13, IC16.3, IC17.8, IC17.9, IC17.21, IC17.25, IC17.39, IC17.40, IC17.41, IC17.56, IC17.57, IC18.2, ICSP2.3, LED3.C, R30.1, R34.1, R36.2, R37.1, R38.1, R39.1, SJ3.2, SW7.P$2, SW7.P$3, SW8.5, SW8.6, SW8.7, SW8.8, SW9.P$4, SW9.P$5, SW9.P$6, SW9.P$7, TR7.2
GND3: C34.1, C35.1, C36.2, C37.2, C38.2, C39.2, C40.2, C41.2, C42.2, C43.2, C44.2, CN13.2, CN14.2, CN15.P$5, CN15.P$6, CN15.P$7, CN15.S1, CN15.S2, CN15.S3, CN15.S4, CN15.S5, CN15.S6, CN15.S7, CN15.S8, CN15.S9, CN15.S10, CN16.2, CN16.4, IC19.1, IC19.12, IC19.28, IC19.29, IC19.SHIELD, IC19.SHIELD@1, IC19.SHIELD@2, IC19.SHIELD@3, IC20.2, IC21.5, IC21.13, IC22.3, IC23.8, IC23.9, IC23.21, IC23.25, IC23.39, IC23.40, IC23.41, IC23.56, IC23.57, IC24.2, ICSP3.3, LED4.C, R43.1, R47.1, R49.2, R50.1, R51.1, R52.1, SJ4.2, SW10.P$2, SW10.P$3, SW11.5, SW11.6, SW11.7, SW11.8, SW12.P$4, SW12.P$5, SW12.P$6, SW12.P$7, TR10.2
unnamed: IC1.4, IC3.13
unnamed: IC1.5, IC2.1
unnamed: IC1.3, IC3.14
unnamed: C5.1, CN1.P$3, R2.2
unnamed: C3.1, CN1.P$2, R3.2
unnamed: IC1.6, IC2.4
unnamed: CN2.1, PTC3.2, PTC4.2
unnamed: C7.1, C10.1, D1.A, IC2.12, IC8.4, PTC2.2, R6.2, TR3.1
unnamed: IC1.15, IC8.1
unnamed: IC11.7, ICSP1.1
unnamed: C12.1, CN4.1, CN5.1, F1.P$1, F1.P$2, F2.P$1, F2.P$2, F3.P$1, F3.P$2, F4.P$1, F4.P$2, F5.P$1, F5.P$2, F6.P$1, F6.P$2, IC8.3, PTC4.1, SW3.P$1
unnamed: R8.2, SW3.P$2, SW3.P$3, TR3.3
unnamed: IC1.7, ICSP.1
unnamed: CN1.P$1, PTC2.1
unnamed: IC4.14, IC11.3
unnamed: IC4.13, IC11.4
unnamed: IC6.4, IC11.6
unnamed: IC6.1, IC11.5
unnamed: IC11.52, SW5.3
unnamed: IC11.51, SW5.4
unnamed: IC11.50, SW4.P$1
unnamed: IC11.53, SW5.2
unnamed: IC11.54, SW5.1
unnamed: IC11.49, R14.1
unnamed: LED2.A, R14.2
unnamed: IC4.5, IC11.28, R23.1
unnamed: IC6.9, R16.1
unnamed: IC6.8, R15.1
unnamed: C19.1, CN7.P$3, R15.2
unnamed: C18.1, CN7.P$2, R16.2
unnamed: IC6.15, IC11.12
unnamed: IC6.16, IC11.13
unnamed: IC1.54, SW2.1
unnamed: IC1.52, SW2.3
unnamed: IC5.5, R17.2, R18.2
unnamed: IC11.14, R25.2, TR4.1
unnamed: IC1.51, SW2.4
unnamed: IC1.49, R1.1
unnamed: IC1.28, IC3.5, R13.1
unnamed: LED1.A, R1.2
unnamed: C6.1, IC2.3, IC2.10, IC2.11
unnamed: IC1.50, SW1.P$1
unnamed: IC2.9, R3.1
unnamed: IC1.53, SW2.2
unnamed: IC2.8, R2.1
unnamed: C14.1, IC6.3, IC6.10, IC6.11
unnamed: IC1.12, IC2.15
unnamed: IC1.13, IC2.16
unnamed: IC8.5, R4.2, R5.2
unnamed: IC1.27, R12.2, TR2.1
unnamed: IC1.16, IC3.16, R7.1
unnamed: IC1.14, R11.2, TR1.1
unnamed: IC3.15, R7.2
unnamed: IC1.11, IC2.14
unnamed: IC2.2, R10.2
unnamed: IC1.18, IC2.6, R10.1
unnamed: IC1.17, IC3.21
unnamed: IC3.22, SJ1.1
unnamed: IC4.15, R19.2
unnamed: IC6.14, IC11.11
unnamed: IC6.2, R22.2
unnamed: IC4.16, IC11.16, R19.1
unnamed: IC6.6, IC11.18, R22.1
unnamed: IC4.22, SJ2.1
unnamed: IC4.21, IC11.17
unnamed: IC5.1, IC11.15
unnamed: IC11.27, R24.2, TR5.1
unnamed: IC7.1, IC12.3
unnamed: IC9.1, IC10.3
unnamed: R5.1, TR1.3
unnamed: R8.1, TR2.3
unnamed: IC1.24, R9.2, TR2.2
unnamed: R18.1, TR4.3
unnamed: R20.1, TR5.3
unnamed: IC4.3, IC11.23
unnamed: IC11.24, R21.2, TR5.2
unnamed: CN8.1, PTC1.2, PTC5.2
unnamed: C20.1, CN3.1, CN6.1, F7.P$1, F7.P$2, F8.P$1, F8.P$2, F9.P$1, F9.P$2, F10.P$1, F10.P$2, F11.P$1, F11.P$2, F12.P$1, F12.P$2, IC5.3, PTC5.1, SW6.P$1
unnamed: C15.1, C21.1, D2.A, IC5.4, IC6.12, PTC6.2, R26.2, TR6.1
unnamed: R20.2, SW6.P$2, SW6.P$3, TR6.3
unnamed: CN7.P$1, PTC6.1
unnamed: IC17.7, ICSP2.1
unnamed: IC13.14, IC17.3
unnamed: IC13.13, IC17.4
unnamed: IC15.4, IC17.6
unnamed: IC15.1, IC17.5
unnamed: IC17.52, SW8.3
unnamed: IC1.23, IC3.3
unnamed: IC17.51, SW8.4
unnamed: IC17.50, SW7.P$1
unnamed: IC17.53, SW8.2
unnamed: IC17.54, SW8.1
unnamed: IC17.49, R27.1
unnamed: LED3.A, R27.2
unnamed: IC13.5, IC17.28, R36.1
unnamed: IC15.9, R29.1
unnamed: IC15.8, R28.1
unnamed: C30.1, CN11.P$3, R28.2
unnamed: C29.1, CN11.P$2, R29.2
unnamed: IC15.15, IC17.12
unnamed: IC15.16, IC17.13
unnamed: IC14.5, R30.2, R31.2
unnamed: IC17.14, R38.2, TR7.1
unnamed: C25.1, IC15.3, IC15.10, IC15.11
unnamed: IC13.15, R32.2
unnamed: IC15.14, IC17.11
unnamed: IC15.2, R35.2
unnamed: IC13.16, IC17.16, R32.1
unnamed: IC15.6, IC17.18, R35.1
unnamed: IC13.22, SJ3.1
unnamed: IC13.21, IC17.17
unnamed: IC14.1, IC17.15
unnamed: IC17.27, R37.2, TR8.1
unnamed: IC16.1, IC18.3
unnamed: R31.1, TR7.3
unnamed: R33.1, TR8.3
unnamed: IC13.3, IC17.23
unnamed: IC17.24, R34.2, TR8.2
unnamed: CN12.1, PTC7.2, PTC8.2
unnamed: C31.1, CN9.1, CN10.1, F13.P$1, F13.P$2, F14.P$1, F14.P$2, F15.P$1, F15.P$2, F16.P$1, F16.P$2, F17.P$1, F17.P$2, F18.P$1, F18.P$2, IC14.3, PTC8.1, SW9.P$1
unnamed: C26.1, C32.1, D3.A, IC14.4, IC15.12, PTC9.2, R39.2, TR9.1
unnamed: R33.2, SW9.P$2, SW9.P$3, TR9.3
unnamed: CN11.P$1, PTC9.1
unnamed: IC23.7, ICSP3.1
unnamed: IC19.14, IC23.3
unnamed: IC19.13, IC23.4
unnamed: IC21.4, IC23.6
unnamed: IC21.1, IC23.5
unnamed: IC23.52, SW11.3
unnamed: IC23.51, SW11.4
unnamed: IC23.50, SW10.P$1
unnamed: IC23.53, SW11.2
unnamed: IC23.54, SW11.1
unnamed: IC23.49, R40.1
unnamed: LED4.A, R40.2
unnamed: IC19.5, IC23.28, R49.1
unnamed: IC21.9, R42.1
unnamed: IC21.8, R41.1
unnamed: C41.1, CN15.P$3, R41.2
unnamed: C40.1, CN15.P$2, R42.2
unnamed: IC21.15, IC23.12
unnamed: IC21.16, IC23.13
unnamed: IC20.5, R43.2, R44.2
unnamed: IC23.14, R51.2, TR10.1
unnamed: C36.1, IC21.3, IC21.10, IC21.11
unnamed: IC19.15, R45.2
unnamed: IC21.14, IC23.11
unnamed: IC21.2, R48.2
unnamed: IC19.16, IC23.16, R45.1
unnamed: IC21.6, IC23.18, R48.1
unnamed: IC19.22, SJ4.1
unnamed: IC19.21, IC23.17
unnamed: IC20.1, IC23.15
unnamed: IC23.27, R50.2, TR11.1
unnamed: IC22.1, IC24.3
unnamed: R44.1, TR10.3
unnamed: R46.1, TR11.3
unnamed: IC19.3, IC23.23
unnamed: IC23.24, R47.2, TR11.2
unnamed: CN16.1, PTC10.2, PTC11.2
unnamed: C42.1, CN13.1, CN14.1, F19.P$1, F19.P$2, F20.P$1, F20.P$2, F21.P$1, F21.P$2, F22.P$1, F22.P$2, F23.P$1, F23.P$2, F24.P$1, F24.P$2, IC20.3, PTC11.1, SW12.P$1
unnamed: C37.1, C43.1, D4.A, IC20.4, IC21.12, PTC12.2, R52.2, TR12.1
unnamed: R46.2, SW12.P$2, SW12.P$3, TR12.3
unnamed: CN15.P$1, PTC12.1
RB0: CN2.20, IC1.48
RB1: CN2.19, IC1.47
RB2: CN2.18, IC1.46
RB3: CN2.17, IC1.45
RB4: CN2.16, IC1.44
RB5: CN2.15, IC1.43
RB6: CN2.14, IC1.42, ICSP.5
RB7: CN2.13, IC1.37, ICSP.4
RB8: CN8.20, IC11.48
RB9: CN8.19, IC11.47
RB10: CN8.18, IC11.46
RB11: CN8.17, IC11.45
RB12: CN8.16, IC11.44
RB13: CN8.15, IC11.43
RB14: CN8.14, IC11.42, ICSP1.5
RB15: CN8.13, IC11.37, ICSP1.4
RB16: CN12.20, IC17.48
RB17: CN12.19, IC17.47
RB18: CN12.18, IC17.46
RB19: CN12.17, IC17.45
RB20: CN12.16, IC17.44
RB21: CN12.15, IC17.43
RB22: CN12.14, IC17.42, ICSP2.5
RB23: CN12.13, IC17.37, ICSP2.4
RB24: CN16.20, IC23.48
RB25: CN16.19, IC23.47
RB26: CN16.18, IC23.46
RB27: CN16.17, IC23.45
RB28: CN16.16, IC23.44
RB29: CN16.15, IC23.43
RB30: CN16.14, IC23.42, ICSP3.5
RB31: CN16.13, IC23.37, ICSP3.4
RC0: CN2.5, IC1.30
RC1: CN2.6, IC1.29
RC2: CN2.9, IC1.33
RC3: CN2.10, IC1.34
RC4: CN2.11, IC1.35
RC5: CN2.12, IC1.36
RC6: CN2.7, IC1.31
RC7: CN2.8, IC1.32
RC8: CN8.12, IC11.36
RC9: CN8.11, IC11.35
RC10: CN8.10, IC11.34
RC11: CN8.9, IC11.33
RC12: CN8.8, IC11.32
RC13: CN8.7, IC11.31
RC14: CN8.5, IC11.30
RC15: CN8.6, IC11.29
RC16: CN12.12, IC17.36
RC17: CN12.11, IC17.35
RC18: CN12.10, IC17.34
RC19: CN12.9, IC17.33
RC20: CN12.8, IC17.32
RC21: CN12.7, IC17.31
RC22: CN12.5, IC17.30
RC23: CN12.6, IC17.29
RC24: CN16.12, IC23.36
RC25: CN16.11, IC23.35
RC26: CN16.10, IC23.34
RC27: CN16.9, IC23.33
RC28: CN16.8, IC23.32
RC29: CN16.7, IC23.31
RC30: CN16.5, IC23.30
RC31: CN16.6, IC23.29
RE0: CN2.28, IC1.2
RE1: CN2.27, IC1.1
RE2: CN2.26, IC1.64
RE3: CN2.25, IC1.63
RE4: CN2.24, IC1.62
RE5: CN2.23, IC1.61
RE6: CN2.22, IC1.58, IC1.60
RE7: CN2.21, IC1.55, IC1.59
RE8: CN8.21, IC11.55, IC11.59
RE9: CN8.22, IC11.58, IC11.60
RE10: CN8.23, IC11.61
RE11: CN8.24, IC11.62
RE12: CN8.25, IC11.63
RE13: CN8.26, IC11.64
RE14: CN8.27, IC11.1
RE15: CN8.28, IC11.2
RE16: CN12.21, IC17.55, IC17.59
RE17: CN12.22, IC17.58, IC17.60
RE18: CN12.23, IC17.61
RE19: CN12.24, IC17.62
RE20: CN12.25, IC17.63
RE21: CN12.26, IC17.64
RE22: CN12.27, IC17.1
RE23: CN12.28, IC17.2
RE24: CN16.21, IC23.55, IC23.59
RE25: CN16.22, IC23.58, IC23.60
RE26: CN16.23, IC23.61
RE27: CN16.24, IC23.62
RE28: CN16.25, IC23.63
RE29: CN16.26, IC23.64
RE30: CN16.27, IC23.1
RE31: CN16.28, IC23.2
VBAT: C2.1, D1.C, IC9.2, IC10.1, PTC3.1, TR3.2
VBAT1: C17.1, D2.C, IC7.2, IC12.1, PTC1.1, TR6.2
VBAT2: C28.1, D3.C, IC16.2, IC18.1, PTC7.1, TR9.2
VBAT3: C39.1, D4.C, IC22.2, IC24.1, PTC10.1, TR12.2
VDD: C1.2, C4.2, C8.1, C11.1, CN2.3, IC1.10, IC1.38, IC3.11, IC10.5, ICSP.2
VDD1: C9.2, C13.2, C16.1, C22.1, CN8.3, IC4.11, IC11.10, IC11.38, IC12.5, ICSP1.2
VDD2: C23.2, C24.2, C27.1, C33.1, CN12.3, IC13.11, IC17.10, IC17.38, IC18.5, ICSP2.2
VDD3: C34.2, C35.2, C38.1, C44.1, CN16.3, IC19.11, IC23.10, IC23.38, IC24.5, ICSP3.2
