IMD555/BTKB/PCB/v2/REMOTE_CONTROL/REMOTE_CONTROL.brd

## EAGLE design PCB/v2/REMOTE_CONTROL/REMOTE_CONTROL.brd (2021-03-14)

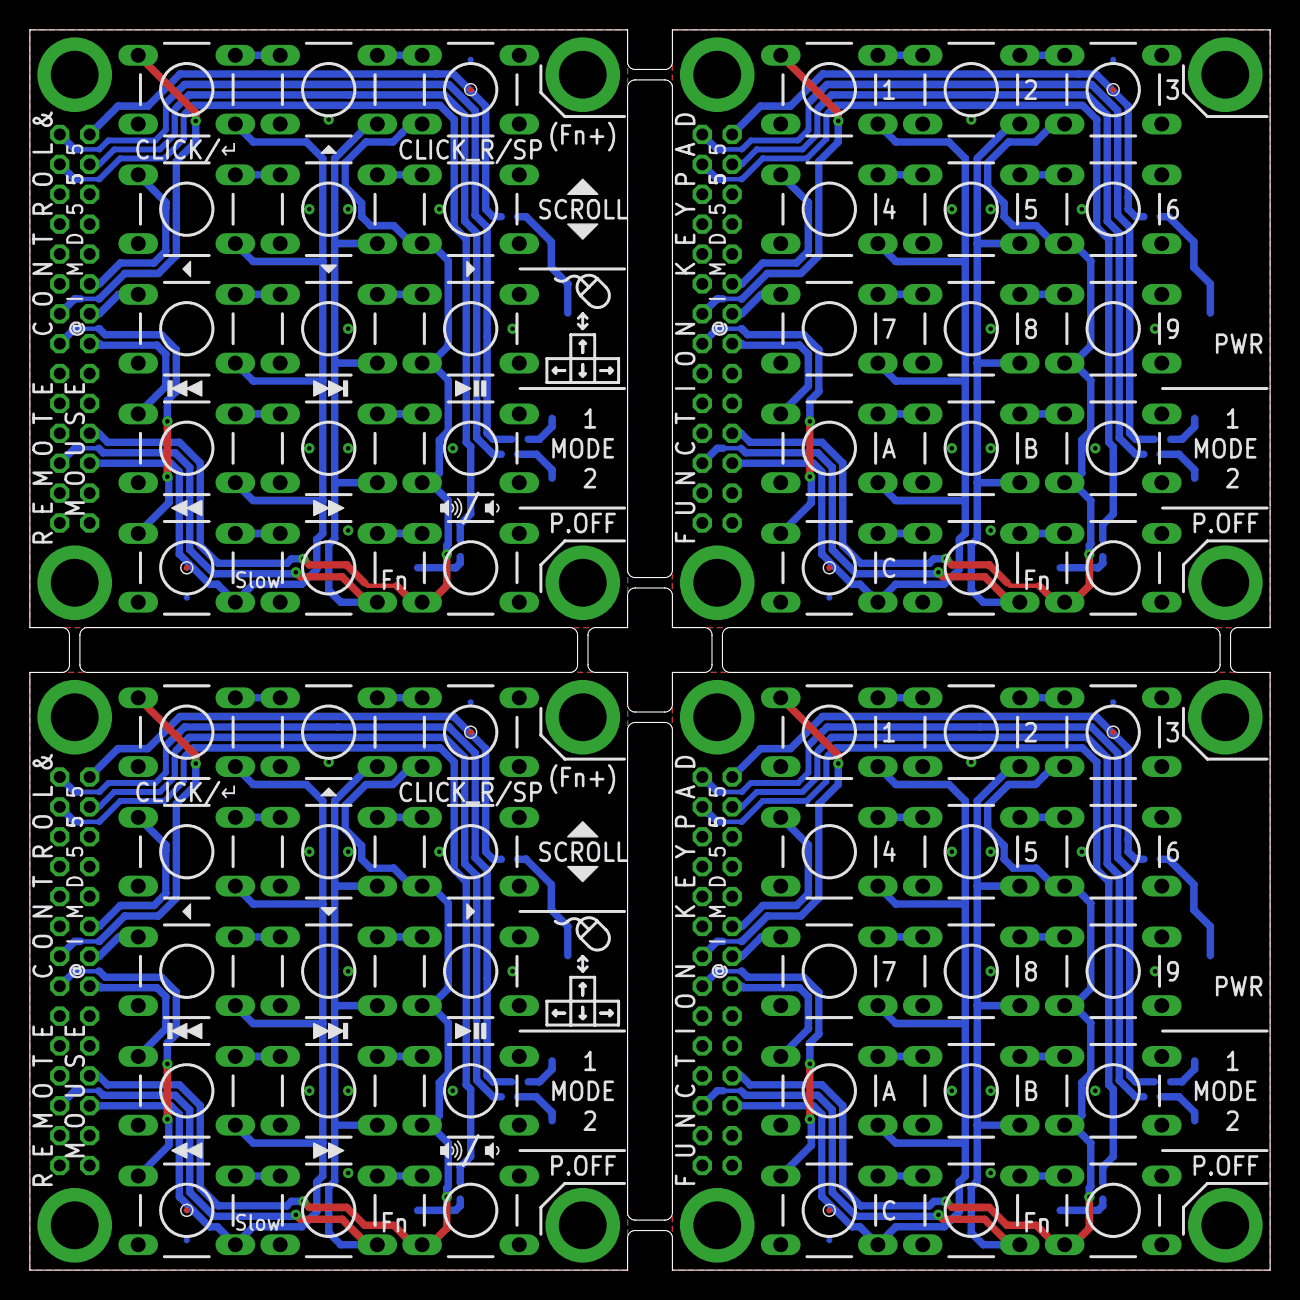
[picture p51: board REMOTE_CONTROL.brd from above]

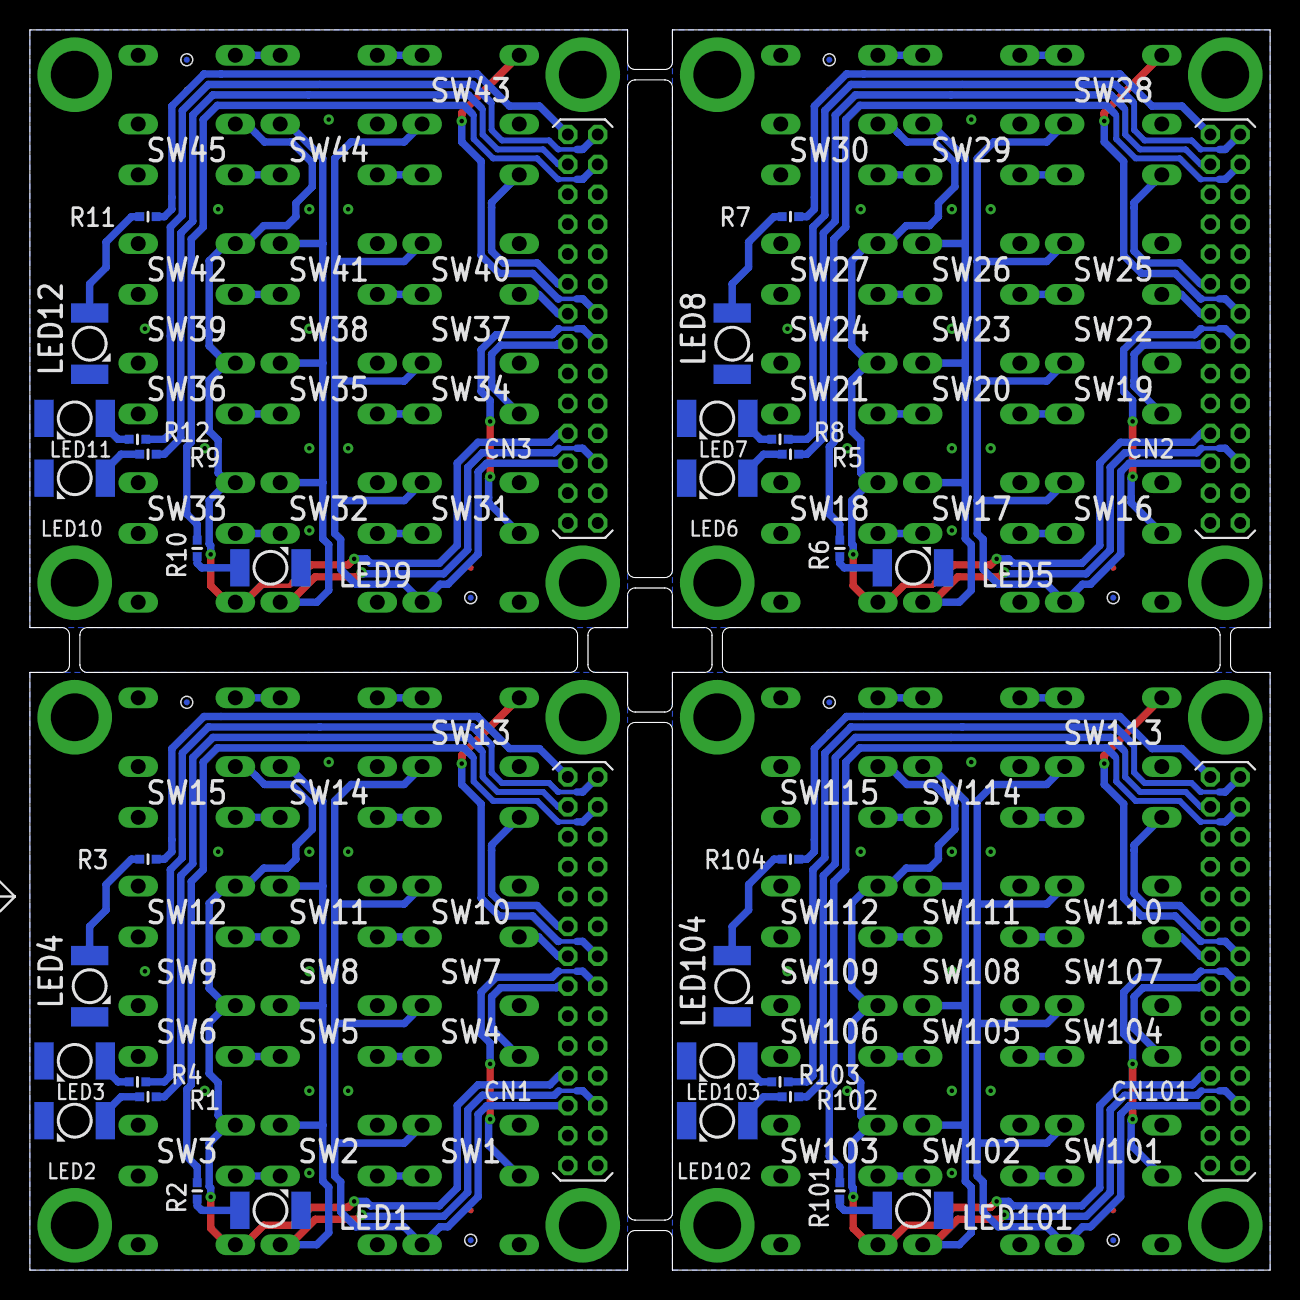
[picture p52: board REMOTE_CONTROL.brd from below]

Board: 2 copper layers, 83.0 x 83.0 mm, 112 parts (44 on the bottom side), 108 nets.

Parts:
CN1, CN2, CN3, CN101: 14X2R; 2MM_14X2_R
LED1, LED2, LED3, LED4, LED5, LED6, LED7, LED8, LED9, LED10, LED11, LED12, LED101, LED102, LED103, LED104: P-LCC-2-TOPLED-RG
R1, R2, R3, R4, R5, R6, R7, R8, R9, R10, R11, R12, R101, R102, R103, R104: R0402-SS
SW1, SW2, SW3, SW4, SW5, SW6, SW7, SW8, SW9, SW10, SW11, SW12, SW13, SW14, SW15, SW16, SW17, SW18, SW19, SW20, SW21, SW22, SW23, SW24, SW25, SW26, SW27, SW28, SW29, SW30, SW31, SW32, SW33, SW34, SW35, SW36, SW37, SW38, SW39, SW40, SW41, SW42, SW43, SW44, SW45, SW101, SW102, SW103, SW104, SW105, SW106, SW107, SW108, SW109, SW110, SW111, SW112, SW113, SW114, SW115: DTS-6
U$1, U$2, U$3, U$4, U$5, U$6, U$7, U$8, U$9, U$10, U$11, U$12, U$13, U$14, U$15, U$16: PCB_CHECK

Connections:
C0: CN101.13, SW104.1
C1: CN101.14, SW101.1
C2: CN101.15, SW107.1
C3: CN101.16, SW113.1
C4: CN101.17, SW110.1
C12: CN1.13, SW4.1
C13: CN1.14, SW1.1
C14: CN1.15, SW7.1
C15: CN1.16, SW13.1
C16: CN1.17, SW10.1
C24: CN2.13, SW19.1
C25: CN2.14, SW16.1
C26: CN2.15, SW22.1
C27: CN2.16, SW28.1
C28: CN2.17, SW25.1
C36: CN3.13, SW34.1
C37: CN3.14, SW31.1
C38: CN3.15, SW37.1
C39: CN3.16, SW43.1
C40: CN3.17, SW40.1
GND: CN101.2, CN101.4, LED101.C, LED102.C, LED103.C, LED104.C
GND1: CN1.2, CN1.4, LED1.C, LED2.C, LED3.C, LED4.C
GND2: CN2.2, CN2.4, LED5.C, LED6.C, LED7.C, LED8.C
GND3: CN3.2, CN3.4, LED9.C, LED10.C, LED11.C, LED12.C
L0: CN101.25, R102.2
L1: CN101.26, R101.2
L2: CN101.27, R104.2
L3: CN101.28, R103.2
L4: CN1.26, R2.2
L5: CN1.28, R4.2
L6: CN1.25, R1.2
L7: CN1.27, R3.2
L8: CN2.26, R6.2
L9: CN2.28, R8.2
L10: CN2.25, R5.2
L11: CN2.27, R7.2
L12: CN3.26, R10.2
L13: CN3.28, R12.2
L14: CN3.25, R9.2
L15: CN3.27, R11.2
unnamed: LED104.A, R104.1
unnamed: SW114.2, SW115.1
unnamed: LED103.A, R103.1
unnamed: SW111.2, SW112.1
unnamed: SW108.2, SW109.1
unnamed: LED102.A, R102.1
unnamed: LED101.A, R101.1
unnamed: SW102.2, SW103.1
unnamed: SW105.2, SW106.1
unnamed: SW14.2, SW15.1
unnamed: SW110.2, SW111.1
unnamed: SW107.2, SW108.1
unnamed: SW104.2, SW105.1
unnamed: SW101.2, SW102.1
unnamed: SW113.2, SW114.1
unnamed: SW11.2, SW12.1
unnamed: SW8.2, SW9.1
unnamed: SW2.2, SW3.1
unnamed: SW5.2, SW6.1
unnamed: SW10.2, SW11.1
unnamed: SW7.2, SW8.1
unnamed: SW4.2, SW5.1
unnamed: SW1.2, SW2.1
unnamed: SW13.2, SW14.1
unnamed: LED4.A, R3.1
unnamed: LED3.A, R4.1
unnamed: LED2.A, R1.1
unnamed: LED1.A, R2.1
unnamed: SW29.2, SW30.1
unnamed: SW26.2, SW27.1
unnamed: SW23.2, SW24.1
unnamed: SW17.2, SW18.1
unnamed: SW20.2, SW21.1
unnamed: SW25.2, SW26.1
unnamed: SW22.2, SW23.1
unnamed: SW19.2, SW20.1
unnamed: SW16.2, SW17.1
unnamed: SW28.2, SW29.1
unnamed: LED8.A, R7.1
unnamed: LED7.A, R8.1
unnamed: LED6.A, R5.1
unnamed: LED5.A, R6.1
unnamed: SW44.2, SW45.1
unnamed: SW41.2, SW42.1
unnamed: SW38.2, SW39.1
unnamed: SW32.2, SW33.1
unnamed: SW35.2, SW36.1
unnamed: SW40.2, SW41.1
unnamed: SW37.2, SW38.1
unnamed: SW34.2, SW35.1
unnamed: SW31.2, SW32.1
unnamed: SW43.2, SW44.1
unnamed: LED12.A, R11.1
unnamed: LED11.A, R12.1
unnamed: LED10.A, R9.1
unnamed: LED9.A, R10.1
R0: CN101.5, SW101.4, SW104.4, SW107.4, SW110.4, SW113.4
R1: CN101.6, SW102.4, SW105.4, SW108.4, SW111.4, SW114.4
R2: CN101.7, SW103.3, SW106.3, SW109.3, SW112.3, SW115.3
R6: CN1.5, SW1.4, SW4.4, SW7.4, SW10.4, SW13.4
R7: CN1.6, SW2.4, SW5.4, SW8.4, SW11.4, SW14.4
R8: CN1.7, SW3.3, SW6.3, SW9.3, SW12.3, SW15.3
R12: CN2.5, SW16.4, SW19.4, SW22.4, SW25.4, SW28.4
R13: CN2.6, SW17.4, SW20.4, SW23.4, SW26.4, SW29.4
R14: CN2.7, SW18.3, SW21.3, SW24.3, SW27.3, SW30.3
R18: CN3.5, SW31.4, SW34.4, SW37.4, SW40.4, SW43.4
R19: CN3.6, SW32.4, SW35.4, SW38.4, SW41.4, SW44.4
R20: CN3.7, SW33.3, SW36.3, SW39.3, SW42.3, SW45.3
