IMD555/BTKB/Software/BTKB.X/configuration_bits.c

    #include <xc.h>         /* XC8 General Include File */


//These configuration bits are ignored.
//Configuration bits are specified in bootloader.

// CONFIG1L
#pragma config FEXTOSC = OFF    // External Oscillator mode Selection bits (Oscillator not enabled)
#pragma config RSTOSC = HFINTOSC_1MHZ// Power-up default value for COSC bits (HFINTOSC with HFFRQ = 4 MHz and CDIV = 4:1)

// CONFIG1H
#pragma config CLKOUTEN = OFF   // Clock Out Enable bit (CLKOUT function is disabled)
#pragma config CSWEN = ON       // Clock Switch Enable bit (Writing to NOSC and NDIV is allowed)
#pragma config FCMEN = OFF       // Fail-Safe Clock Monitor Enable bit (Fail-Safe Clock Monitor disabled)

// CONFIG2L
#pragma config MCLRE = INTMCLR  // Master Clear Enable bit (If LVP = 0, MCLR pin function is port defined function; If LVP =1, RG5 pin fuction is MCLR)
#pragma config PWRTE = OFF       // Power-up Timer Enable bit (Power up timer disabled)
#pragma config LPBOREN = ON     // Low-power BOR enable bit (ULPBOR enabled)
#pragma config BOREN = OFF      // Brown-out Reset Enable bits (Brown-out Reset disabled)

// CONFIG2H
#pragma config BORV = VBOR_285  // Brown Out Reset Voltage selection bits (Brown-out Reset Voltage (VBOR) set to 2.85V)
#pragma config ZCD = OFF        // ZCD Disable bit (ZCD disabled. ZCD can be enabled by setting the ZCDSEN bit of ZCDCON)
#pragma config PPS1WAY = OFF     // PPSLOCK bit One-Way Set Enable bit (PPSLOCK bit can be cleared and set only once; PPS registers remain locked after one clear/set cycle)
#pragma config STVREN = ON      // Stack Full/Underflow Reset Enable bit (Stack full/underflow will cause Reset)
#pragma config DEBUG = OFF      // Debugger Enable bit (Background debugger disabled)
#pragma config XINST = OFF      // Extended Instruction Set Enable bit (Extended Instruction Set and Indexed Addressing Mode disabled)

// CONFIG3L
#pragma config WDTCPS = WDTCPS_31// WDT Period Select bits (Divider ratio 1:65536; software control of WDTPS)
#pragma config WDTE = OFF       // WDT operating mode (WDT Disabled)

// CONFIG3H
#pragma config WDTCWS = WDTCWS_7// WDT Window Select bits (window always open (100%); software control; keyed access not required)
#pragma config WDTCCS = SC      // WDT input clock selector (Software Control)

// CONFIG4L
#pragma config WRT0 = OFF       // Write Protection Block 0 (Block 0 (000800-003FFFh) not write-protected)
#pragma config WRT1 = OFF       // Write Protection Block 1 (Block 1 (004000-007FFFh) not write-protected)
#pragma config WRT2 = OFF       // Write Protection Block 2 (Block 2 (008000-00BFFFh) not write-protected)
#pragma config WRT3 = OFF       // Write Protection Block 3 (Block 3 (00C000-00FFFFh) not write-protected)
#pragma config WRT4 = OFF       // Write Protection Block 3 (Block 4 (010000-013FFFh) not write-protected)
#pragma config WRT5 = OFF       // Write Protection Block 3 (Block 5 (014000-017FFFh) not write-protected)
#pragma config WRT6 = OFF       // Write Protection Block 3 (Block 6 (018000-01BFFFh) not write-protected)
#pragma config WRT7 = OFF       // Write Protection Block 3 (Block 7 (01C000-01FFFFh) not write-protected)

// CONFIG4H
#pragma config WRTC = ON        // Configuration Register Write Protection bit (Configuration registers (300000-30000Bh) write-protected)
#pragma config WRTB = ON        // Boot Block Write Protection bit (Boot Block (000000-0007FFh) write-protected)
#pragma config WRTD = OFF       // Data EEPROM Write Protection bit (Data EEPROM not write-protected)
#pragma config SCANE = OFF      // Scanner Enable bit (Scanner module is NOT available for use, SCANMD bit is ignored)
#pragma config LVP = OFF        // Low Voltage Programming Enable bit (HV on MCLR/VPP must be used for programming)

// CONFIG5L
#pragma config CP = OFF         // UserNVM Program Memory Code Protection bit (UserNVM code protection disabled)
#pragma config CPD = OFF        // DataNVM Memory Code Protection bit (DataNVM code protection disabled)

// CONFIG5H

// CONFIG6L
#pragma config EBTR0 = OFF      // Table Read Protection Block 0 (Block 0 (000800-003FFFh) not protected from table reads executed in other blocks)
#pragma config EBTR1 = OFF      // Table Read Protection Block 1 (Block 1 (004000-007FFFh) not protected from table reads executed in other blocks)
#pragma config EBTR2 = OFF      // Table Read Protection Block 2 (Block 2 (008000-00BFFFh) not protected from table reads executed in other blocks)
#pragma config EBTR3 = OFF      // Table Read Protection Block 3 (Block 3 (00C000-00FFFFh) not protected from table reads executed in other blocks)
#pragma config EBTR4 = OFF      // Table Read Protection Block 4 (Block 4 (010000-013FFFh) not protected from table reads executed in other blocks)
#pragma config EBTR5 = OFF      // Table Read Protection Block 5 (Block 5 (014000-017FFFh) not protected from table reads executed in other blocks)
#pragma config EBTR6 = OFF      // Table Read Protection Block 6 (Block 6 (018000-01BFFFh) not protected from table reads executed in other blocks)
#pragma config EBTR7 = OFF      // Table Read Protection Block 7 (Block 7 (01C000-01FFFFh) not protected from table reads executed in other blocks)

// CONFIG6H
#pragma config EBTRB = OFF      // Boot Block Table Read Protection bit (Boot Block (000000-0007FFh) not protected from table reads executed in other blocks)
