IMD555/BTKB/Software/BTKB.X/system.c

/******************************************************************************/
/*Files to Include                                                            */
/******************************************************************************/

    #include <xc.h>         /* XC8 General Include File */

#include <stdint.h>         /* For uint8_t definition */
#include <stdbool.h>        /* For true/false definition */

#include "system.h"

/* Refer to the device datasheet for information about available
oscillator configurations. */
void ConfigureOscillator(void)
{
    /* TODO Add clock switching code if appropriate.  */

    /* Typical actions in this function are to tweak the oscillator tuning
    register, select new clock sources, and to wait until new clock sources
    are stable before resuming execution of the main project. */\
	
	
    // NOSC HFINTOSC; NDIV 1; 
    OSCCON1 = 0x60;
    // CSWHOLD may proceed; SOSCPWR Low power; 
    OSCCON3 = 0x00;
    // MFOEN disabled; LFOEN disabled; ADOEN disabled; SOSCEN disabled; EXTOEN disabled; HFOEN disabled; 
    OSCEN = 0x00;
    // HFFRQ 16_MHz; 
    OSCFRQ = 0x05;
    // TUN 0; 
    OSCTUNE = 0x00;
}
